rsmithamazon/F1Tower/Designs+Requirements/end_states_final.md

# Split Flap F1 — End States (Final)

## Grid: 5 Columns × 5 Rows (25 units)

---

## ALL END STATES

### 1. Driver Standings (Names)

```
[ 1] [🔴] [N] [O] [R]
[ 2] [◇ ] [L] [E] [C]
[ 3] [★ ] [V] [E] [R]
[ 4] [→ ] [H] [A] [M]
[ 5] [⬡ ] [P] [I] [A]
```

Used: Default race/practice view, standings display

### 2. Driver Standings (Points)

```
[ 1] [🔴] [3] [2] [1]
[ 2] [◇ ] [2] [8] [9]
[ 3] [★ ] [2] [7] [5]
[ 4] [→ ] [2] [5] [0]
[ 5] [⬡ ] [2] [1] [8]
```

Used: Standings cycle (alternates with names)

### 3. Driver Standings (Gap/Time)

```
[+ ] [🔴] [0] [5] [9]
[+ ] [◇ ] [1] [0] [6]
[+ ] [★ ] [1] [1] [7]
[+ ] [→ ] [1] [5] [0]
[+ ] [⬡ ] [3] [1] [3]
```

Used: Practice/Quali gap display

### 4. Name + Gap (2 Rows Per Driver)

```
[ 1] [🔴] [N] [O] [R]
[  ] [- ] [0] [5] [9]
[ 2] [◇ ] [L] [E] [C]
[  ] [- ] [1] [0] [6]
[ 3] [★ ] [V] [E] [R]
```

Used: Detailed timing view (shows 2–3 drivers)

### 5. Constructor Standings (Names)

```
[ 1] [🔴] [F] [E] [R]
[ 2] [→ ] [M] [C] [L]
[ 3] [◇ ] [M] [E] [R]
[ 4] [★ ] [R] [B] [L]
[ 5] [AM] [A] [M] [R]
```

Used: Post-session, standings cycle

### 6. Constructor Standings (Points)

```
[ 1] [🔴] [6] [5] [2]
[ 2] [→ ] [5] [8] [1]
[ 3] [◇ ] [5] [4] [3]
[ 4] [★ ] [4] [9] [2]
[ 5] [AM] [3] [2] [1]
```

Used: Standings cycle (alternates with names)

### 7. Single Driver Focus

```
[🔴] [RED] [RED] [RED] [RED]
[ 1] [🔴] [N]   [O]   [R]
[PUR] [1]  [.]   [1]   [5]
[GRN] [2]  [8]   [.]   [3]
[YEL] [3]  [1]   [.]   [2]
```

Used: Post-quali highlight, replay, fastest lap detail

### 8. Name + Tire/Penalty Color

```
[ 1] [🔴] [N] [O] [RED ]
[ 2] [◇ ] [L] [E] [RED ]
[ 3] [★ ] [V] [E] [YEL ]
[ 4] [→ ] [H] [A] [WHT ]
[ 5] [⬡ ] [P] [I] [GRN ]
```

Used: Race strategy view (showing tire compounds)

### 9. Checkered Flag

```
[BLK] [WHT] [BLK] [WHT] [BLK]
[WHT] [BLK] [WHT] [BLK] [WHT]
[BLK] [WHT] [BLK] [WHT] [BLK]
[WHT] [BLK] [WHT] [BLK] [WHT]
[BLK] [WHT] [BLK] [WHT] [BLK]
```

Used: Race finish

### 10. All Red (Red Flag)

```
[RED] [RED] [RED] [RED] [RED]
[RED] [RED] [RED] [RED] [RED]
[RED] [RED] [RED] [RED] [RED]
[RED] [RED] [RED] [RED] [RED]
[RED] [RED] [RED] [RED] [RED]
```

Used: Red flag — instant transition in

### 11. All Yellow (Yellow Flag)

```
[YEL] [YEL] [YEL] [YEL] [YEL]
[YEL] [YEL] [YEL] [YEL] [YEL]
[YEL] [YEL] [YEL] [YEL] [YEL]
[YEL] [YEL] [YEL] [YEL] [YEL]
[YEL] [YEL] [YEL] [YEL] [YEL]
```

Used: Yellow flag — instant transition in

### 12. Safety Car / VSC (Yellow + Text)

```
[YEL] [YEL] [YEL] [YEL] [YEL]
[YEL] [S]   [A]   [F]   [E]
[YEL] [T]   [Y]   [YEL] [YEL]
[YEL] [C]   [A]   [R]   [YEL]
[YEL] [YEL] [YEL] [YEL] [YEL]
```

VSC variant:
```
[YEL] [YEL] [YEL] [YEL] [YEL]
[YEL] [YEL] [V]   [S]   [C]
[YEL] [YEL] [YEL] [YEL] [YEL]
[YEL] [YEL] [YEL] [YEL] [YEL]
[YEL] [YEL] [YEL] [YEL] [YEL]
```

Used: Safety car / virtual safety car deployed

### 13. All Purple (Fastest Lap Flash)

```
[PUR] [PUR] [PUR] [PUR] [PUR]
[PUR] [PUR] [PUR] [PUR] [PUR]
[PUR] [PUR] [PUR] [PUR] [PUR]
[PUR] [PUR] [PUR] [PUR] [PUR]
[PUR] [PUR] [PUR] [PUR] [PUR]
```

Used: Brief flash when fastest lap is set, then resolves to standings or single driver focus

### 14. All Green (Green Flag / Go)

```
[GRN] [GRN] [GRN] [GRN] [GRN]
[GRN] [GRN] [GRN] [GRN] [GRN]
[GRN] [GRN] [GRN] [GRN] [GRN]
[GRN] [GRN] [GRN] [GRN] [GRN]
[GRN] [GRN] [GRN] [GRN] [GRN]
```

Used: Session start, green flag, race resumed

### 15. All Black (Off / Sleep)

```
[BLK] [BLK] [BLK] [BLK] [BLK]
[BLK] [BLK] [BLK] [BLK] [BLK]
[BLK] [BLK] [BLK] [BLK] [BLK]
[BLK] [BLK] [BLK] [BLK] [BLK]
[BLK] [BLK] [BLK] [BLK] [BLK]
```

Used: Device off state, sleep, pre-startup

### 16. All White (Lights Out / Device On)

```
[WHT] [WHT] [WHT] [WHT] [WHT]
[WHT] [WHT] [WHT] [WHT] [WHT]
[WHT] [WHT] [WHT] [WHT] [WHT]
[WHT] [WHT] [WHT] [WHT] [WHT]
[WHT] [WHT] [WHT] [WHT] [WHT]
```

Used: Lights out resolution + device startup (black → white = "waking up")

### 17. Lights Out Sequence (Race Start)

```
Step 1: [RED] [BLK] [BLK] [BLK] [BLK]  ← 1 light (row 1 → red)
        [BLK] [BLK] [BLK] [BLK] [BLK]
        ...

Step 2: [RED] [RED] [RED] [RED] [RED]   ← row 1 full red
        [RED] [BLK] [BLK] [BLK] [BLK]  ← row 2 starts
        ...

Step 5: ALL RED (5×5)                    ← 5 lights on!
        ... pause ...

Step 6: ALL WHITE                        ← LIGHTS OUT! (red → white = go!)
```

Flap order supports this: colors go dark → light on the drum. Red is before White in drum order, so red → white is a forward flip (fast).

Used: Race start ceremony. Also used as device power-on animation (black → red → white → first display).

### 18. Qualifying Elimination

```
[GRN] [🔴] [N] [O] [R]   ← made it (green)
[GRN] [◇ ] [L] [E] [C]
[GRN] [★ ] [V] [E] [R]
[RED] [→ ] [S] [T] [R]   ← eliminated (red)
[RED] [⬡ ] [B] [E] [A]
```

Used: End of Q1, Q2 rounds

### 19. Race Winner Celebration

```
[ 🏆] [🔴] [RED] [RED] [RED]
[ 1 ] [🔴] [N]   [O]   [R]
[BLK] [BLK] [BLK] [BLK] [BLK]
[ 2 ] [◇ ] [L]   [E]   [C]
[ 3 ] [★ ] [V]   [E]   [R]
```

Used: Post-finish celebration, after checkered + car animation

### 20. Fastest Lap Display

```
[PUR] [PUR] [PUR] [PUR] [PUR]
[ P ] [🔴] [N]   [O]   [R]
[PUR] [1]  [.]   [1]   [5]
[PUR] [9]  [1]   [2]   [PUR]
[PUR] [PUR] [PUR] [PUR] [PUR]
```

Used: After fastest lap is set (follows purple flash)

### 21. Pit Stop (Per Driver Row)

```
[ 1] [🔴] [N] [O] [R]
[ 2] [◇ ] [P] [I] [T]   ← Leclerc in pit (logo stays)
[ 3] [★ ] [V] [E] [R]
[ 4] [→ ] [H] [A] [M]
[ 5] [⬡ ] [P] [I] [A]
```

Used: While driver is in pit lane (single row change)

### 22. Tire Change Indicator (Per Driver)

```
[ 1] [🔴] [N] [O] [R]
[RED] [◇ ] [L] [E] [C]   ← Col 0 shows tire color (soft=red), 5 sec
[ 3] [★ ] [V] [E] [R]
[ 4] [→ ] [H] [A] [M]
[ 5] [⬡ ] [P] [I] [A]
```

Used: After pit exit, shows new compound for 5 sec then back to position number

---

## FLAP DRUM ORDER NOTE

Colors are ordered **dark to light** on the drum:

```
... [Black] → [Red] → [Blue] → [Green] → [Purple] → [Orange] → [Yellow] → [White] ...
```

This ensures:
- Black → any color = forward (fast)
- Red → White = forward (lights out sequence is fast)
- Any color → Black = wraps around (acceptable, used for shutdown)
- Device on: Black (off) → White (on) = forward through all colors = natural "wake up" cascade

---

## END STATE COUNT: 22 TOTAL

| Category | States |
|---|---|
| Standings | 6 (driver name/points/gap, constructor name/points, name+gap 2-row) |
| Detail views | 3 (single driver, tire strategy, quali elimination) |
| Race events | 3 (pit stop, tire change, winner celebration) |
| Flags/Status | 7 (red, yellow, green, purple, SC/VSC, checkered, fastest lap) |
| Utility | 3 (all black, all white, lights out sequence) |
| **Total** | **22** |

---

## POWER ON SEQUENCE

```
1. Device powers on → all flaps at rest (wherever they stopped = random)
2. Home all motors (hall sensor calibration)
3. All go to BLACK (off state) — clean slate
4. Transition: BLACK → WHITE (lights on / wake up)
5. Transition from WHITE → first display mode (selectable: rainbow, cascade, etc.)
```

## POWER OFF SEQUENCE

```
1. Current display → ALL BLACK (cascade down or instant)
2. Motors off
```
