rsmithamazon/F1Tower/Designs+Requirements/Flap dimesnsions.png

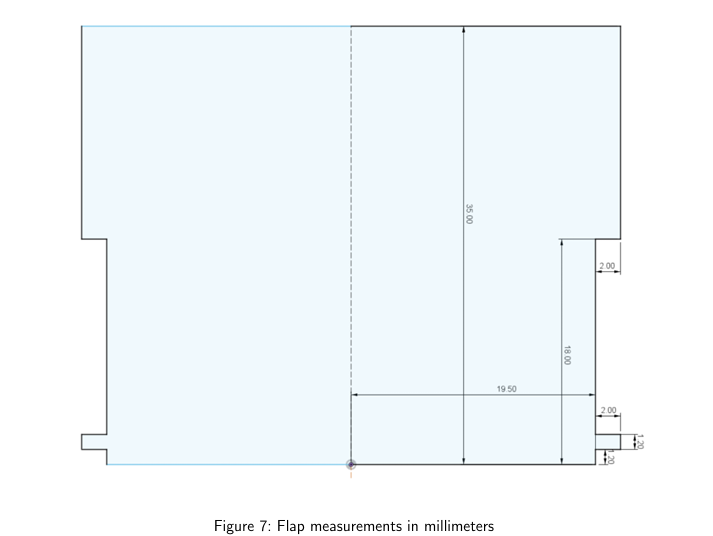
Designs+Requirements/Flap dimesnsions.png
