rsmithamazon/F1Tower/Designs+Requirements/FlapDimensions.png

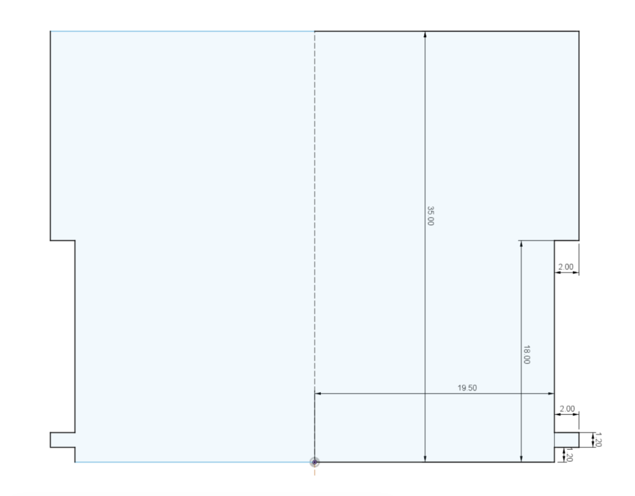
Designs+Requirements/FlapDimensions.png
