rsmithamazon/F1Tower/Split Flap Cut Sheet/Column 0/Flap 3 Yellow/Flap 3 Yellow split_flap_view.png

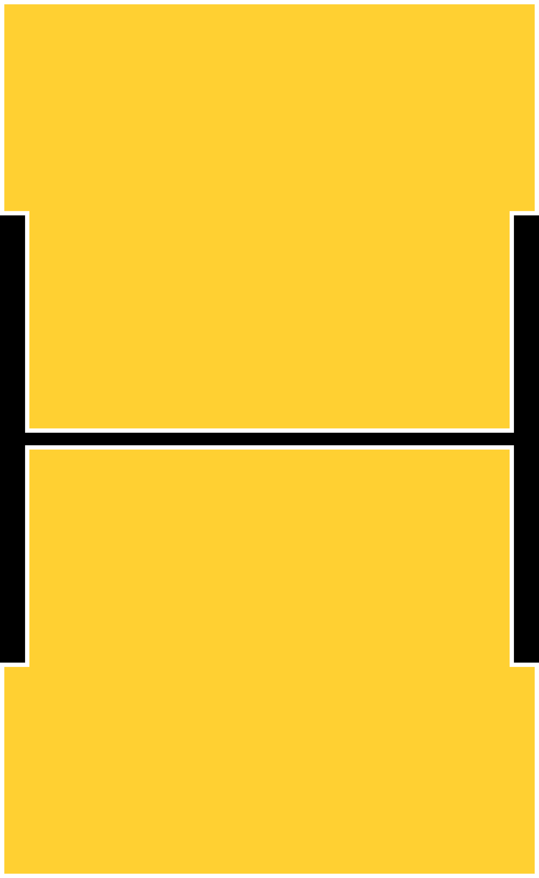
Split Flap Cut Sheet/Column 0/Flap 3 Yellow/Flap 3 Yellow split_flap_view.png
