rsmithamazon/F1Tower/Split Flap Cut Sheet/Column 0/Flap 12 Num 4/Flap 12 Num 4 split_flap_view.png

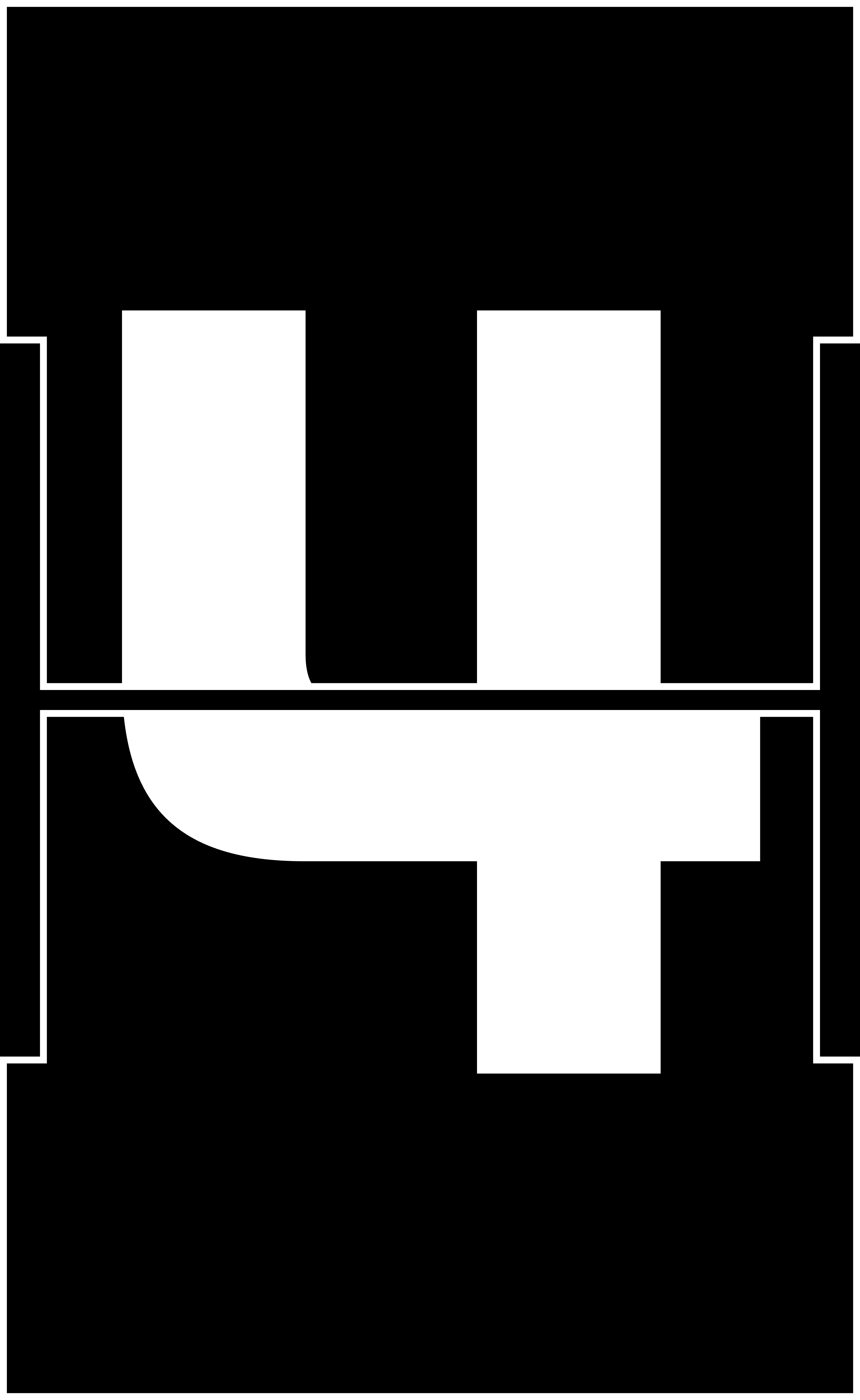
Split Flap Cut Sheet/Column 0/Flap 12 Num 4/Flap 12 Num 4 split_flap_view.png
