rsmithamazon/F1Tower/Split Flap Cut Sheet/Column 0/Flap 14 Num 6/Flap 14 Num 6 split_flap_view.png

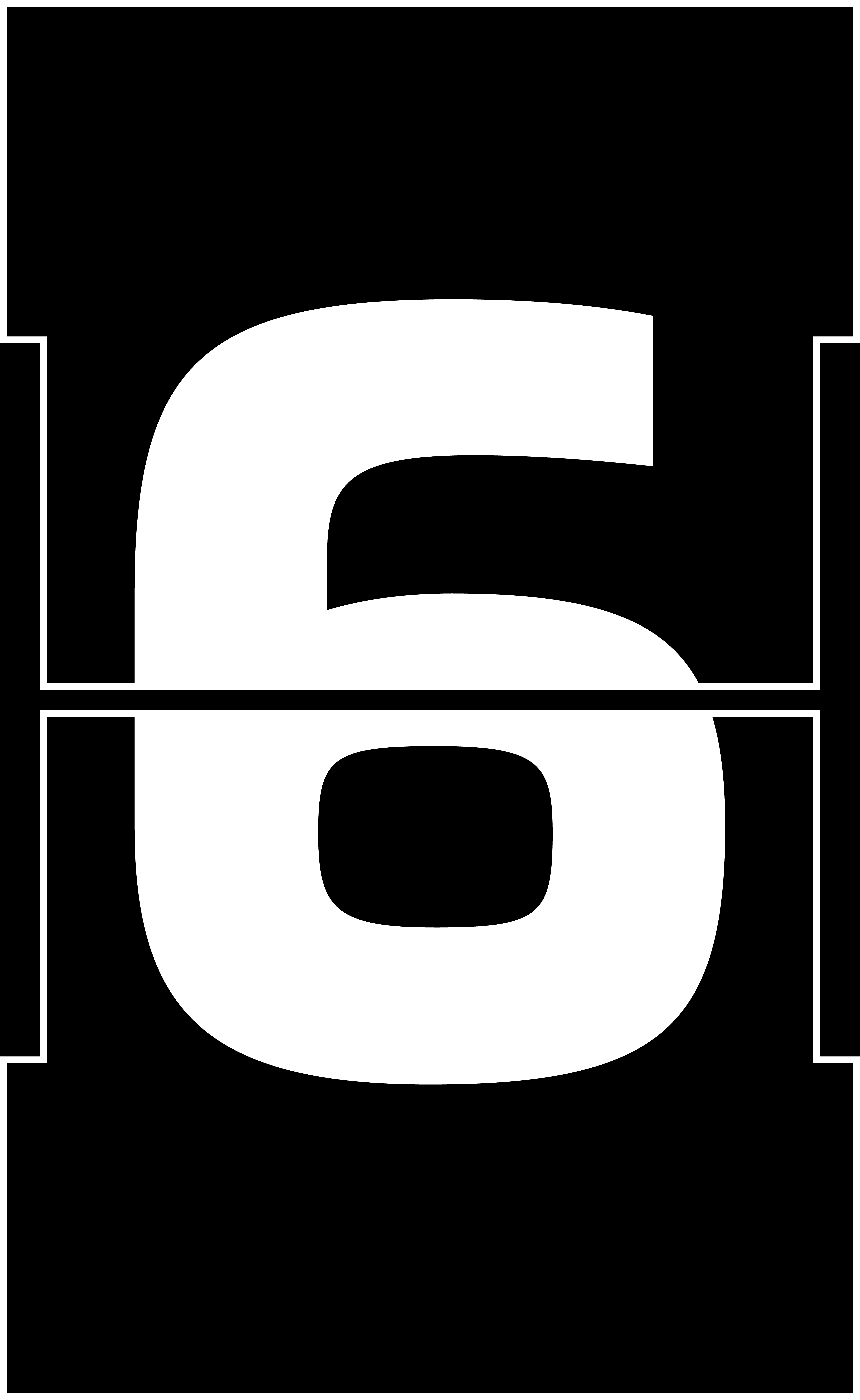
Split Flap Cut Sheet/Column 0/Flap 14 Num 6/Flap 14 Num 6 split_flap_view.png
