rsmithamazon/F1Tower/Split Flap Cut Sheet/Column 0/Flap 15 Num 7/Flap 15 Num 7 split_flap_view.png

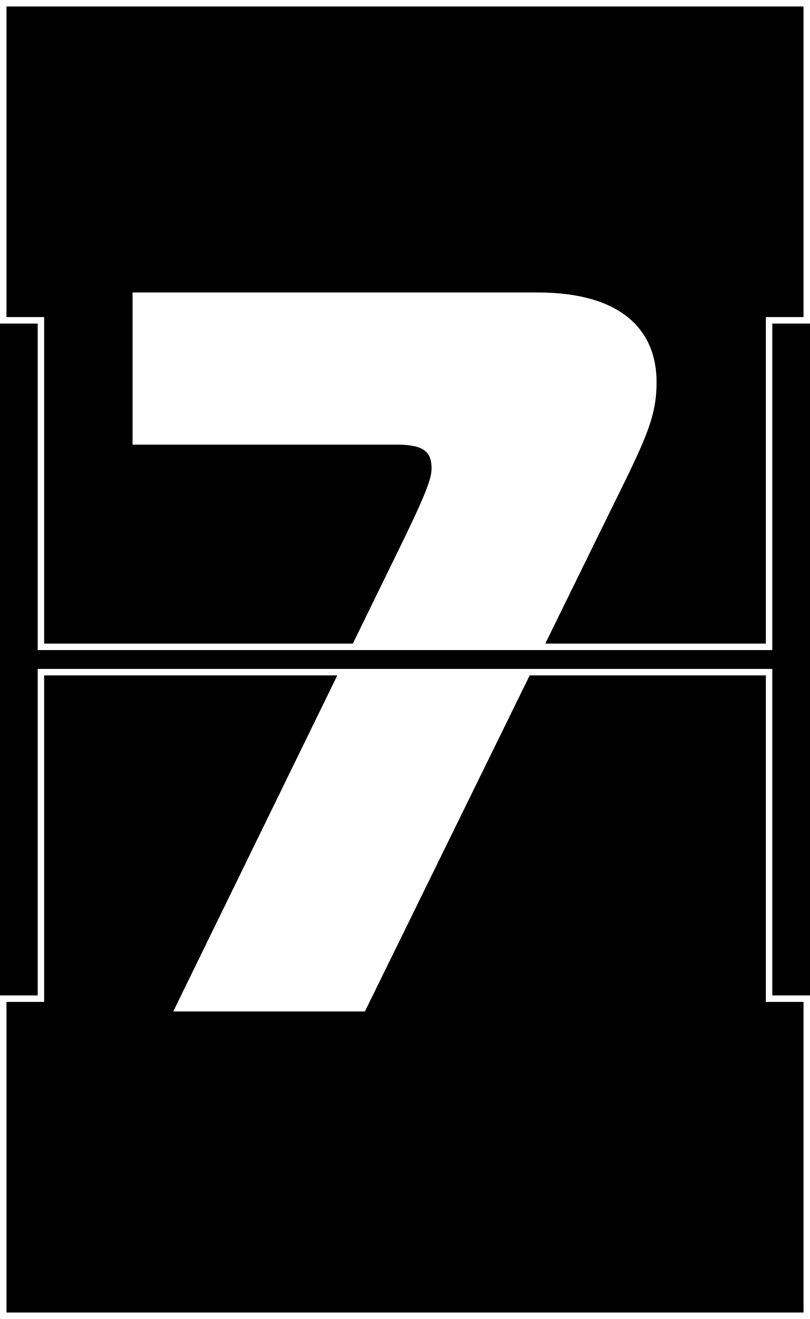
Split Flap Cut Sheet/Column 0/Flap 15 Num 7/Flap 15 Num 7 split_flap_view.png
