rsmithamazon/F1Tower/Split Flap Cut Sheet/Column 0/Flap 22 Mercedes/Flap 22 Mercedes split_flap_view.png

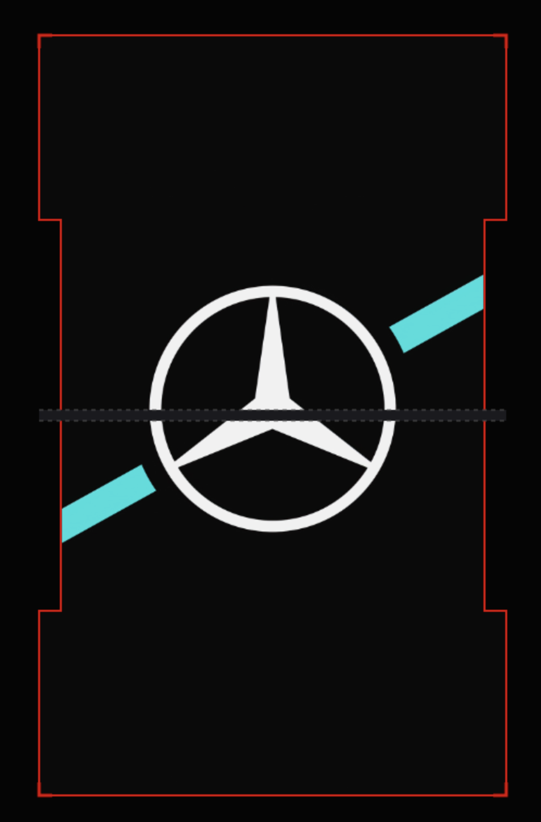
Split Flap Cut Sheet/Column 0/Flap 22 Mercedes/Flap 22 Mercedes split_flap_view.png
