rsmithamazon/F1Tower/Split Flap Cut Sheet/Column 0/Flap 23 Haas/Flap 23 Haas split_flap_view.png

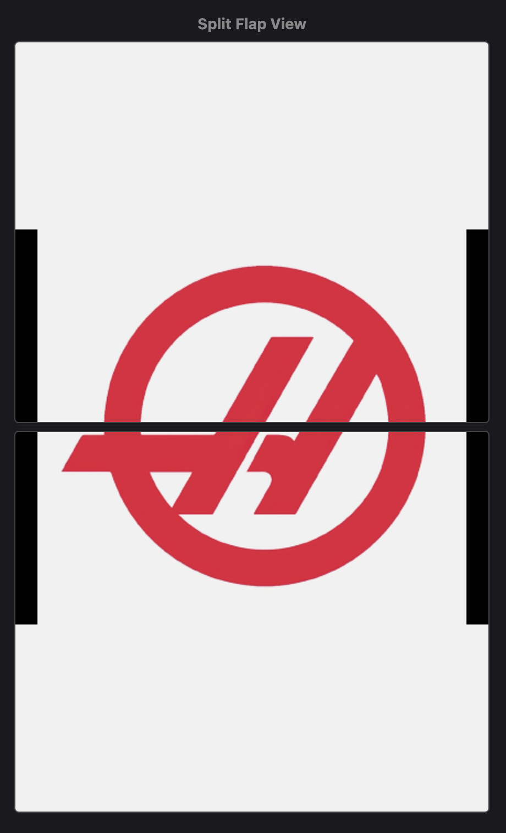
Split Flap Cut Sheet/Column 0/Flap 23 Haas/Flap 23 Haas split_flap_view.png
