rsmithamazon/F1Tower/Split Flap Cut Sheet/Column 0/Flap 24 Alpine/Flap 24 Alpine split_flap_view.png

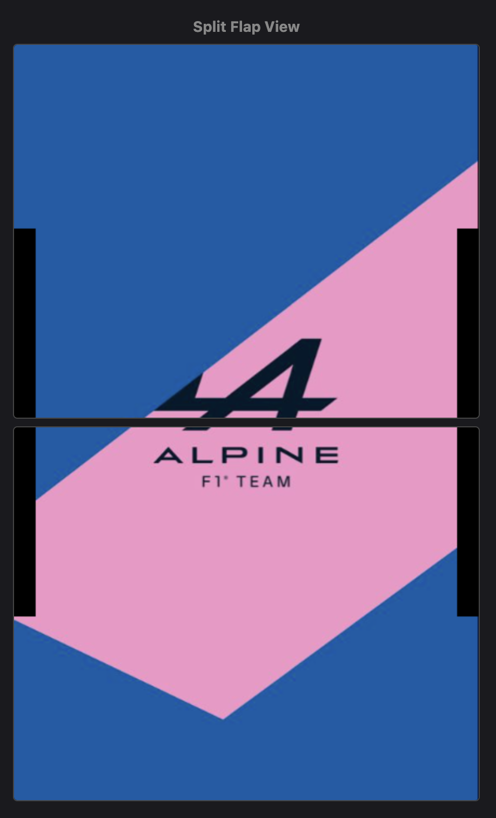
Split Flap Cut Sheet/Column 0/Flap 24 Alpine/Flap 24 Alpine split_flap_view.png
