rsmithamazon/F1Tower/Split Flap Cut Sheet/Column 0/Flap 31 USA/Flap 31 USA split_flap_view.png

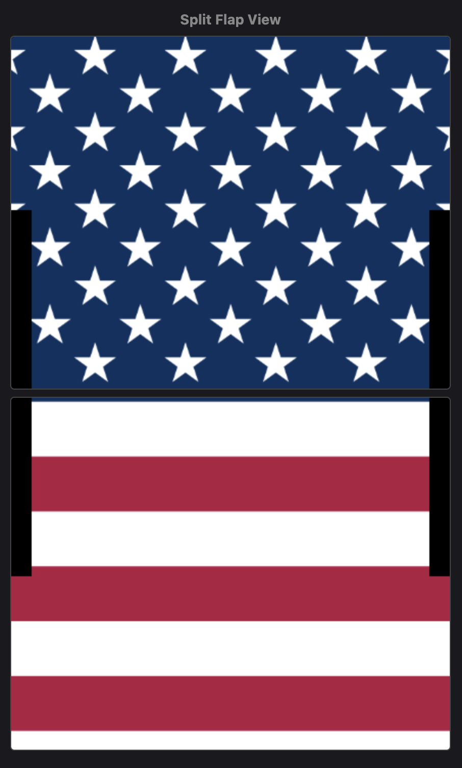
Split Flap Cut Sheet/Column 0/Flap 31 USA/Flap 31 USA split_flap_view.png
