rsmithamazon/F1Tower/Split Flap Cut Sheet/Column 0/Flap 36 Mexico/Flap 36 Mexico split_flap_view.png

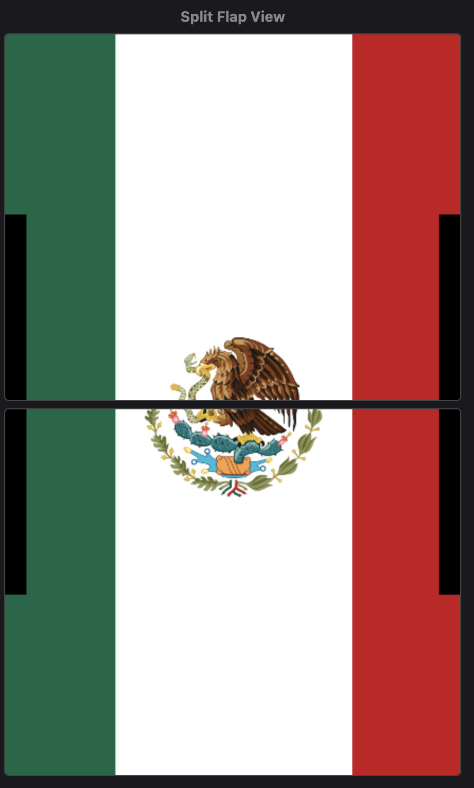
Split Flap Cut Sheet/Column 0/Flap 36 Mexico/Flap 36 Mexico split_flap_view.png
