rsmithamazon/F1Tower/Split Flap Cut Sheet/Column 0/Flap 38 UAE/Flap 38 UAE split_flap_view.png

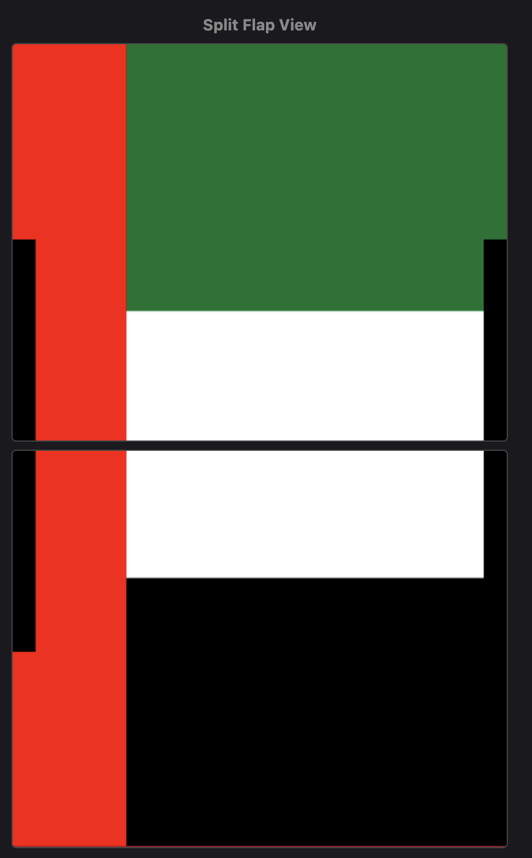
Split Flap Cut Sheet/Column 0/Flap 38 UAE/Flap 38 UAE split_flap_view.png
