rsmithamazon/F1Tower/Split Flap Cut Sheet/Column 0/Flap 40 Bahrain/Flap 40 Bahrain split_flap_view.png

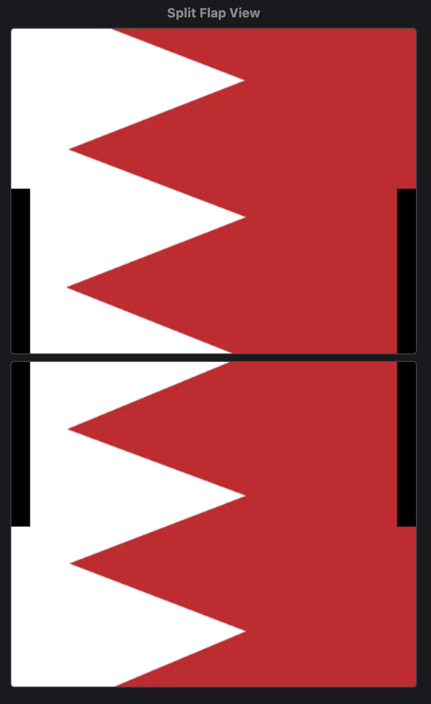
Split Flap Cut Sheet/Column 0/Flap 40 Bahrain/Flap 40 Bahrain split_flap_view.png
