rsmithamazon/F1Tower/Split Flap Cut Sheet/Column 0/Flap 43 Spain/Flap 43 Spain split_flap_view.png

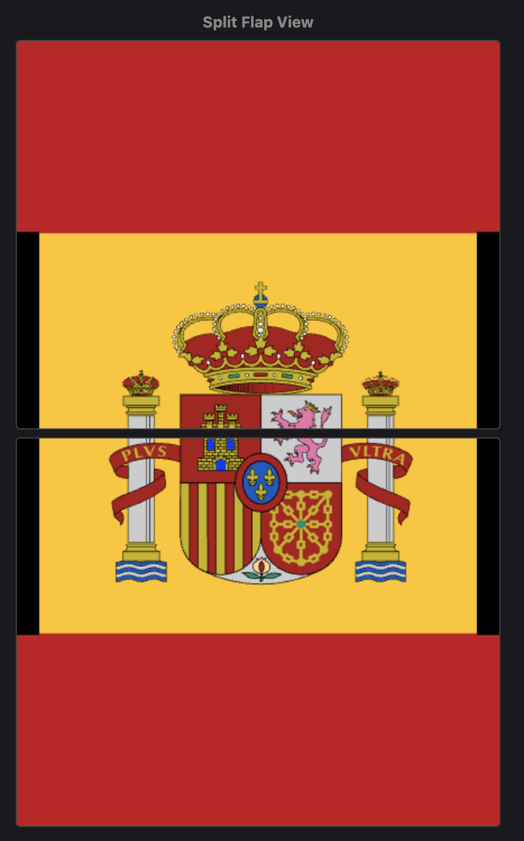
Split Flap Cut Sheet/Column 0/Flap 43 Spain/Flap 43 Spain split_flap_view.png
