rsmithamazon/F1Tower/Split Flap Cut Sheet/Column 0/Flap 49 UK/Flap 49 UK split_flap_view.png

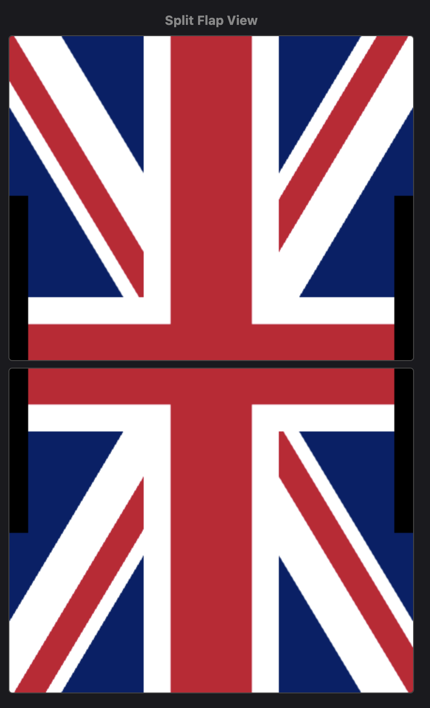
Split Flap Cut Sheet/Column 0/Flap 49 UK/Flap 49 UK split_flap_view.png
