rsmithamazon/F1Tower/Split Flap Cut Sheet/Column 0/Flap 50 Italy/Flap 50 Italy split_flap_view_2.png

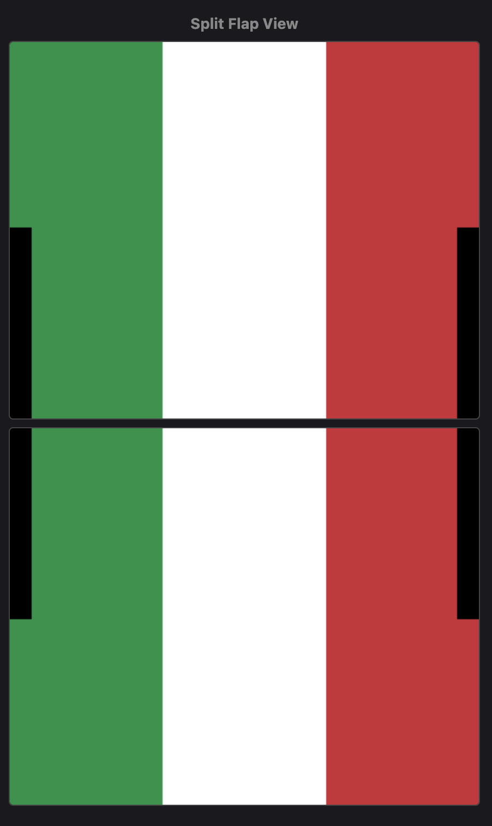
Split Flap Cut Sheet/Column 0/Flap 50 Italy/Flap 50 Italy split_flap_view_2.png
