rsmithamazon/F1Tower/Split Flap Cut Sheet/Column 1/Flap 18 Letter A/Flap 18 Letter A split_flap_view.png

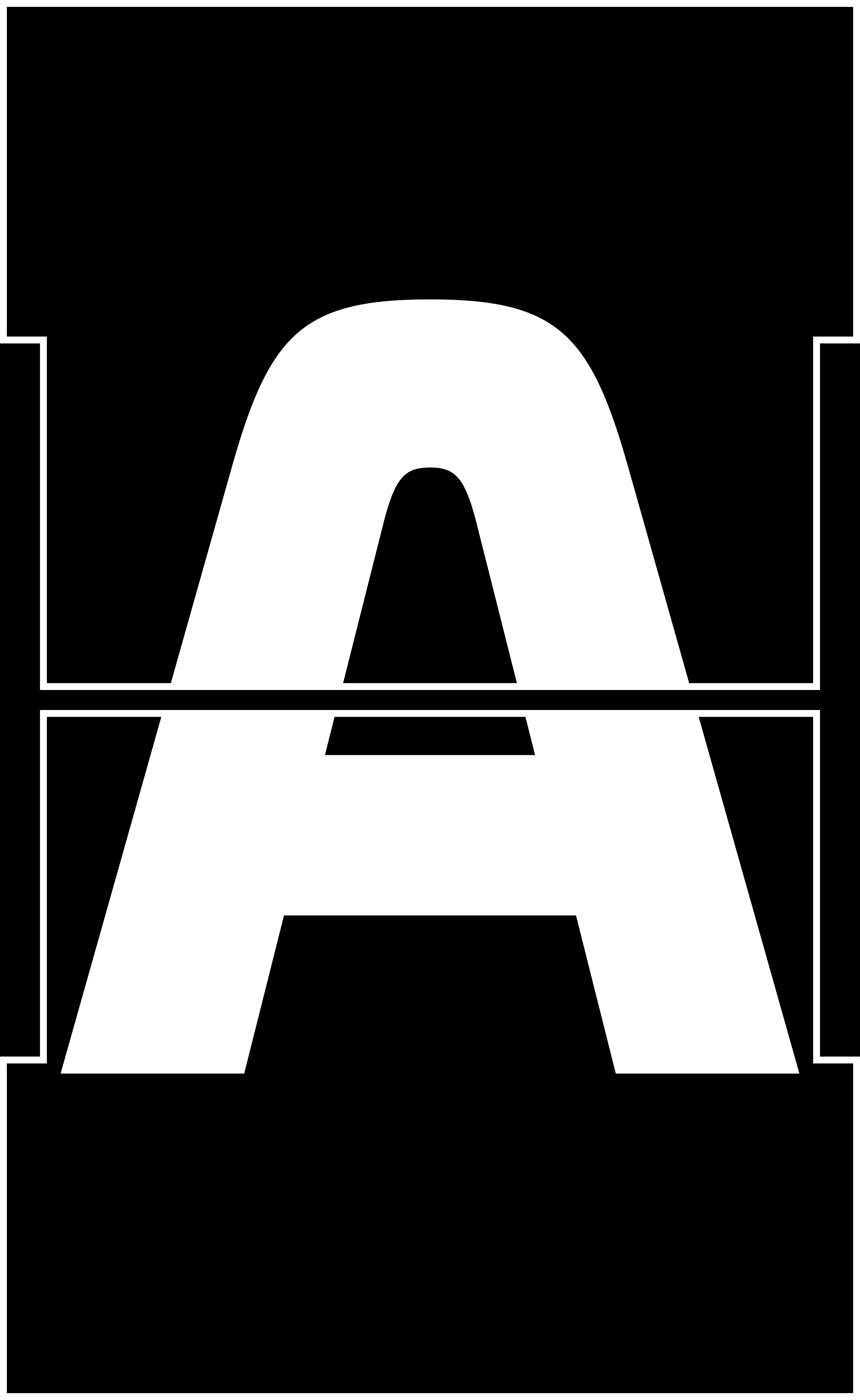
Split Flap Cut Sheet/Column 1/Flap 18 Letter A/Flap 18 Letter A split_flap_view.png
