rsmithamazon/F1Tower/Split Flap Cut Sheet/Column 1/Flap 24 Letter G/Flap 24 Letter G split_flap_view.png

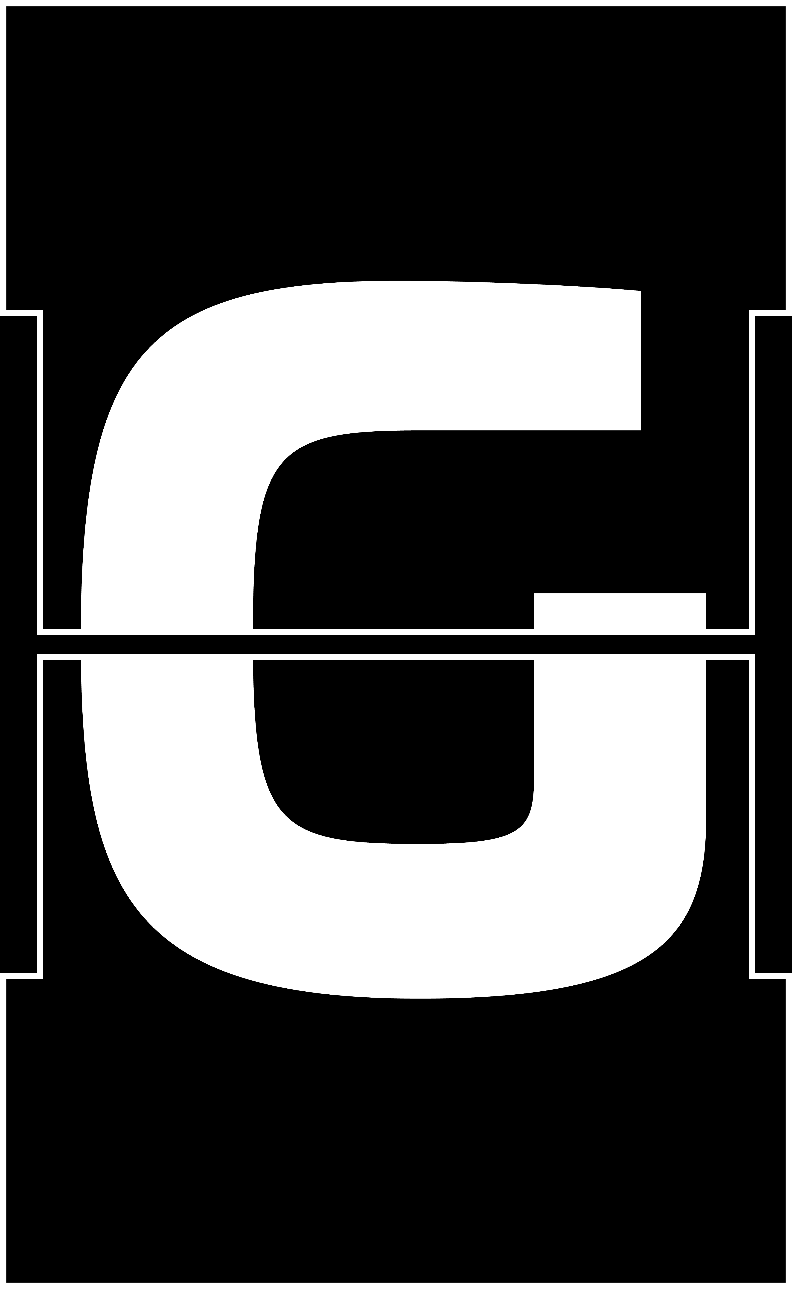
Split Flap Cut Sheet/Column 1/Flap 24 Letter G/Flap 24 Letter G split_flap_view.png
