rsmithamazon/F1Tower/Split Flap Cut Sheet/Column 1/Flap 27 Letter J/Flap 27 Letter J split_flap_view.png

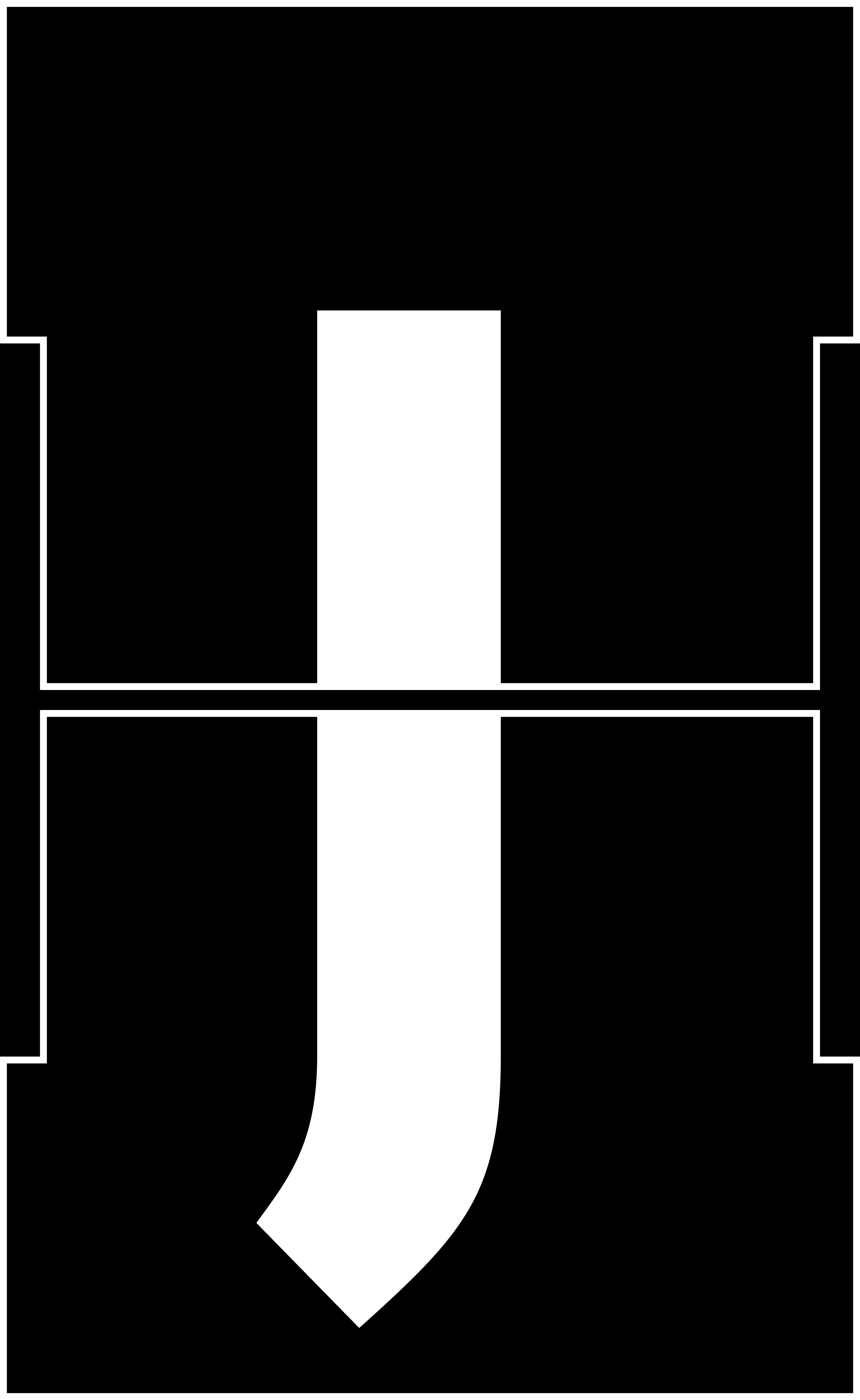
Split Flap Cut Sheet/Column 1/Flap 27 Letter J/Flap 27 Letter J split_flap_view.png
