rsmithamazon/F1Tower/Split Flap Cut Sheet/Column 1/Flap 28 Letter K/Flap 28 Letter K split_flap_view.png

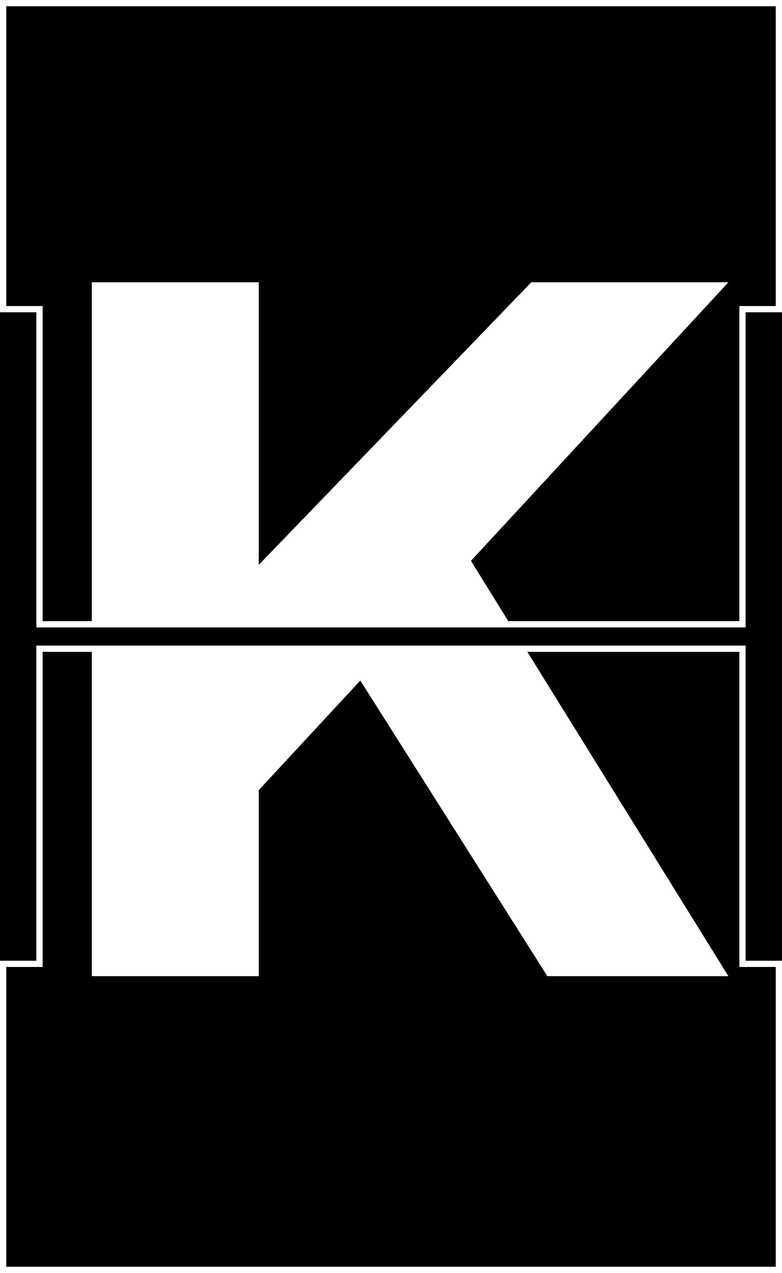
Split Flap Cut Sheet/Column 1/Flap 28 Letter K/Flap 28 Letter K split_flap_view.png
