rsmithamazon/F1Tower/Split Flap Cut Sheet/Column 1/Flap 31 Letter N/Flap 31 Letter N split_flap_view.png

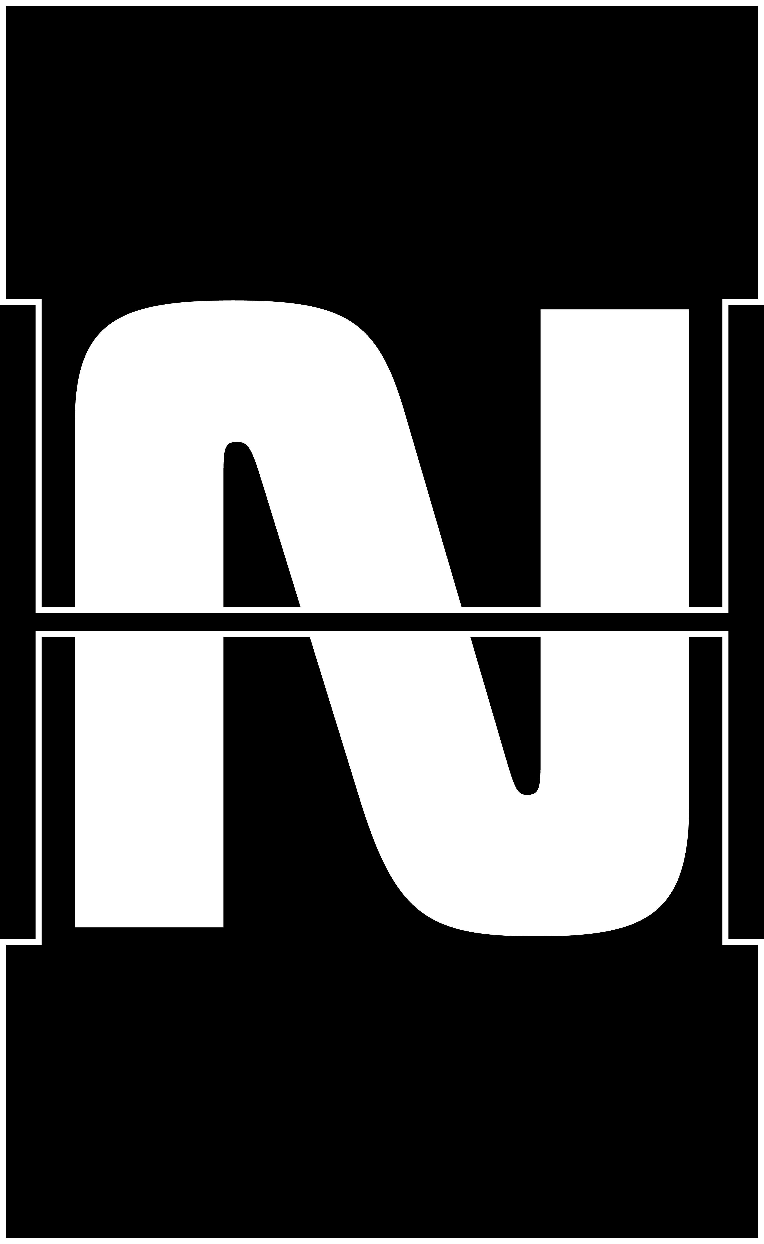
Split Flap Cut Sheet/Column 1/Flap 31 Letter N/Flap 31 Letter N split_flap_view.png
