rsmithamazon/F1Tower/Split Flap Cut Sheet/Column 1/Flap 34 Letter Q/Flap 34 Letter Q split_flap_view.png

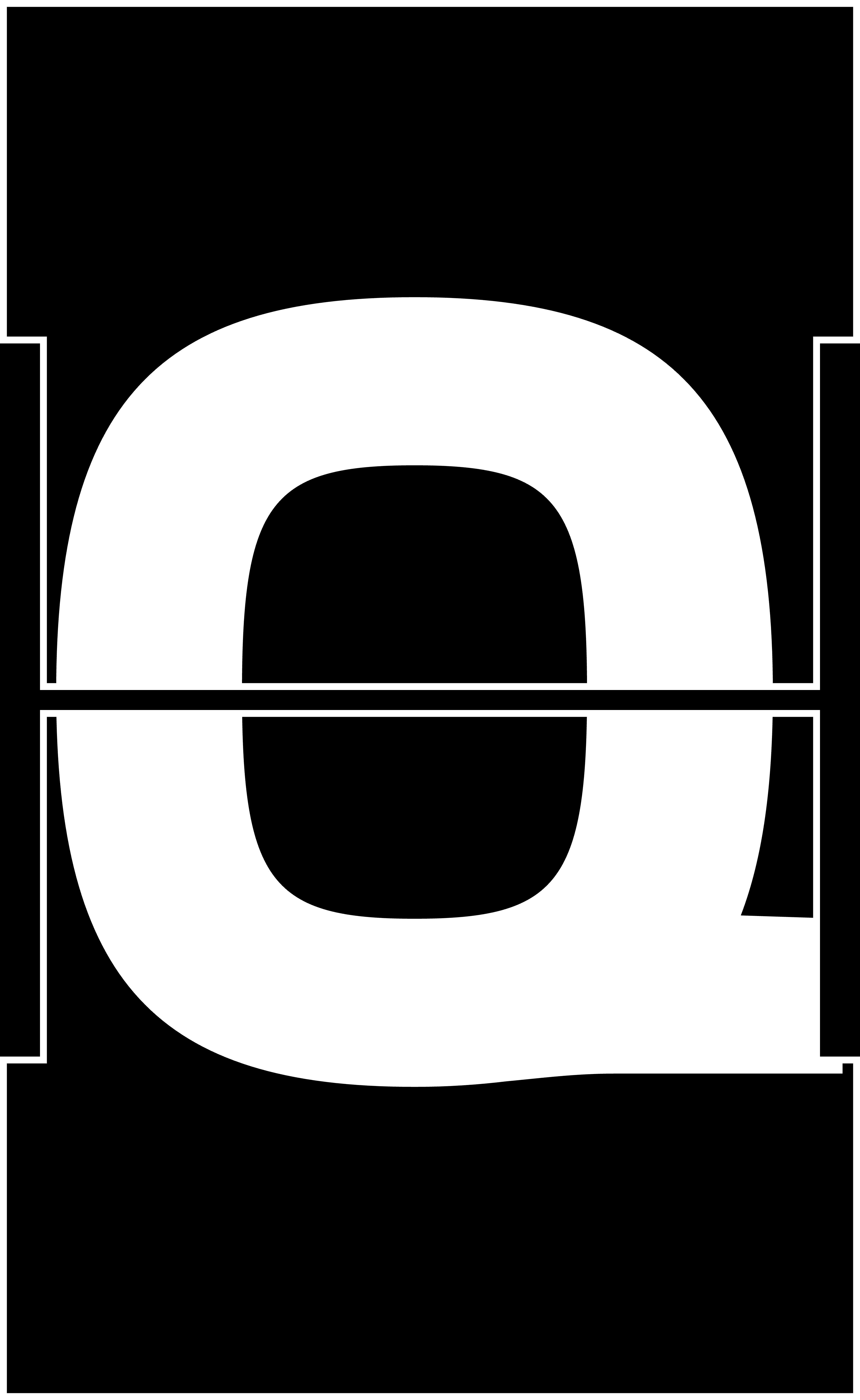
Split Flap Cut Sheet/Column 1/Flap 34 Letter Q/Flap 34 Letter Q split_flap_view.png
