rsmithamazon/F1Tower/Split Flap Cut Sheet/Column 1/Flap 39 Letter V/Flap 39 Letter V split_flap_view.png

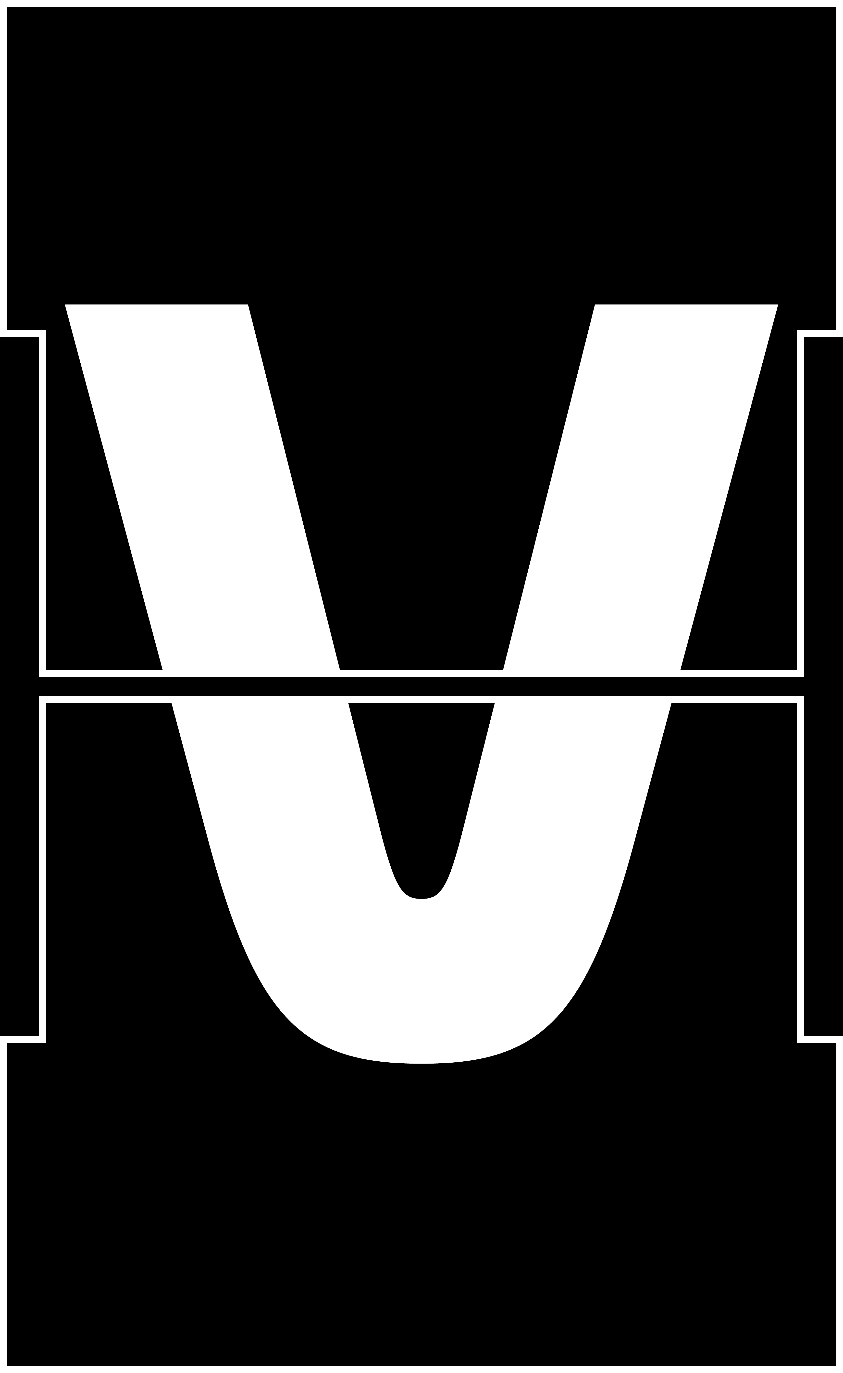
Split Flap Cut Sheet/Column 1/Flap 39 Letter V/Flap 39 Letter V split_flap_view.png
