rsmithamazon/F1Tower/Split Flap Cut Sheet/Column 1/Flap 44 Sunny/Flap 44 Sunny split_flap_view.png

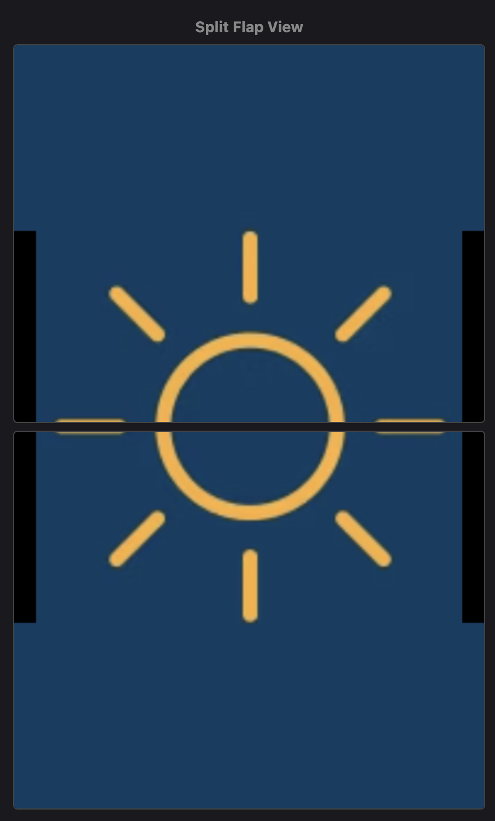
Split Flap Cut Sheet/Column 1/Flap 44 Sunny/Flap 44 Sunny split_flap_view.png
