rsmithamazon/F1Tower/Split Flap Cut Sheet/Column 1/Flap 45 Partly Cloudy/Flap 45 Partly Cloudy split_flap_view.png

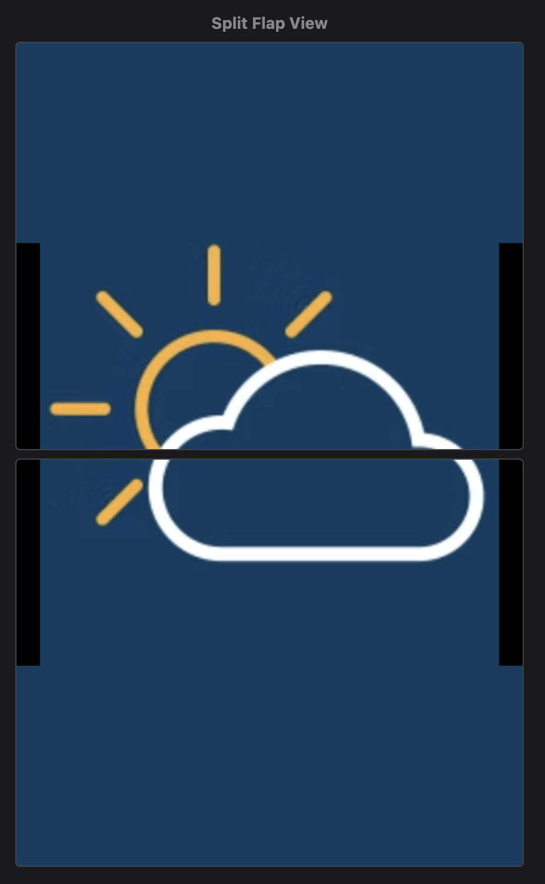
Split Flap Cut Sheet/Column 1/Flap 45 Partly Cloudy/Flap 45 Partly Cloudy split_flap_view.png
