rsmithamazon/F1Tower/Split Flap Cut Sheet/Column 1/Flap 50 Wind/Flap 50 Wind split_flap_view.png

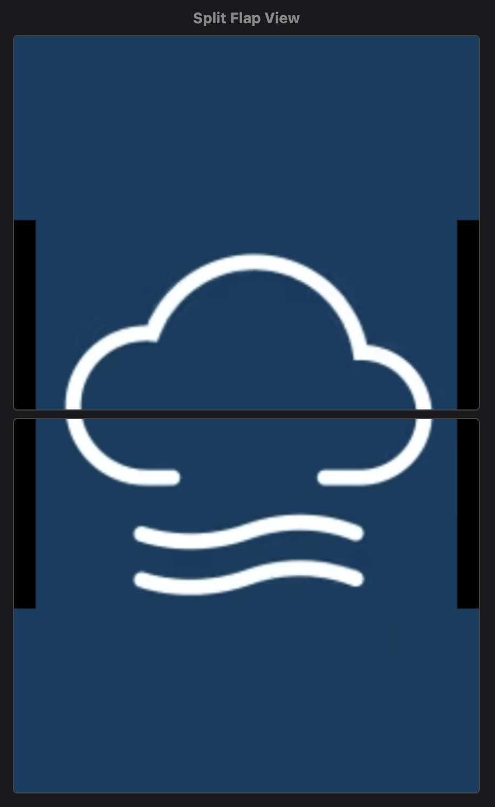
Split Flap Cut Sheet/Column 1/Flap 50 Wind/Flap 50 Wind split_flap_view.png
