rsmithamazon/F1Tower/Split Flap Cut Sheet/Column 1/Flap 51 Thermometer/Flap 51 Thermometer split_flap_view.png

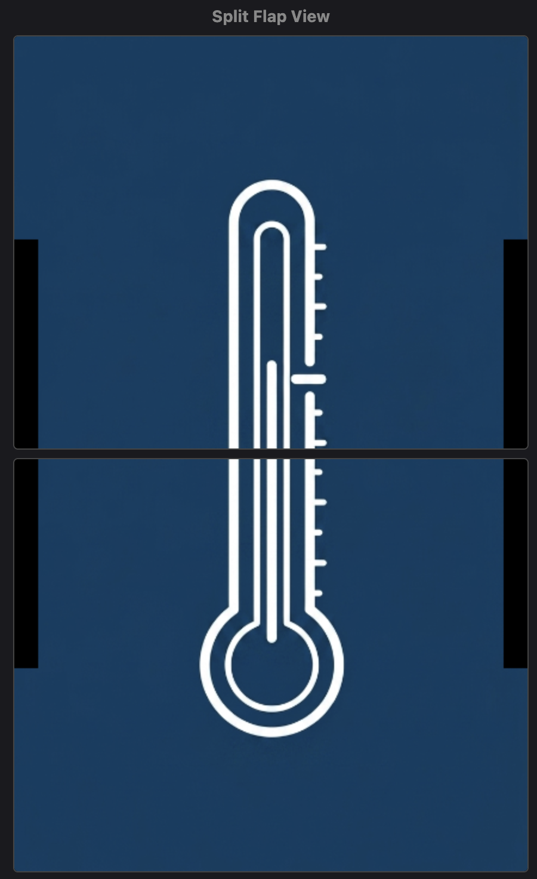
Split Flap Cut Sheet/Column 1/Flap 51 Thermometer/Flap 51 Thermometer split_flap_view.png
