rsmithamazon/F1Tower/Split Flap Cut Sheet/Column 2/Flap 21 Letter D/Flap 21 Letter D split_flap_view.png

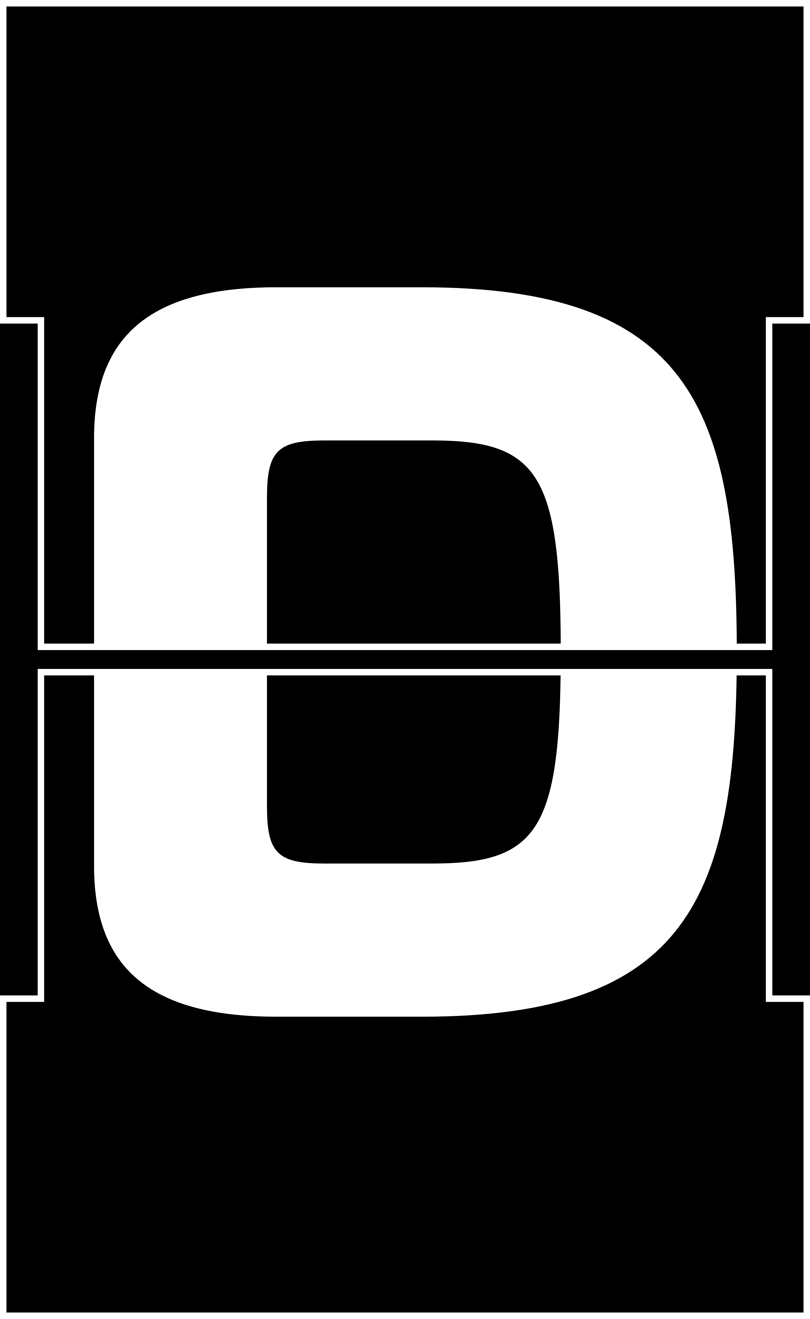
Split Flap Cut Sheet/Column 2/Flap 21 Letter D/Flap 21 Letter D split_flap_view.png
