rsmithamazon/F1Tower/Split Flap Cut Sheet/Column 2/Flap 30 Letter M/Flap 30 Letter M split_flap_view.png

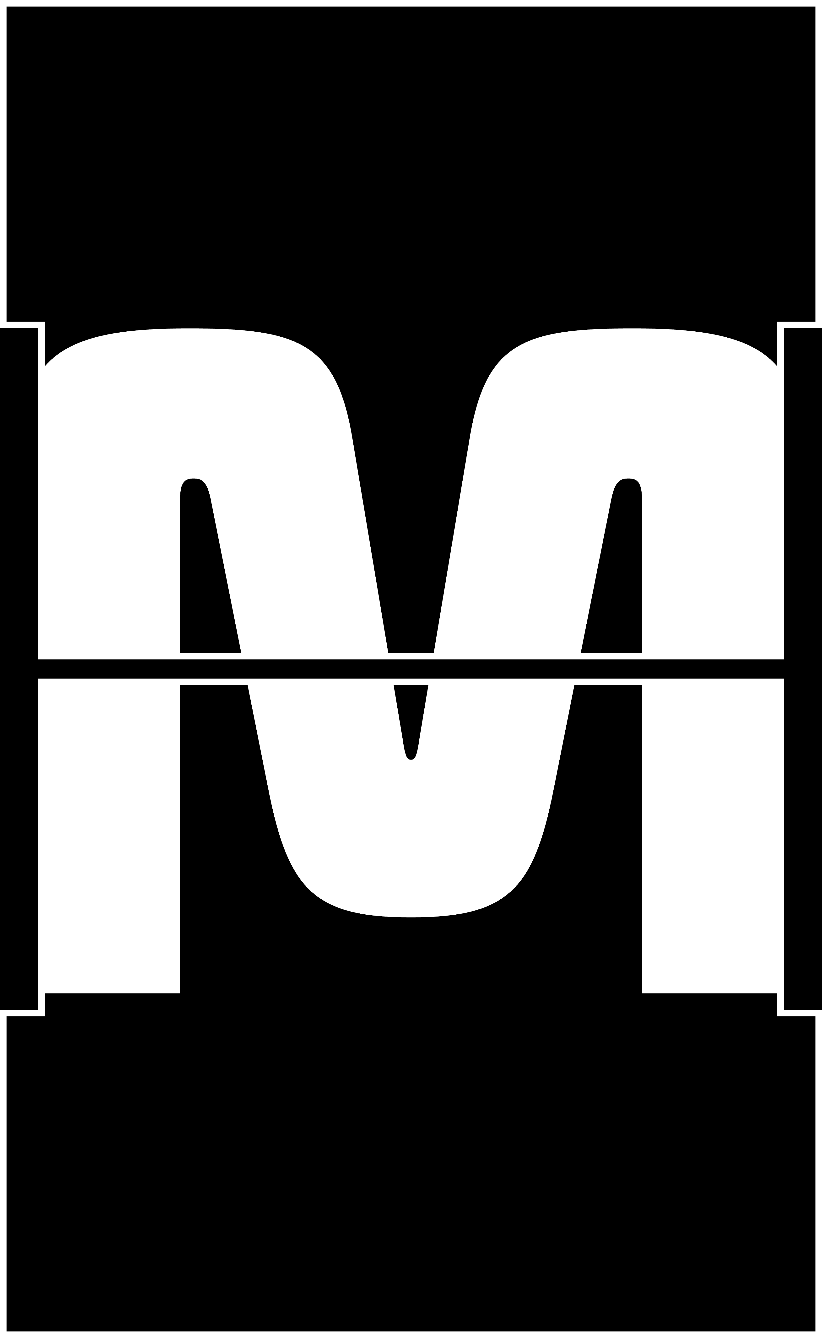
Split Flap Cut Sheet/Column 2/Flap 30 Letter M/Flap 30 Letter M split_flap_view.png
