rsmithamazon/F1Tower/Split Flap Cut Sheet/Column 2/Flap 41 Letter X/Flap 41 Letter X split_flap_view.png

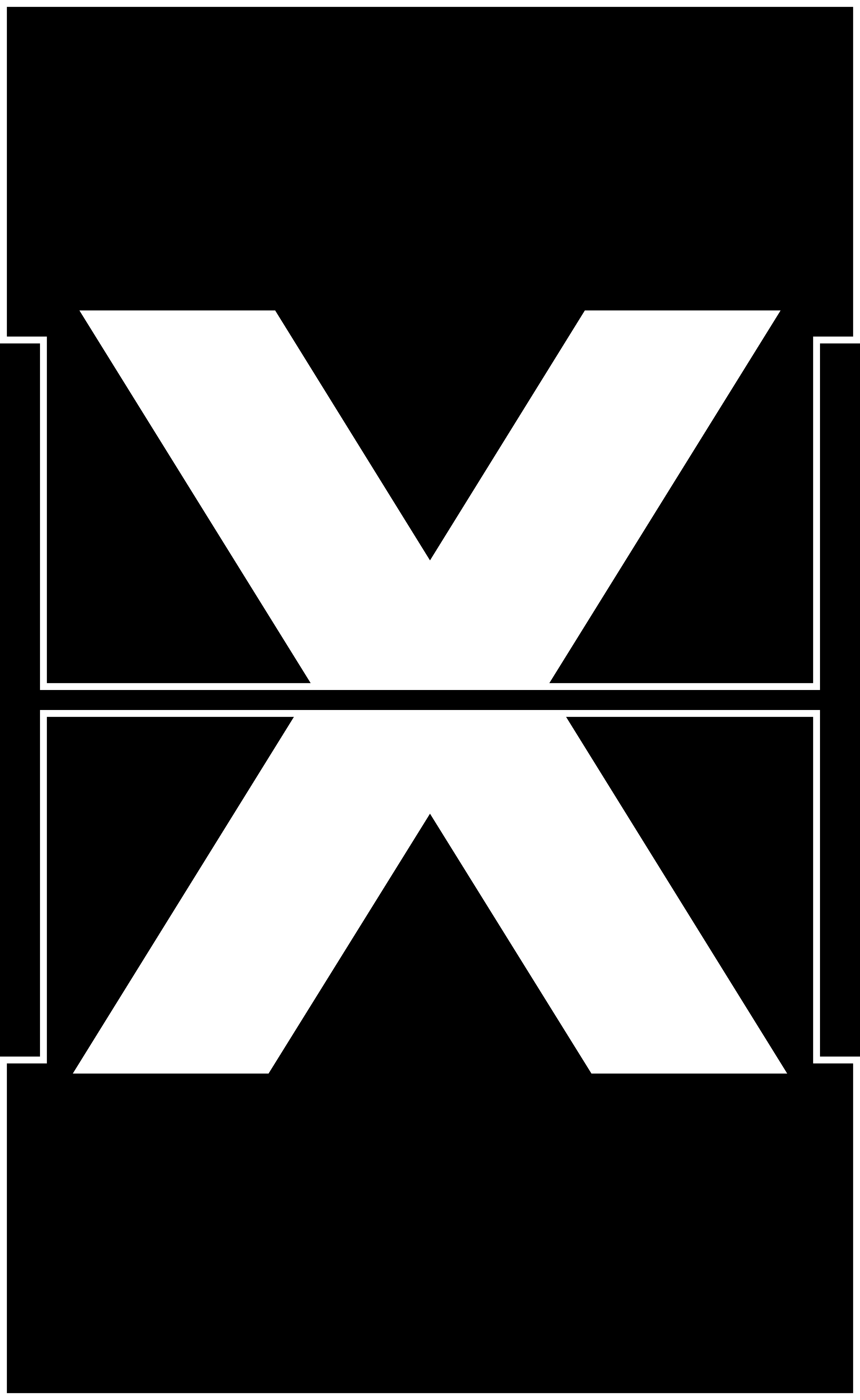
Split Flap Cut Sheet/Column 2/Flap 41 Letter X/Flap 41 Letter X split_flap_view.png
