rsmithamazon/F1Tower/Split Flap Cut Sheet/Column 2/Flap 45 Period/Flap 45 Period split_flap_view.png

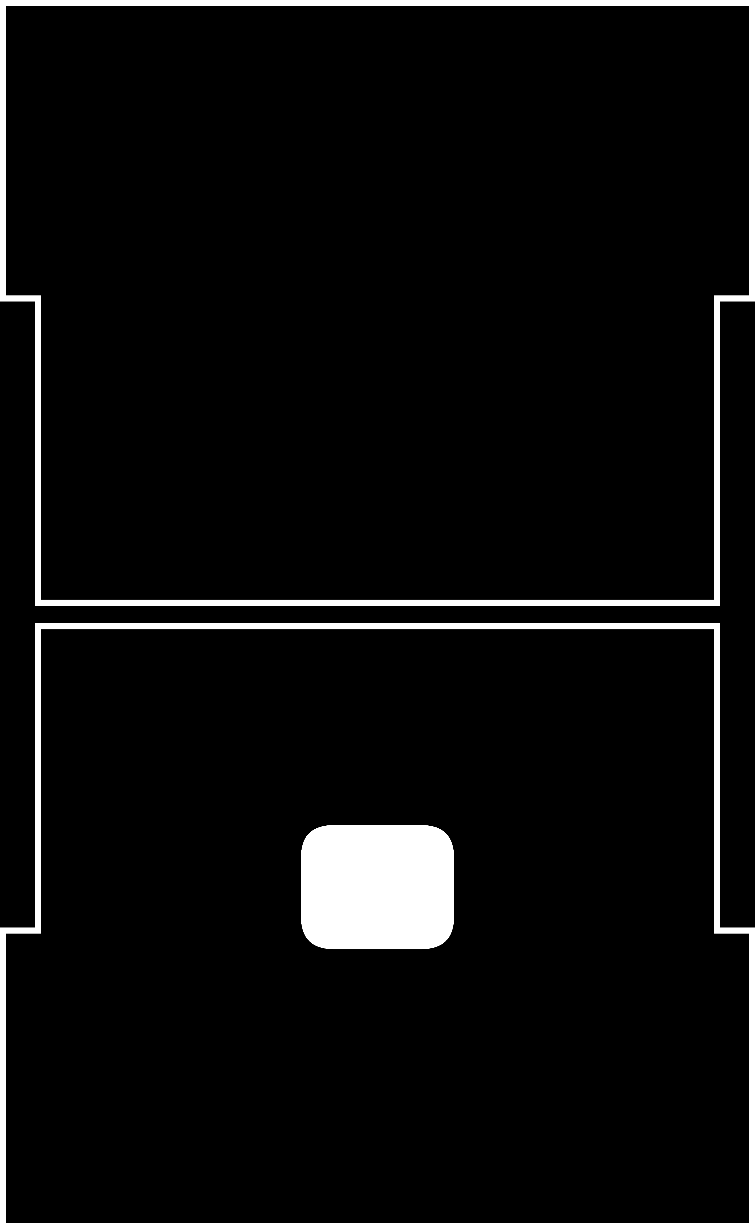
Split Flap Cut Sheet/Column 2/Flap 45 Period/Flap 45 Period split_flap_view.png
