rsmithamazon/F1Tower/Split Flap Cut Sheet/Column 2/Flap 46 Exclamation/Flap 46 Exclamation split_flap_view.png

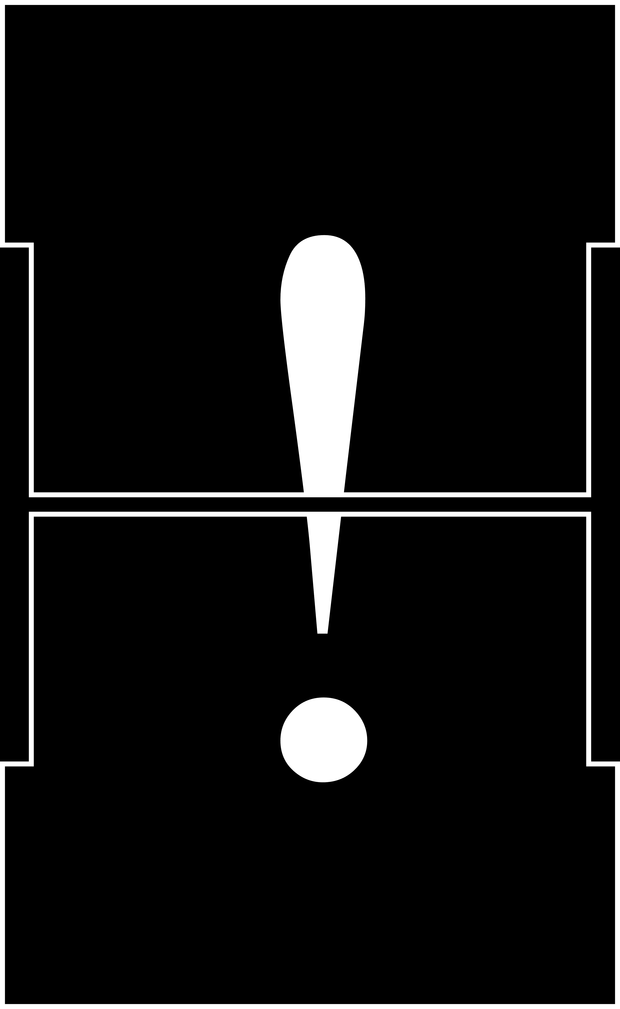
Split Flap Cut Sheet/Column 2/Flap 46 Exclamation/Flap 46 Exclamation split_flap_view.png
