rsmithamazon/F1Tower/Split Flap Cut Sheet/Column 2/Flap 48 Percent/Flap 48 Percent split_flap_view.png

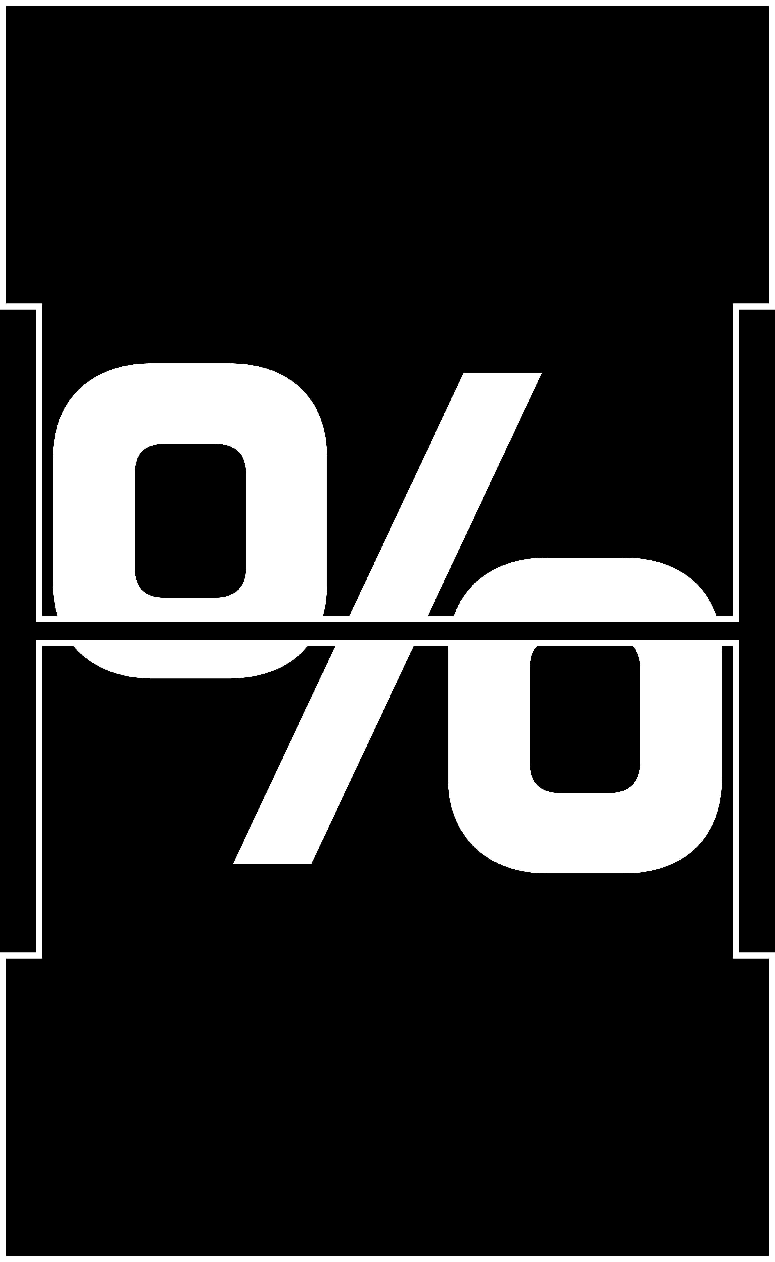
Split Flap Cut Sheet/Column 2/Flap 48 Percent/Flap 48 Percent split_flap_view.png
