rsmithamazon/F1Tower/Split Flap Cut Sheet/Column 2/Flap 51 Colon/Flap 51 Colon split_flap_view.png

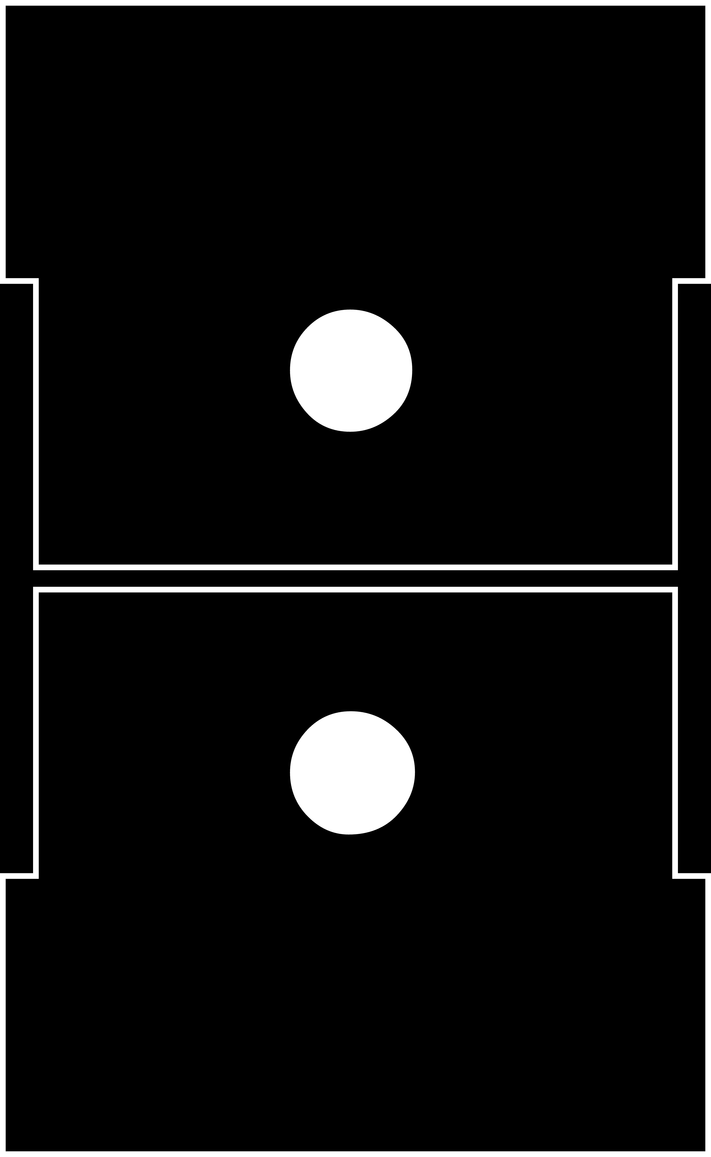
Split Flap Cut Sheet/Column 2/Flap 51 Colon/Flap 51 Colon split_flap_view.png
