rsmithamazon/F1Tower/Split Flap Cut Sheet/Column 3/Flap 22 Letter E/Flap 22 Letter E split_flap_view.png

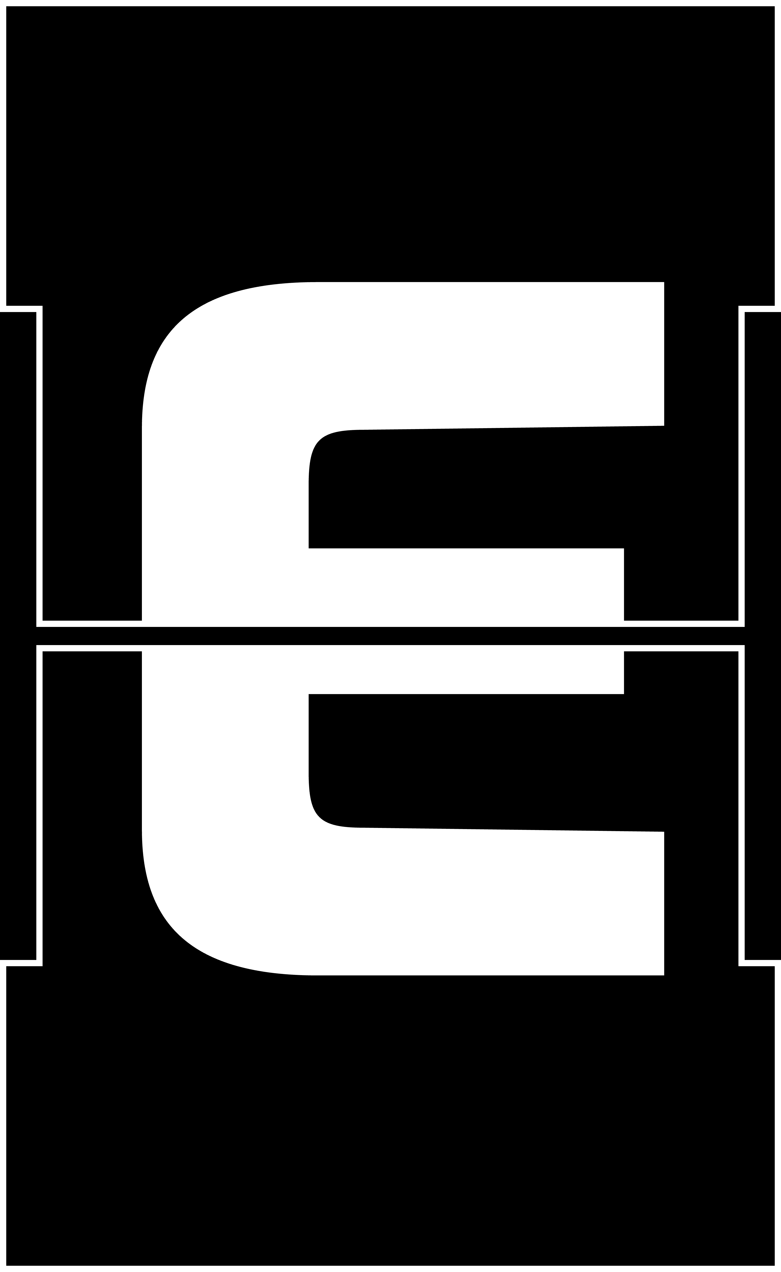
Split Flap Cut Sheet/Column 3/Flap 22 Letter E/Flap 22 Letter E split_flap_view.png
