rsmithamazon/F1Tower/Split Flap Cut Sheet/Column 3/Flap 25 Letter H/Flap 25 Letter H split_flap_view.png

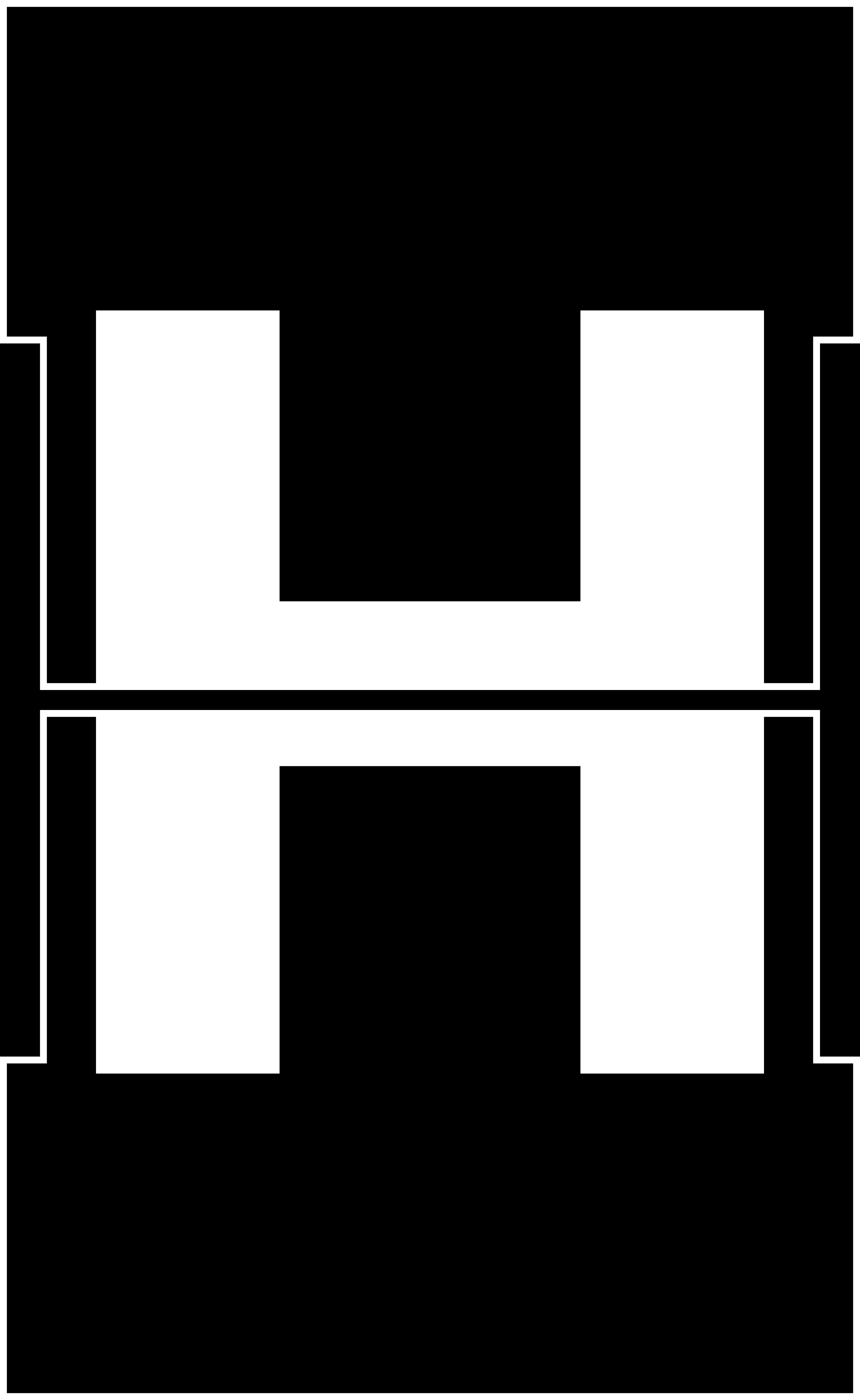
Split Flap Cut Sheet/Column 3/Flap 25 Letter H/Flap 25 Letter H split_flap_view.png
