rsmithamazon/F1Tower/Split Flap Cut Sheet/Column 3/Flap 36 Letter S/Flap 36 Letter S split_flap_view.png

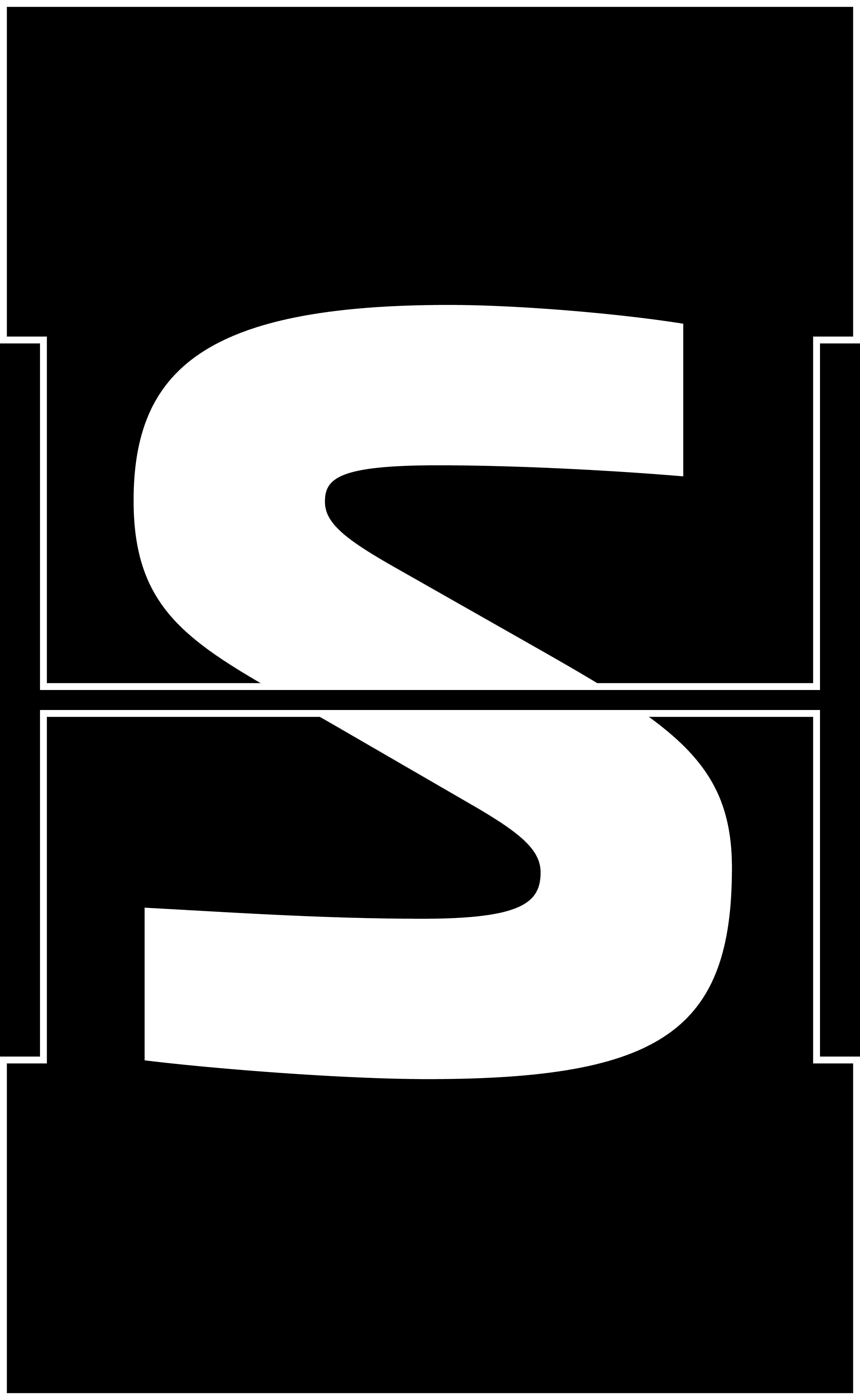
Split Flap Cut Sheet/Column 3/Flap 36 Letter S/Flap 36 Letter S split_flap_view.png
