rsmithamazon/F1Tower/Split Flap Cut Sheet/Column 3/Flap 37 Letter T/Flap 37 Letter T split_flap_view.png

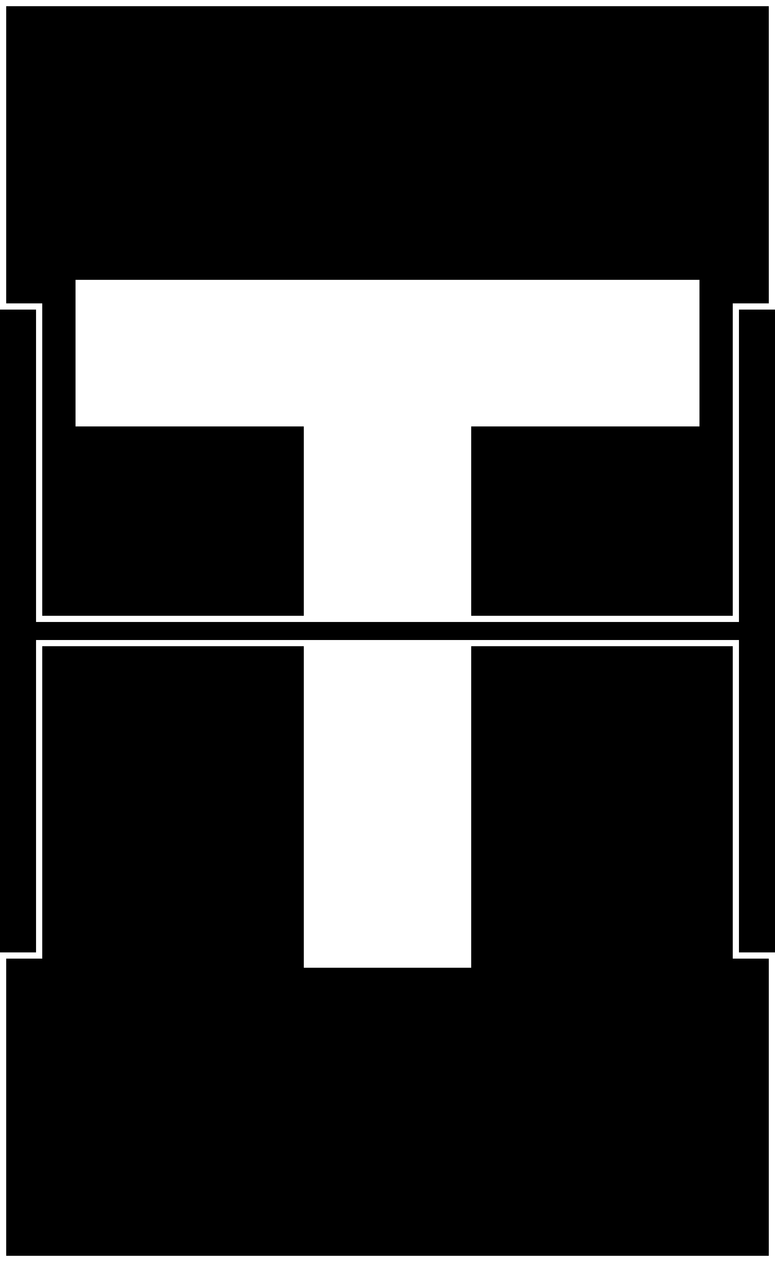
Split Flap Cut Sheet/Column 3/Flap 37 Letter T/Flap 37 Letter T split_flap_view.png
