rsmithamazon/F1Tower/Split Flap Cut Sheet/Column 3/Flap 38 Letter U/Flap 38 Letter U split_flap_view.png

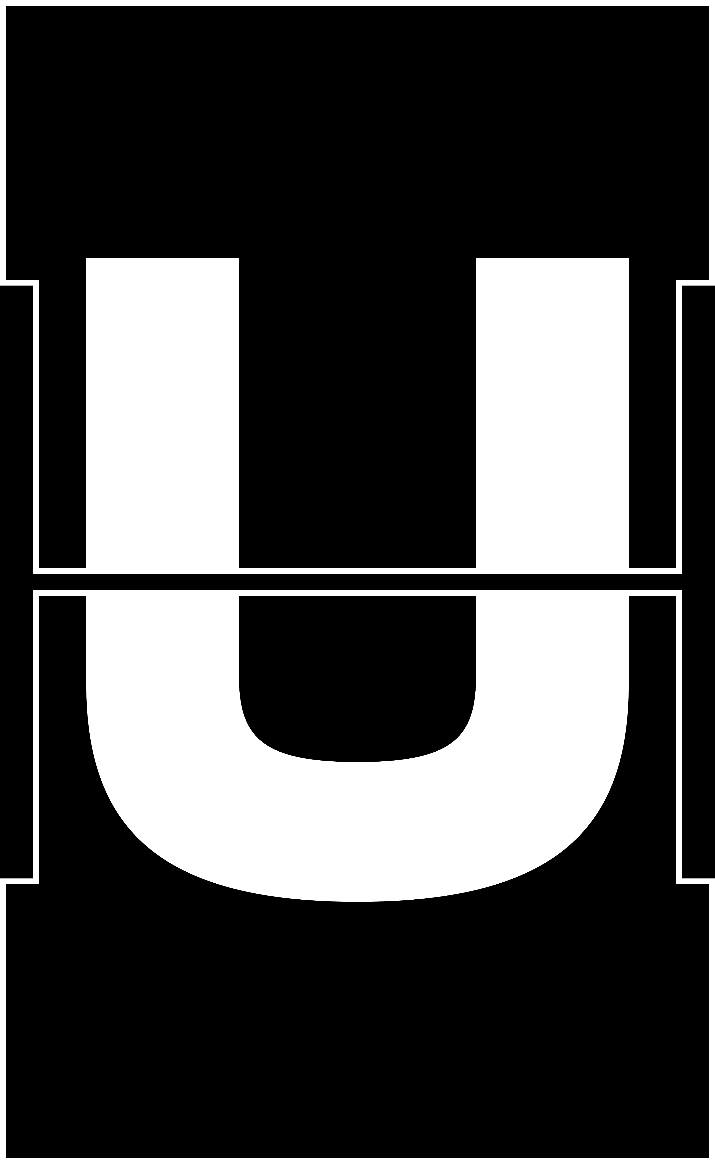
Split Flap Cut Sheet/Column 3/Flap 38 Letter U/Flap 38 Letter U split_flap_view.png
