rsmithamazon/F1Tower/Split Flap Cut Sheet/Column 3/Flap 43 Letter Z/Flap 43 Letter Z split_flap_view.png

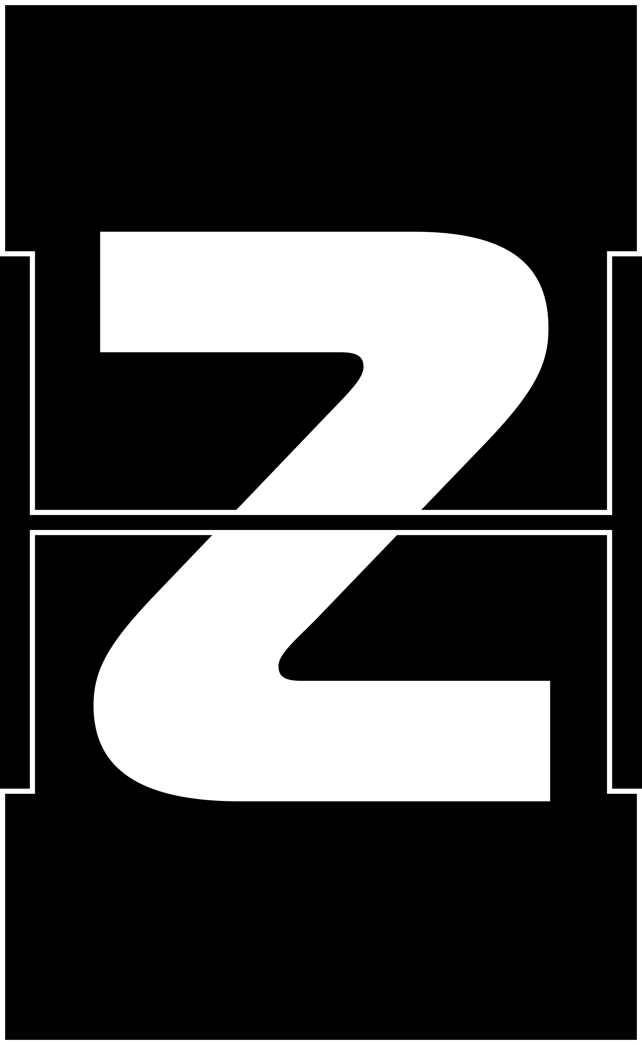
Split Flap Cut Sheet/Column 3/Flap 43 Letter Z/Flap 43 Letter Z split_flap_view.png
