rsmithamazon/F1Tower/Split Flap Cut Sheet/Column 4/Flap 20 Letter C/Flap 20 Letter C split_flap_view.png

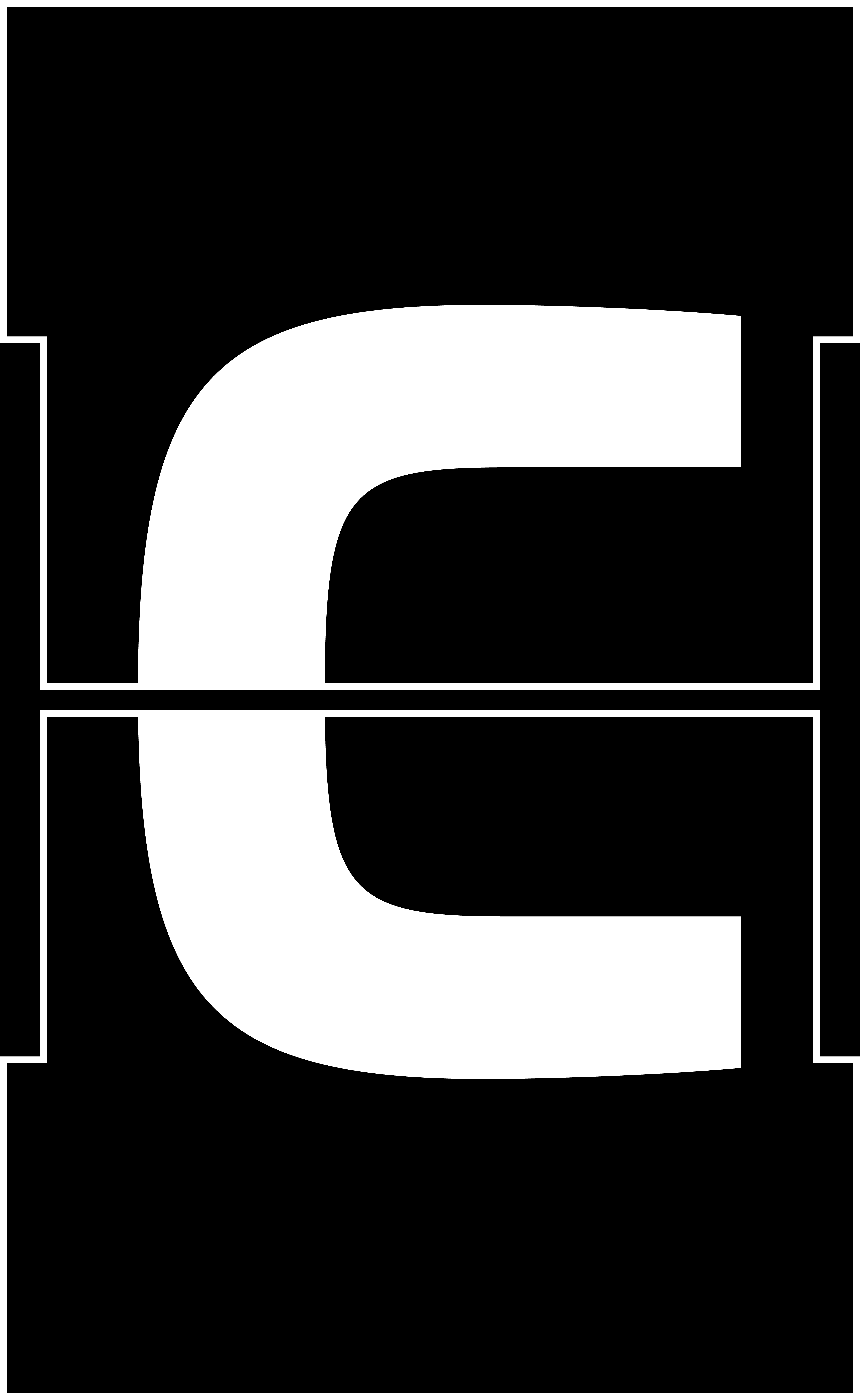
Split Flap Cut Sheet/Column 4/Flap 20 Letter C/Flap 20 Letter C split_flap_view.png
