rsmithamazon/F1Tower/Split Flap Cut Sheet/Column 4/Flap 33 Letter P/Flap 33 Letter P split_flap_view.png

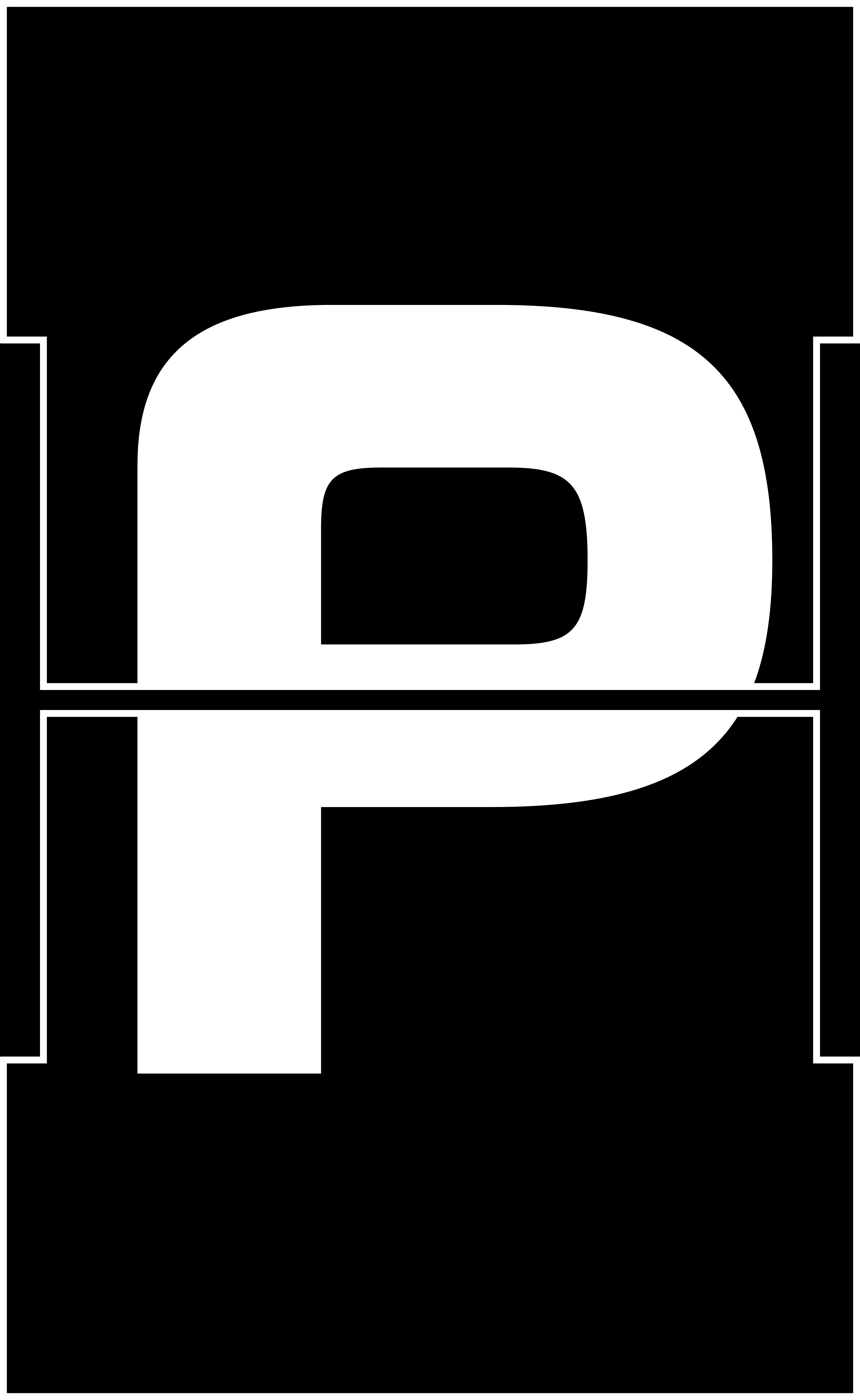
Split Flap Cut Sheet/Column 4/Flap 33 Letter P/Flap 33 Letter P split_flap_view.png
