rsmithamazon/F1Tower/Split Flap Cut Sheet/Column 4/Flap 42 Letter Y/Flap 42 Letter Y split_flap_view.png

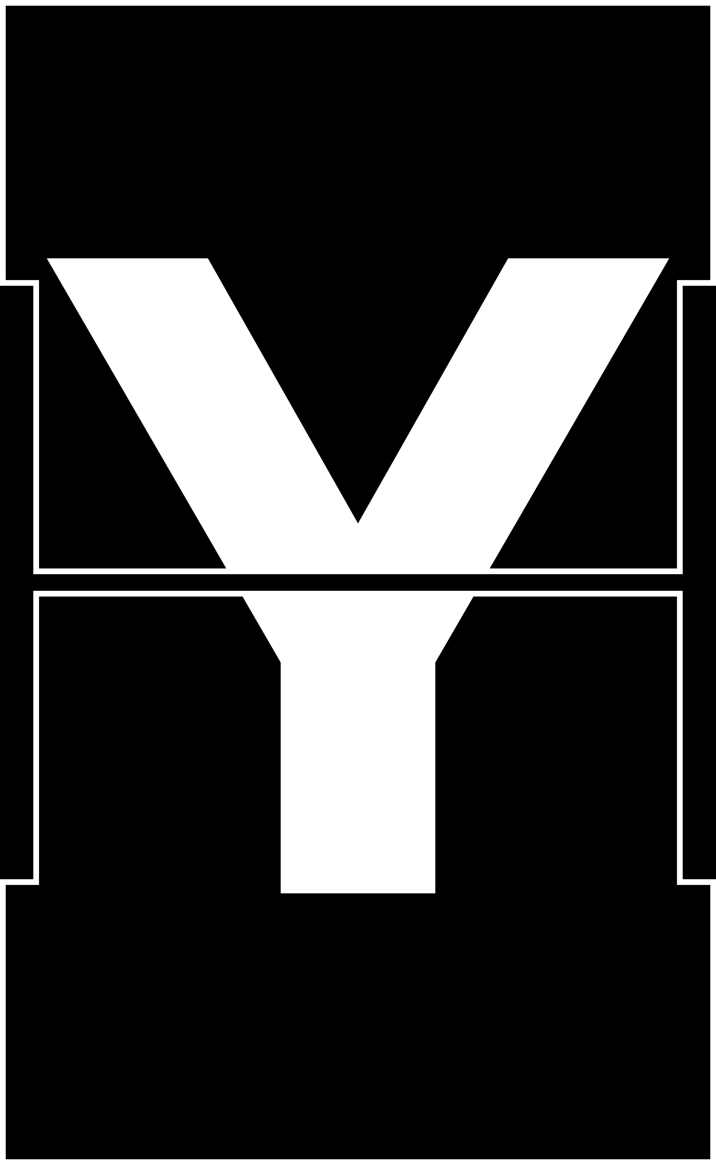
Split Flap Cut Sheet/Column 4/Flap 42 Letter Y/Flap 42 Letter Y split_flap_view.png
