rsmithamazon/F1Tower/Split Flap Cut Sheet/Column 4/Flap 44 Dash/Flap 44 Dash split_flap_view.png

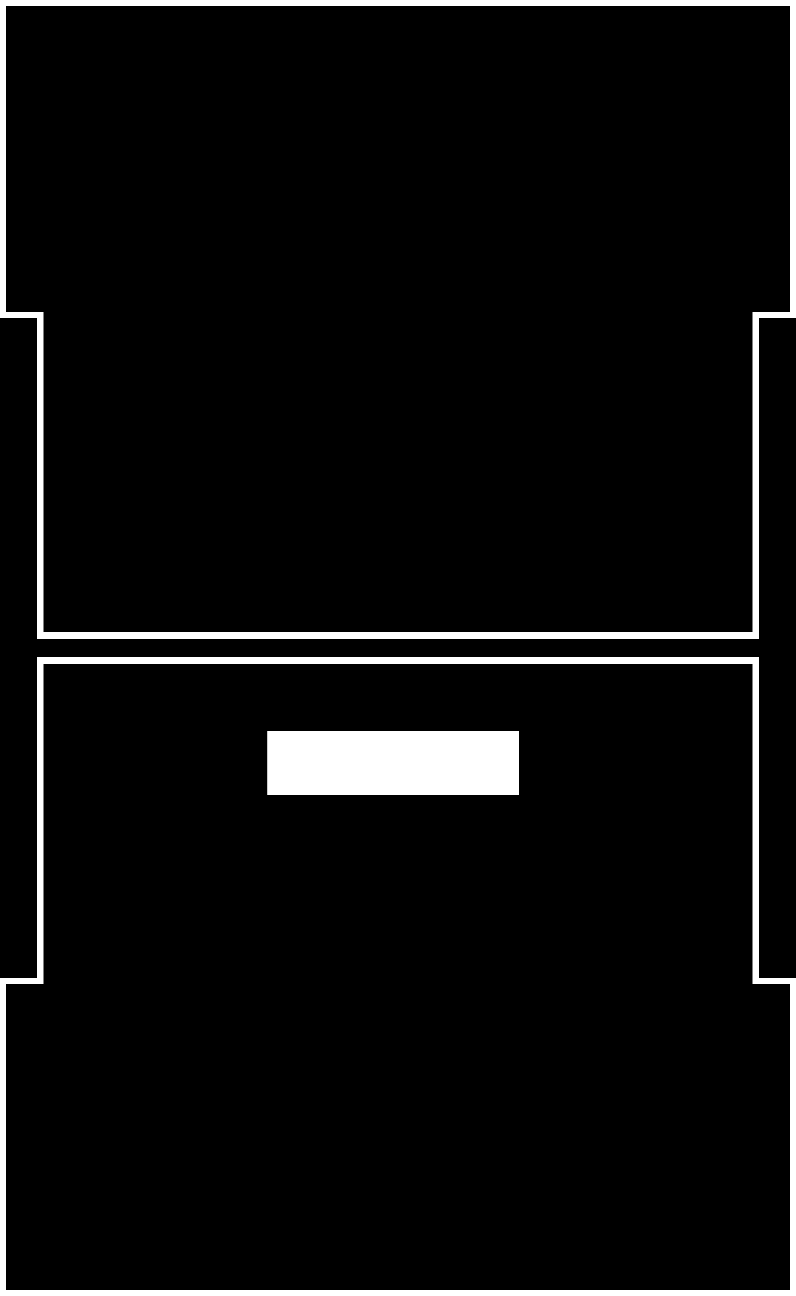
Split Flap Cut Sheet/Column 4/Flap 44 Dash/Flap 44 Dash split_flap_view.png
