rsmithamazon/F1Tower/Split Flap Cut Sheet/Column 4/Flap 51 kph/Flap 51 kph split_flap_view.png

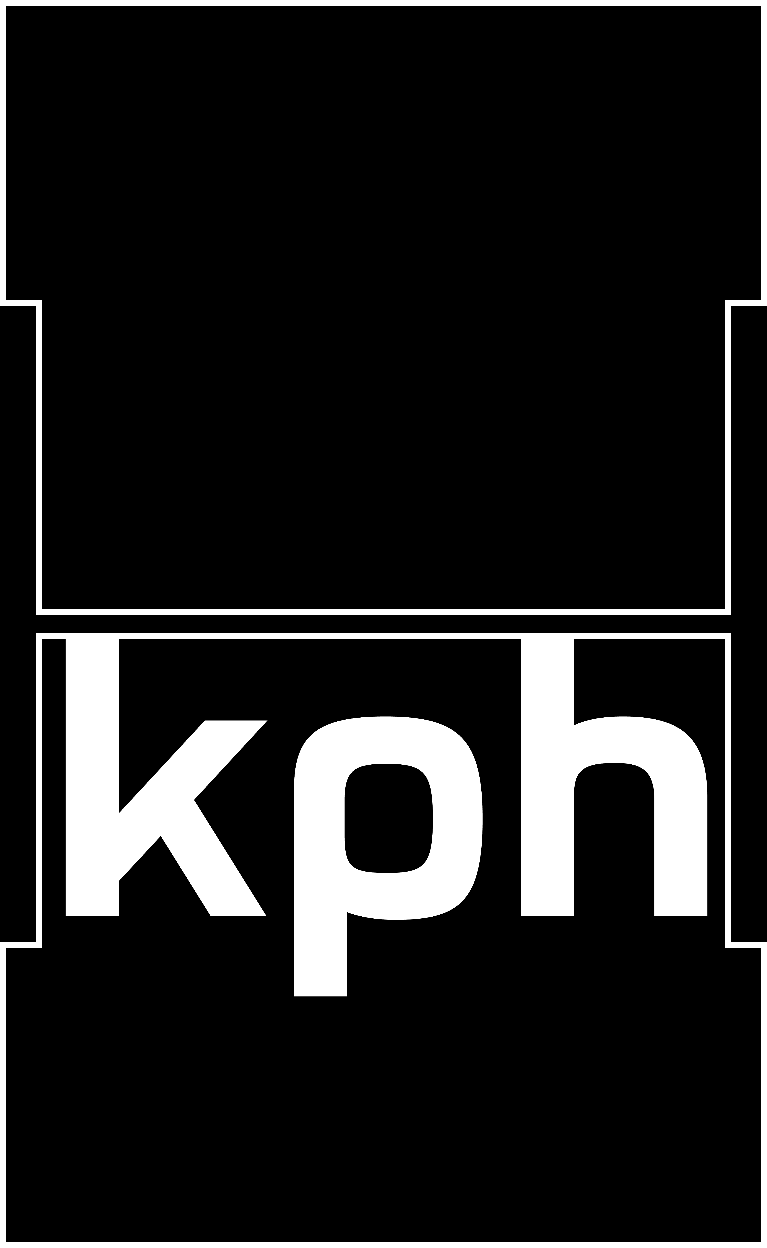
Split Flap Cut Sheet/Column 4/Flap 51 kph/Flap 51 kph split_flap_view.png
