rsmithamazon/F1Tower/Split Flap Cut Sheet/Ferrari-Done/Screenshot 2026-08-16 at 8.41.36 PM.png

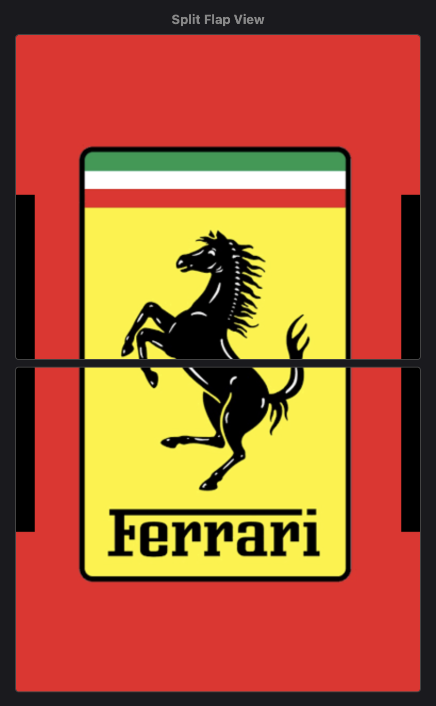
Split Flap Cut Sheet/Ferrari-Done/Screenshot 2026-08-16 at 8.41.36 PM.png
