rsmithamazon/F1Tower/Split Flap Cut Sheet/Mclaren-Done/Screenshot 2026-08-16 at 7.41.34 PM.png

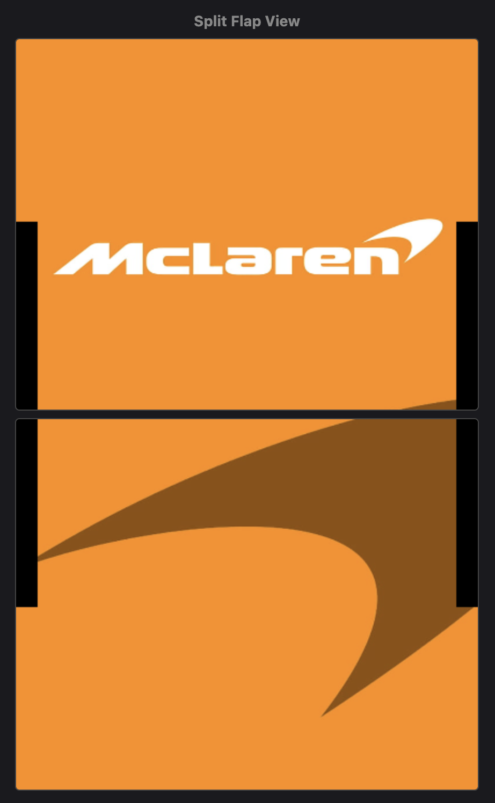
Split Flap Cut Sheet/Mclaren-Done/Screenshot 2026-08-16 at 7.41.34 PM.png
