rsmithamazon/F1Tower/static assets/Compressed Assets/Column 0/Flap 23 Haas use_this_asset.jpg

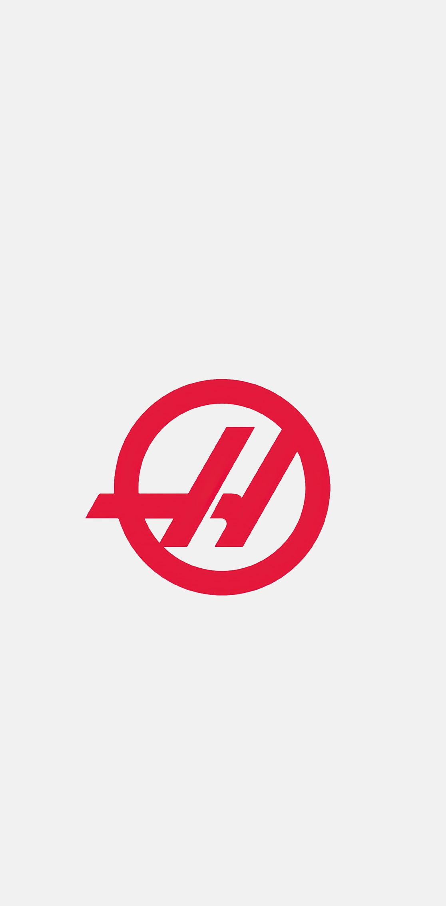
static assets/Compressed Assets/Column 0/Flap 23 Haas use_this_asset.jpg
