rsmithamazon/F1Tower/static assets/Compressed Assets/jpg/Column 0/Flap 9 Num 1 use_this_asset.jpg

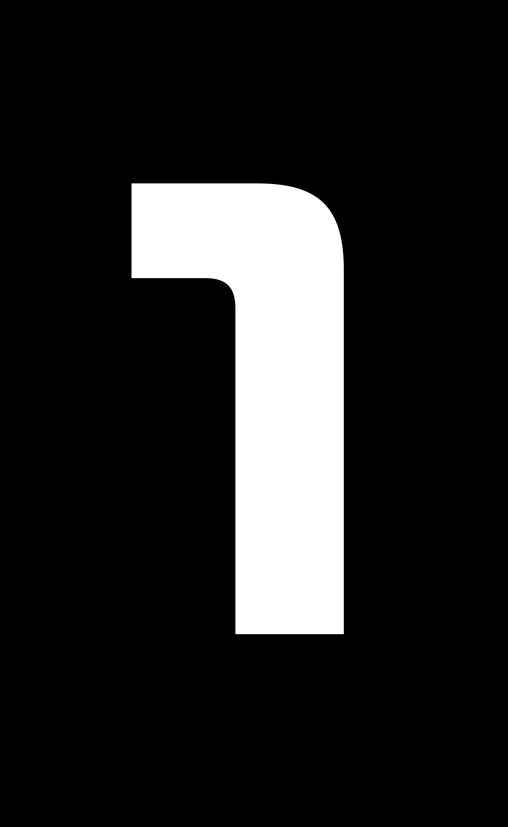
static assets/Compressed Assets/jpg/Column 0/Flap 9 Num 1 use_this_asset.jpg
