rsmithamazon/F1Tower/static assets/Compressed Assets/jpg/Column 0/Flap 10 Num 2 use_this_asset.jpg

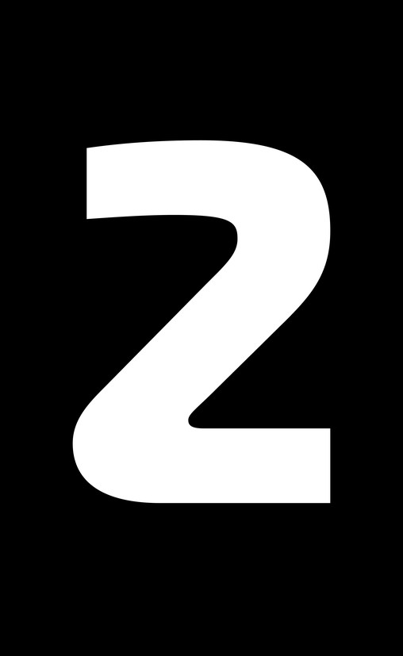
static assets/Compressed Assets/jpg/Column 0/Flap 10 Num 2 use_this_asset.jpg
