rsmithamazon/F1Tower/static assets/Compressed Assets/jpg/Column 0/Flap 14 Num 6 use_this_asset.jpg

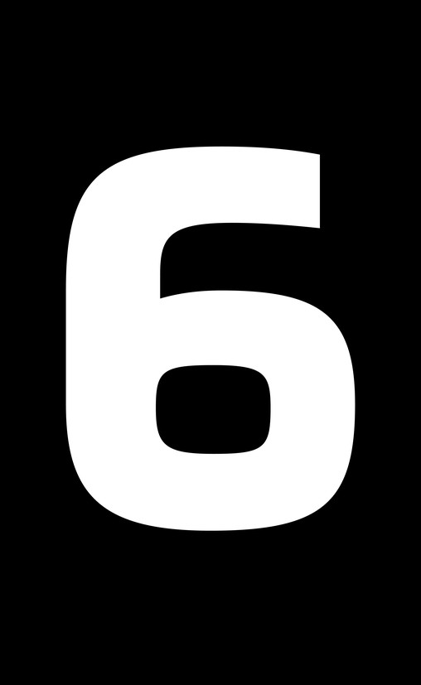
static assets/Compressed Assets/jpg/Column 0/Flap 14 Num 6 use_this_asset.jpg
