rsmithamazon/F1Tower/static assets/Compressed Assets/jpg/Column 0/Flap 17 Num 9 use_this_asset.jpg

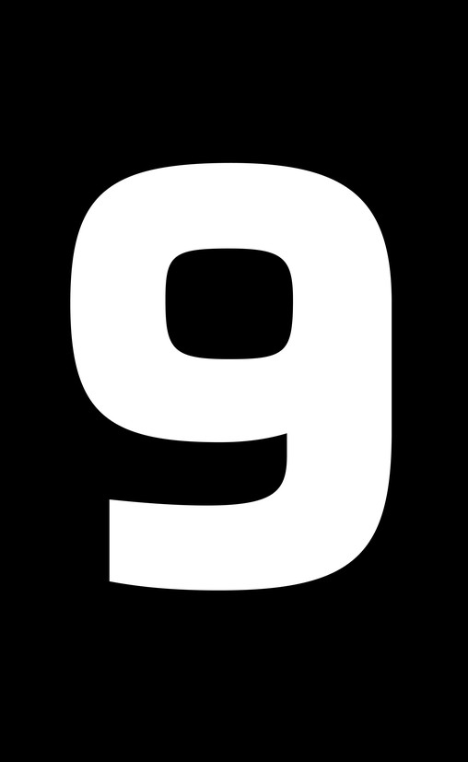
static assets/Compressed Assets/jpg/Column 0/Flap 17 Num 9 use_this_asset.jpg
