rsmithamazon/F1Tower/static assets/Compressed Assets/jpg/Column 0/Flap 26 Racing Bulls use_this_asset.jpg

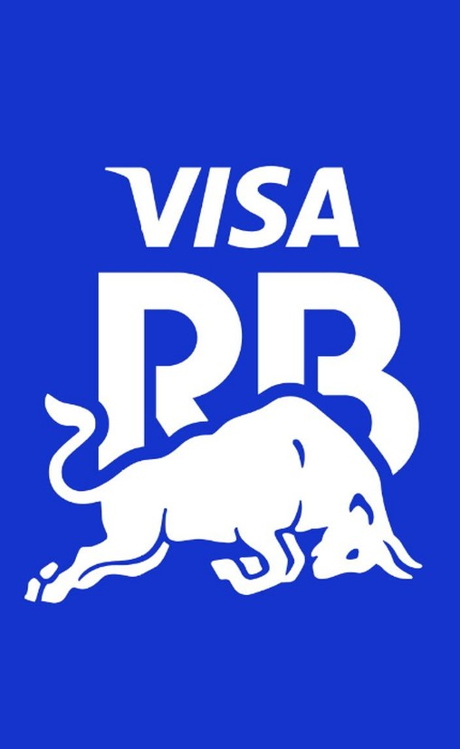
static assets/Compressed Assets/jpg/Column 0/Flap 26 Racing Bulls use_this_asset.jpg
