rsmithamazon/F1Tower/static assets/Compressed Assets/jpg/Column 0/Flap 31 USA use_this_asset.jpg

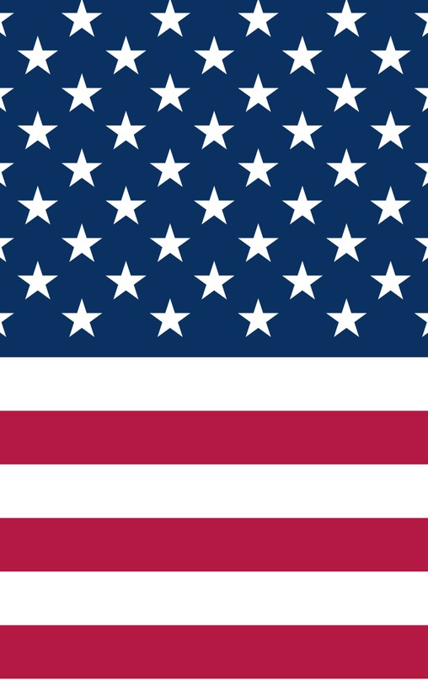
static assets/Compressed Assets/jpg/Column 0/Flap 31 USA use_this_asset.jpg
