rsmithamazon/F1Tower/static assets/Compressed Assets/jpg/Column 0/Flap 39 Singapore use_this_asset.jpg

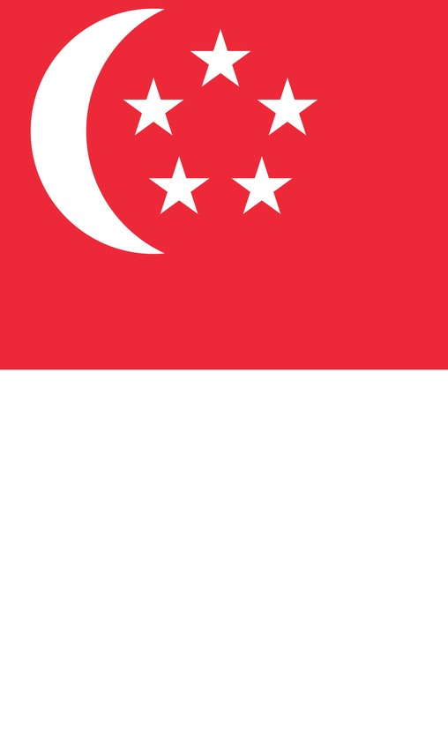
static assets/Compressed Assets/jpg/Column 0/Flap 39 Singapore use_this_asset.jpg
