rsmithamazon/F1Tower/static assets/Compressed Assets/jpg/Column 1/Flap 11 Num 3 use_this_asset.jpg

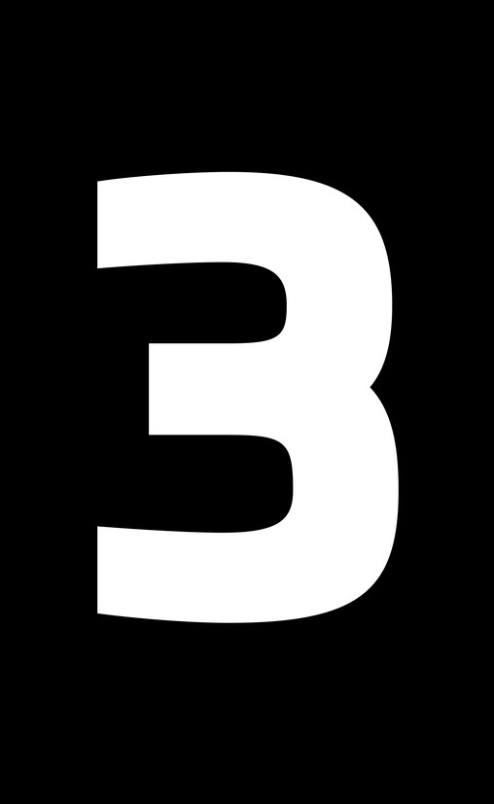
static assets/Compressed Assets/jpg/Column 1/Flap 11 Num 3 use_this_asset.jpg
