rsmithamazon/F1Tower/static assets/Compressed Assets/jpg/Column 1/Flap 15 Num 7 use_this_asset.jpg

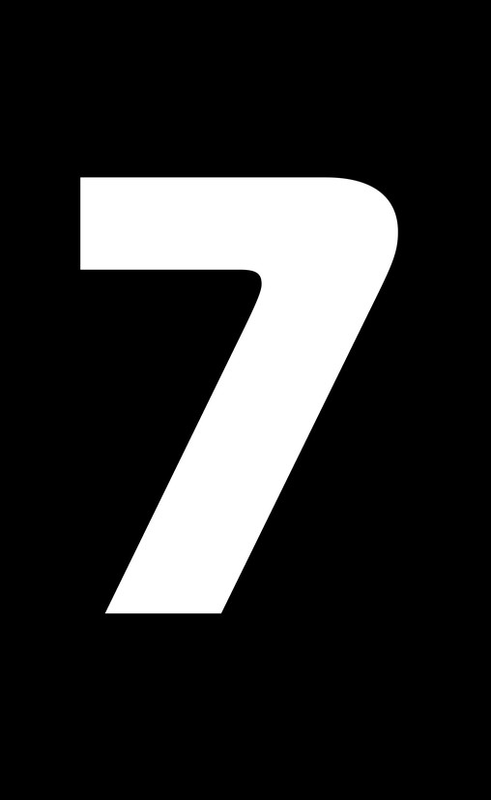
static assets/Compressed Assets/jpg/Column 1/Flap 15 Num 7 use_this_asset.jpg
