rsmithamazon/F1Tower/static assets/Compressed Assets/jpg/Column 1/Flap 16 Num 8 use_this_asset.jpg

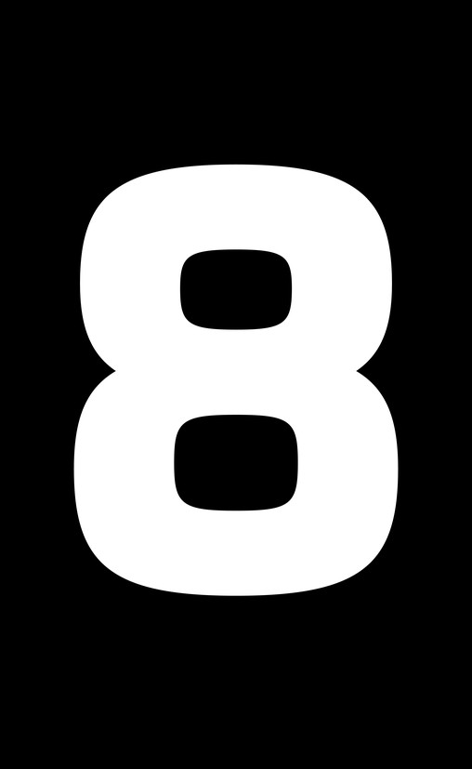
static assets/Compressed Assets/jpg/Column 1/Flap 16 Num 8 use_this_asset.jpg
