rsmithamazon/F1Tower/static assets/Compressed Assets/jpg/Column 1/Flap 18 Letter A use_this_asset.jpg

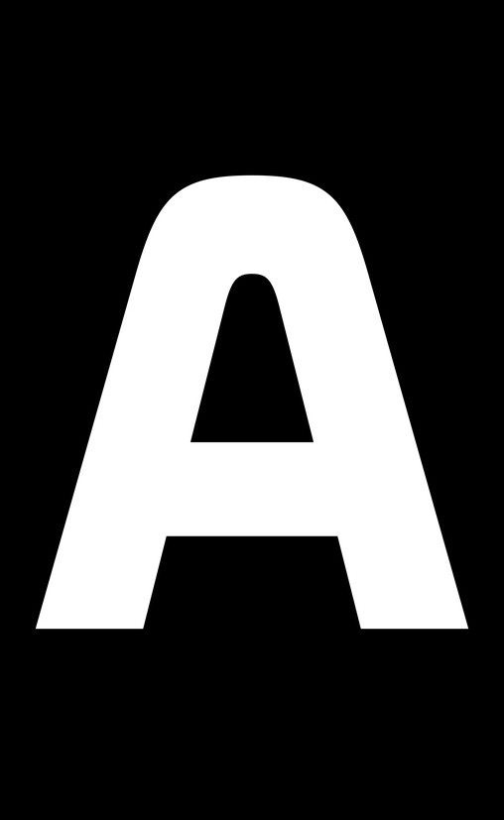
static assets/Compressed Assets/jpg/Column 1/Flap 18 Letter A use_this_asset.jpg
