rsmithamazon/F1Tower/static assets/Compressed Assets/jpg/Column 1/Flap 28 Letter K use_this_asset.jpg

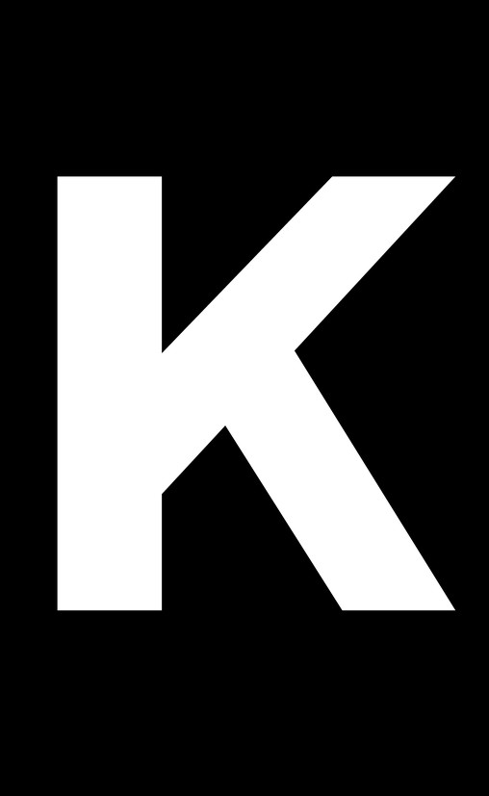
static assets/Compressed Assets/jpg/Column 1/Flap 28 Letter K use_this_asset.jpg
