rsmithamazon/F1Tower/static assets/Compressed Assets/jpg/Column 1/Flap 31 Letter N use_this_asset.jpg

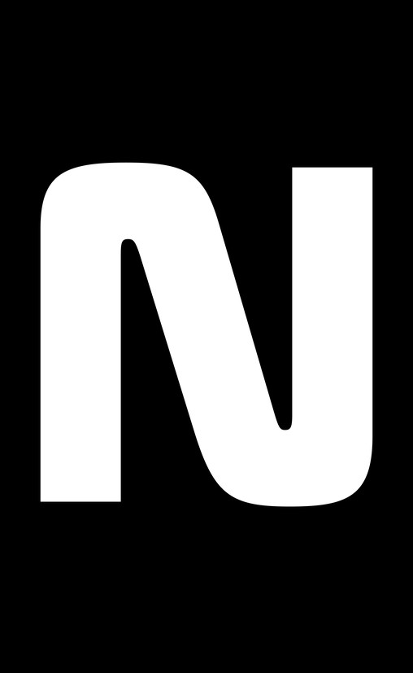
static assets/Compressed Assets/jpg/Column 1/Flap 31 Letter N use_this_asset.jpg
