rsmithamazon/F1Tower/static assets/Compressed Assets/jpg/Column 1/Flap 35 Letter R use_this_asset.jpg

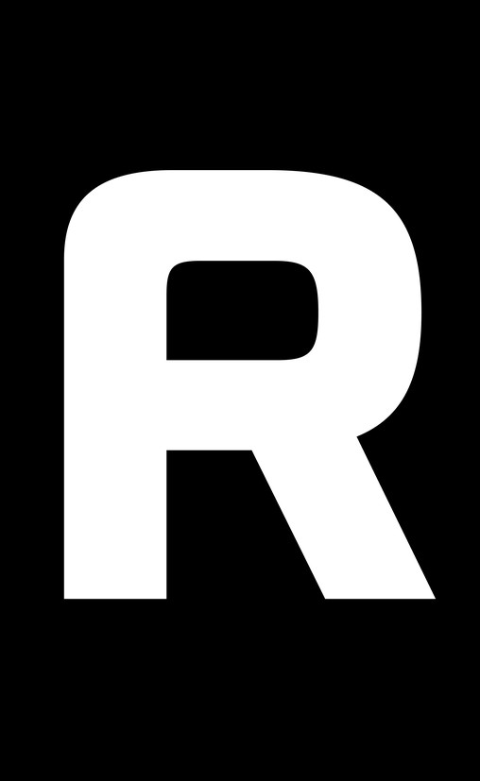
static assets/Compressed Assets/jpg/Column 1/Flap 35 Letter R use_this_asset.jpg
