rsmithamazon/F1Tower/static assets/Compressed Assets/jpg/Column 2/Flap 20 Letter C use_this_asset.jpg

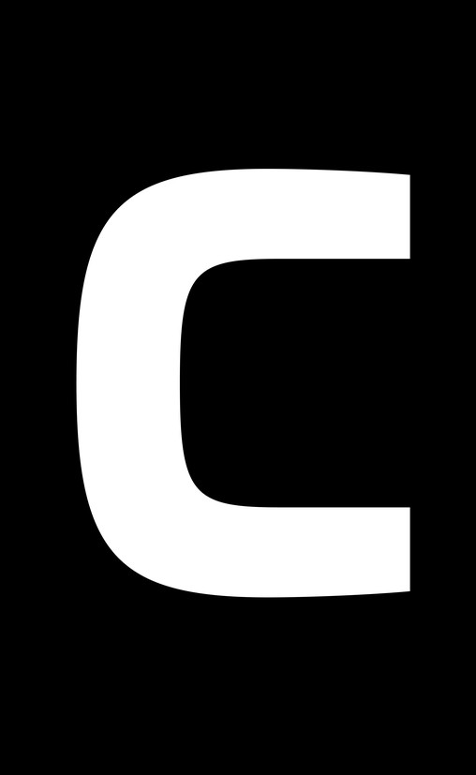
static assets/Compressed Assets/jpg/Column 2/Flap 20 Letter C use_this_asset.jpg
