rsmithamazon/F1Tower/static assets/Compressed Assets/jpg/Column 2/Flap 29 Letter L use_this_asset.jpg

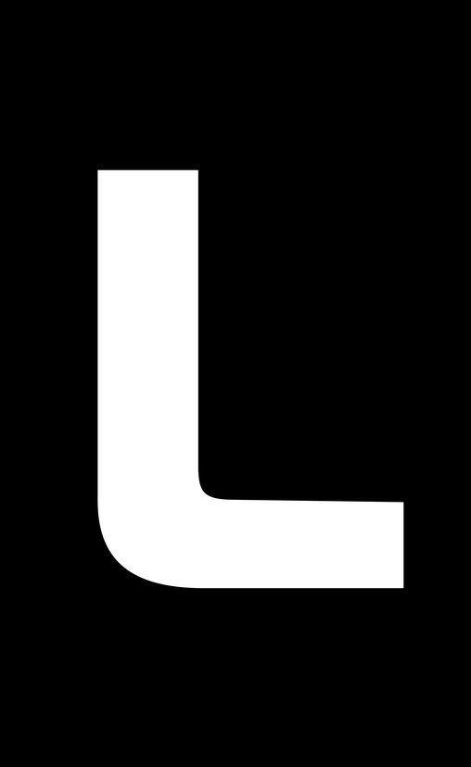
static assets/Compressed Assets/jpg/Column 2/Flap 29 Letter L use_this_asset.jpg
