rsmithamazon/F1Tower/static assets/Compressed Assets/jpg/Column 2/Flap 39 Letter V use_this_asset.jpg

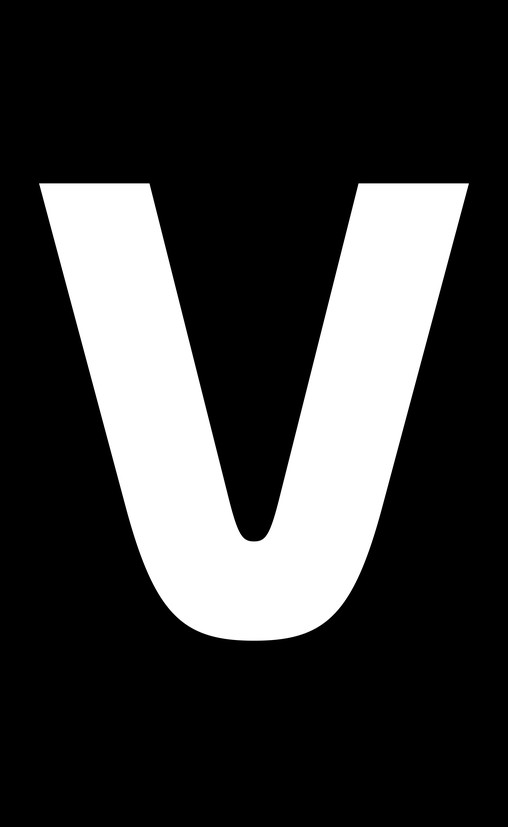
static assets/Compressed Assets/jpg/Column 2/Flap 39 Letter V use_this_asset.jpg
