rsmithamazon/F1Tower/static assets/Compressed Assets/jpg/Column 2/Flap 44 Dash use_this_asset.jpg

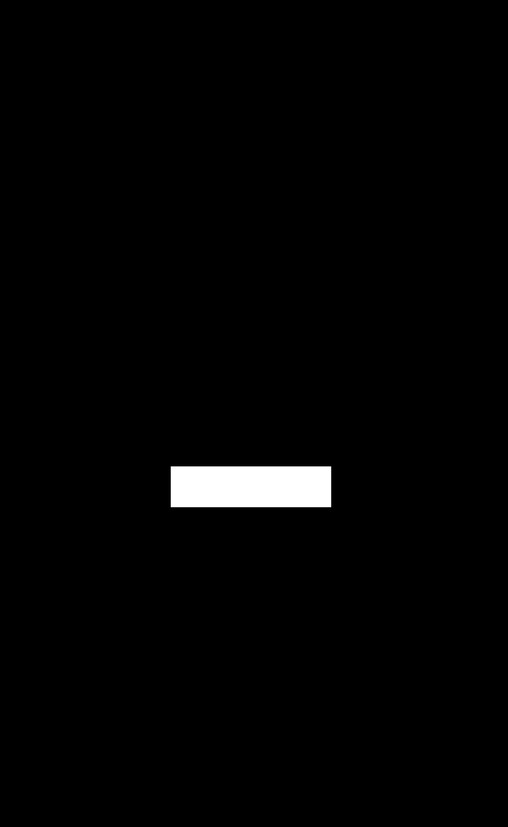
static assets/Compressed Assets/jpg/Column 2/Flap 44 Dash use_this_asset.jpg
