rsmithamazon/F1Tower/static assets/Compressed Assets/jpg/Column 3/Flap 30 Letter M use_this_asset.jpg

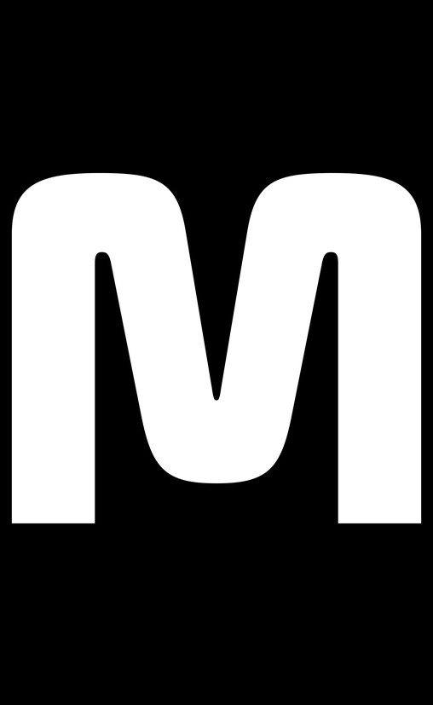
static assets/Compressed Assets/jpg/Column 3/Flap 30 Letter M use_this_asset.jpg
