rsmithamazon/F1Tower/static assets/Compressed Assets/jpg/Column 3/Flap 46 Exclamation use_this_asset.jpg

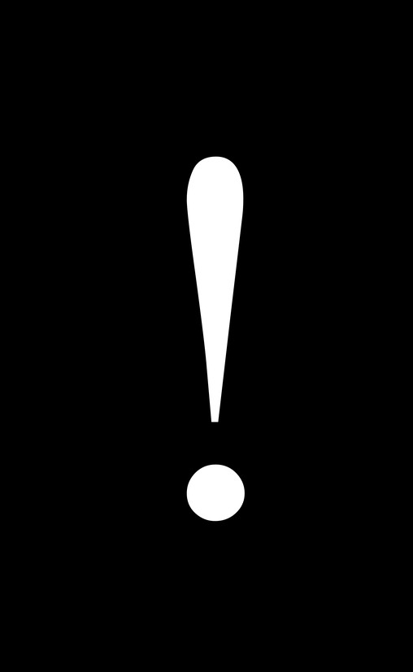
static assets/Compressed Assets/jpg/Column 3/Flap 46 Exclamation use_this_asset.jpg
