rsmithamazon/F1Tower/static assets/Compressed Assets/jpg/Column 3/Flap 47 Degree use_this_asset.jpg

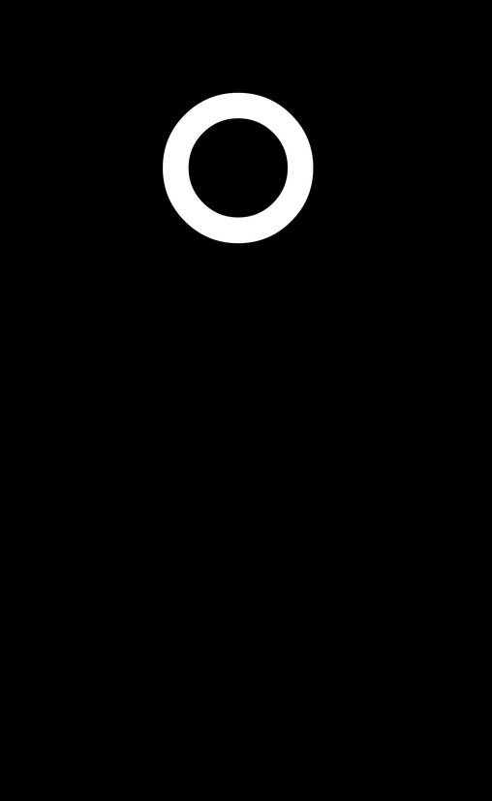
static assets/Compressed Assets/jpg/Column 3/Flap 47 Degree use_this_asset.jpg
