rsmithamazon/F1Tower/static assets/Compressed Assets/jpg/Column 4/Flap 12 Num 4 use_this_asset.jpg

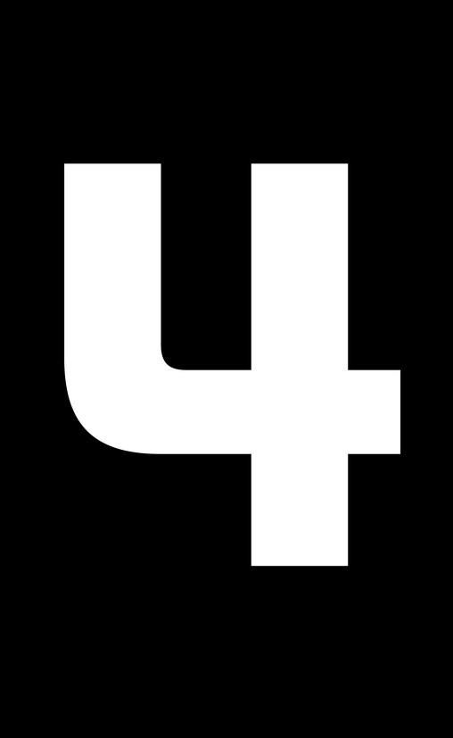
static assets/Compressed Assets/jpg/Column 4/Flap 12 Num 4 use_this_asset.jpg
