rsmithamazon/F1Tower/static assets/Compressed Assets/jpg/Column 4/Flap 40 Letter W use_this_asset.jpg

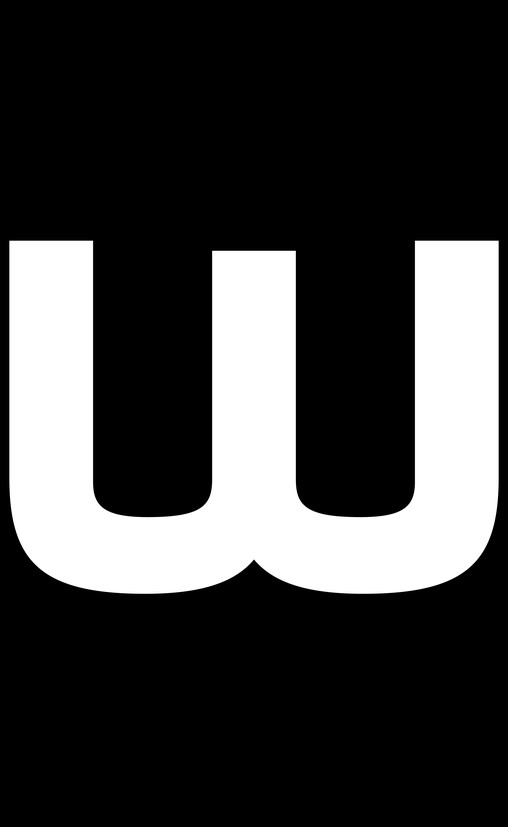
static assets/Compressed Assets/jpg/Column 4/Flap 40 Letter W use_this_asset.jpg
