rsmithamazon/F1Tower/static assets/Compressed Assets/jpg/Column 4/Flap 42 Letter Y use_this_asset.jpg

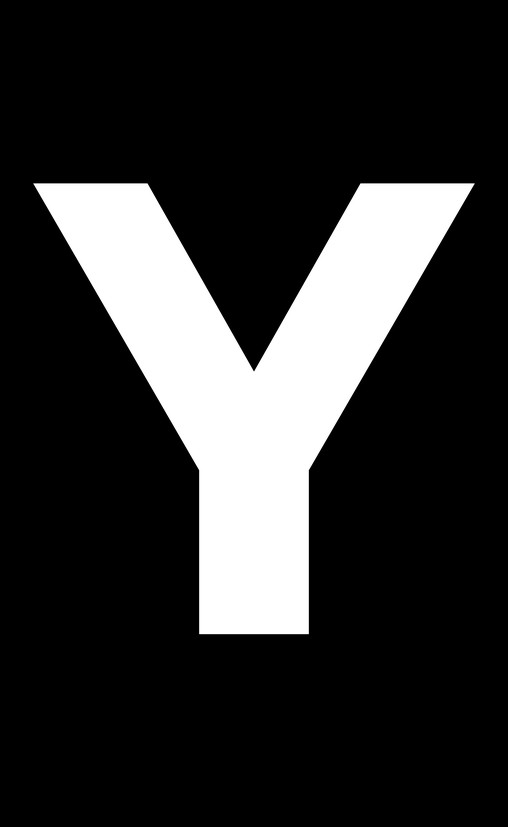
static assets/Compressed Assets/jpg/Column 4/Flap 42 Letter Y use_this_asset.jpg
