rsmithamazon/F1Tower/static assets/Compressed Assets/jpg/Column 4/Flap 43 Letter Z use_this_asset.jpg

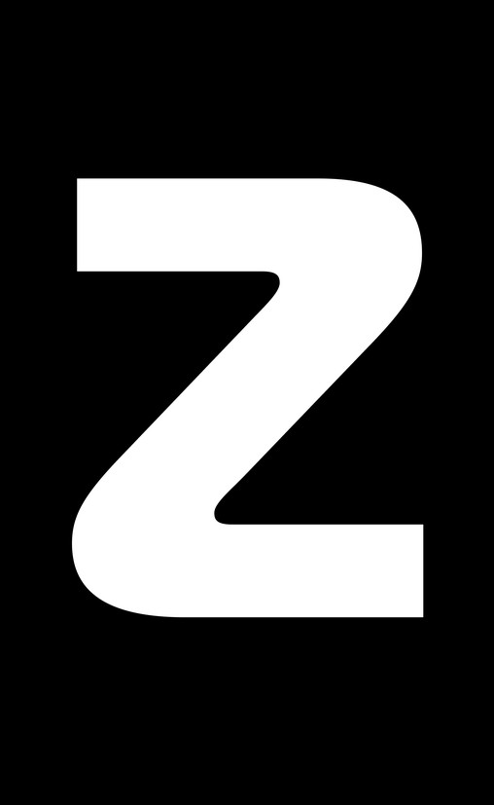
static assets/Compressed Assets/jpg/Column 4/Flap 43 Letter Z use_this_asset.jpg
