rsmithamazon/F1Tower/static assets/Compressed Assets/jpg/Column 4/Flap 50 mph use_this_asset.jpg

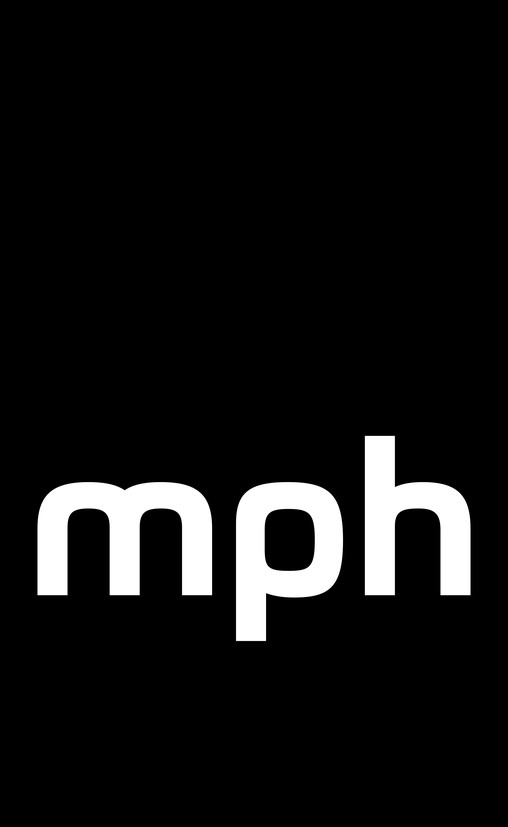
static assets/Compressed Assets/jpg/Column 4/Flap 50 mph use_this_asset.jpg
