rsmithamazon/F1Tower/static assets/Compressed Assets/png/Column 0/Flap 28 Cadillac use_this_asset.png

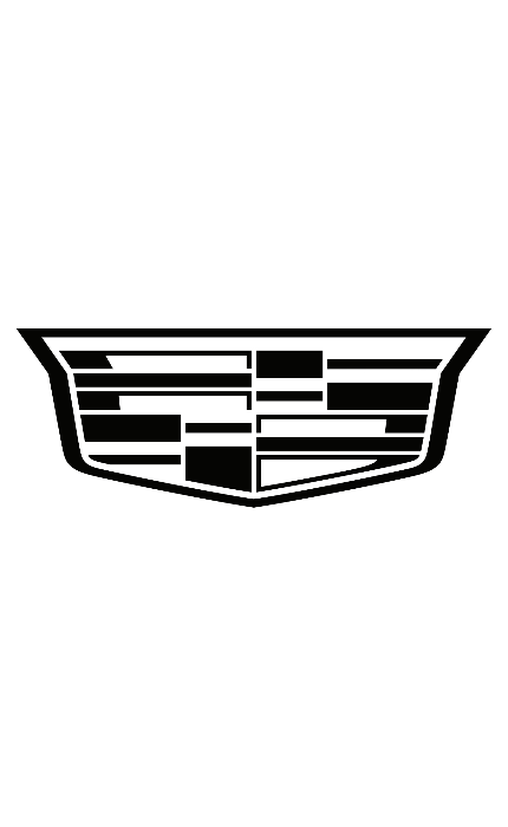
static assets/Compressed Assets/png/Column 0/Flap 28 Cadillac use_this_asset.png
