rsmithamazon/F1Tower/static assets/Compressed Assets/png/Column 0/Flap 32 Saudi Arabia use_this_asset.png

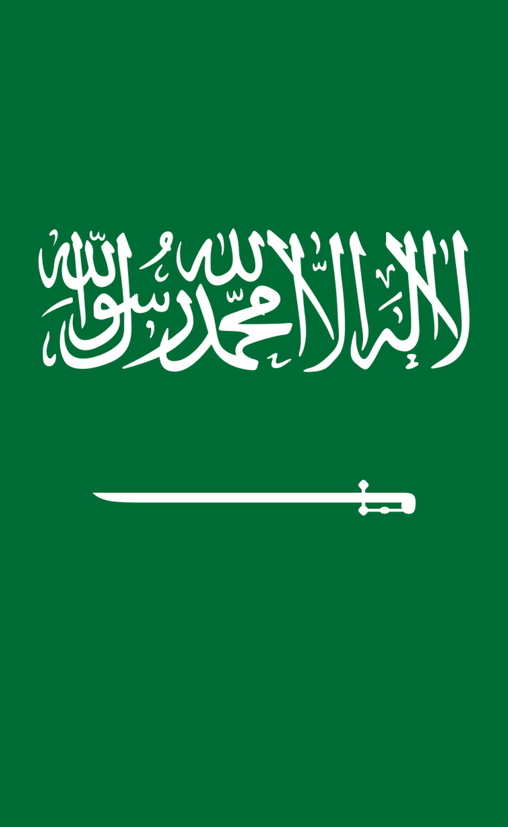
static assets/Compressed Assets/png/Column 0/Flap 32 Saudi Arabia use_this_asset.png
