rsmithamazon/F1Tower/static assets/Compressed Assets/png/Column 1/Flap 13 Num 5 use_this_asset.png

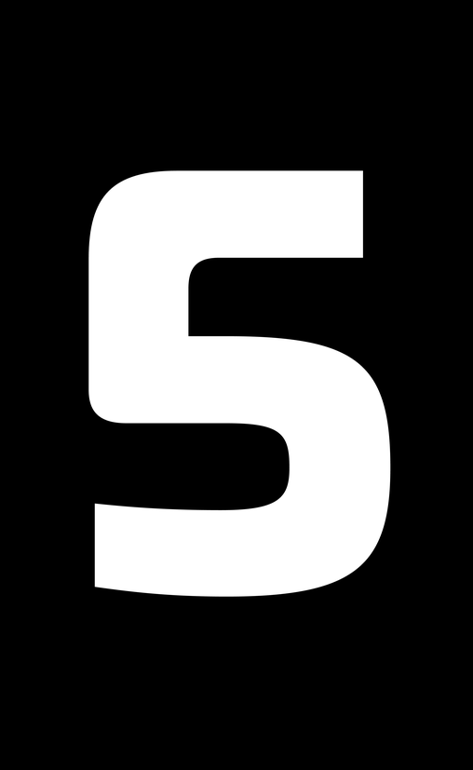
static assets/Compressed Assets/png/Column 1/Flap 13 Num 5 use_this_asset.png
