rsmithamazon/F1Tower/static assets/Compressed Assets/png/Column 1/Flap 41 Letter X use_this_asset.png

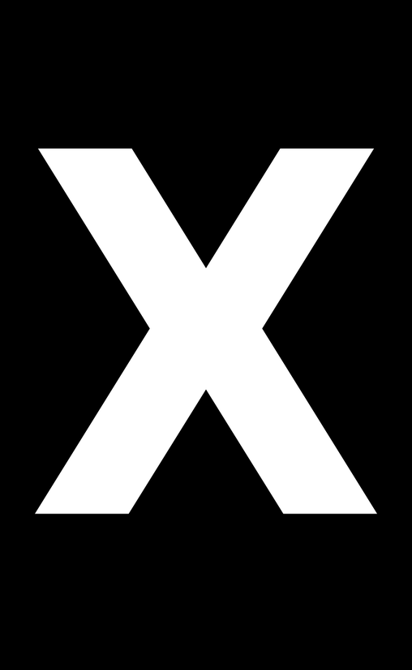
static assets/Compressed Assets/png/Column 1/Flap 41 Letter X use_this_asset.png
