rsmithamazon/F1Tower/static assets/Compressed Assets/png/Column 2/Flap 21 Letter D use_this_asset.png

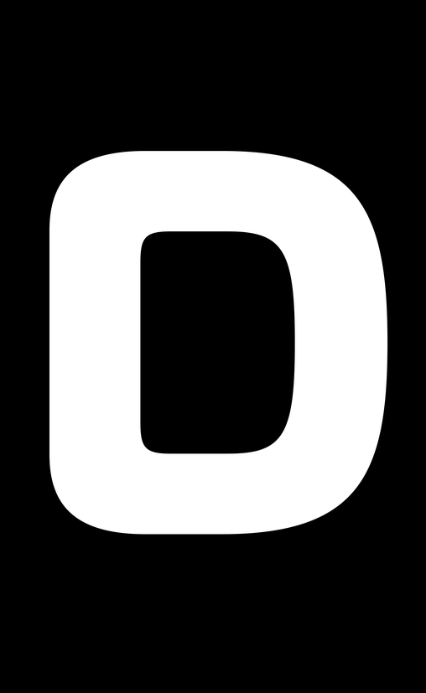
static assets/Compressed Assets/png/Column 2/Flap 21 Letter D use_this_asset.png
