rsmithamazon/F1Tower/static assets/Compressed Assets/png/Column 3/Flap 49 Plus use_this_asset.png

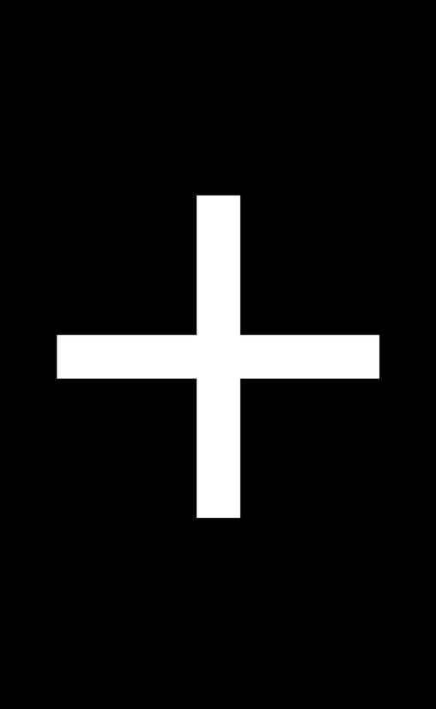
static assets/Compressed Assets/png/Column 3/Flap 49 Plus use_this_asset.png
