rsmithamazon/F1Tower/static assets/Compressed Assets/png/Column 4/Flap 51 kph use_this_asset.png

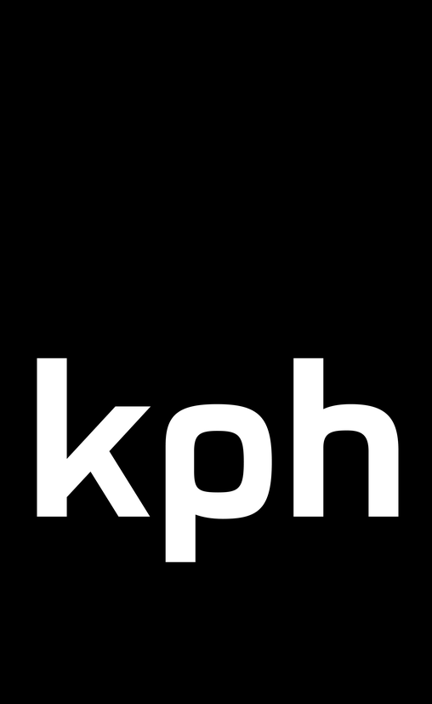
static assets/Compressed Assets/png/Column 4/Flap 51 kph use_this_asset.png
