rsmithamazon/F1Tower/static assets/F1 Teams/Aston Martin-Done/Aston Martin.jpg

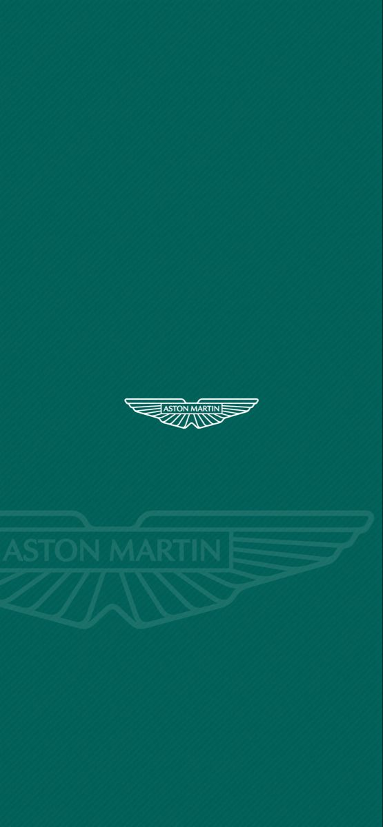
static assets/F1 Teams/Aston Martin-Done/Aston Martin.jpg
