rsmithamazon/F1Tower/static assets/F1 Teams/Aston Martin-Done/Screenshot 2026-08-16 at 8.40.47 PM.png

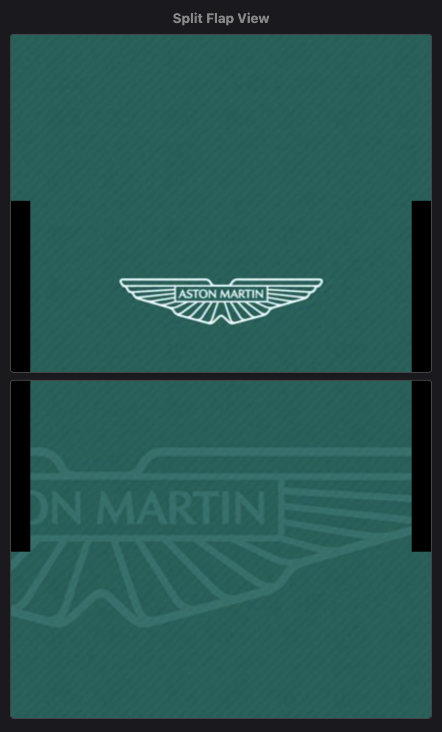
static assets/F1 Teams/Aston Martin-Done/Screenshot 2026-08-16 at 8.40.47 PM.png
