rsmithamazon/F1Tower/static assets/F1 Teams/Flap 19 McLaren/Flap 19 McLaren use_this_asset.png

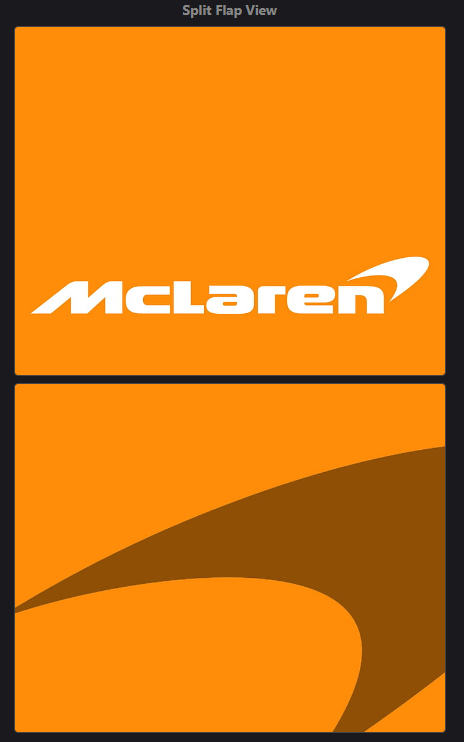
static assets/F1 Teams/Flap 19 McLaren/Flap 19 McLaren use_this_asset.png
