rsmithamazon/F1Tower/static assets/F1 Teams/Flap 20 Williams/williams-racing-f1-33-1125x2436.jpg

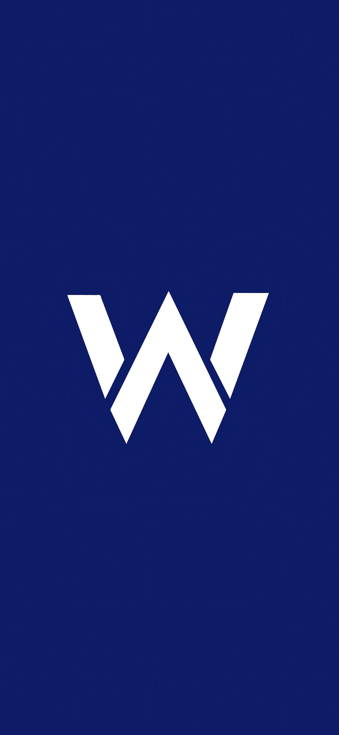
static assets/F1 Teams/Flap 20 Williams/williams-racing-f1-33-1125x2436.jpg
