rsmithamazon/F1Tower/static assets/F1 Teams/Flap 21 Red Bull/Original.jpg

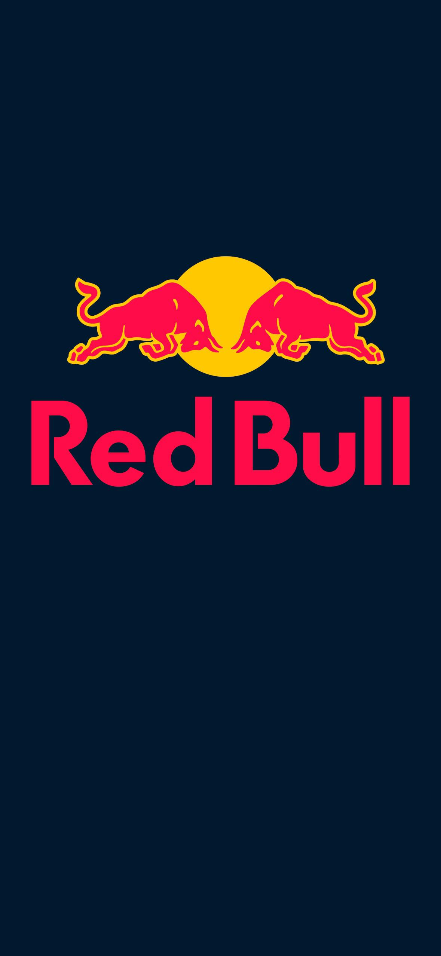
static assets/F1 Teams/Flap 21 Red Bull/Original.jpg
