rsmithamazon/F1Tower/static assets/F1 Teams/Flap 23 Haas/Flap 23 Haas use_this_asset.png

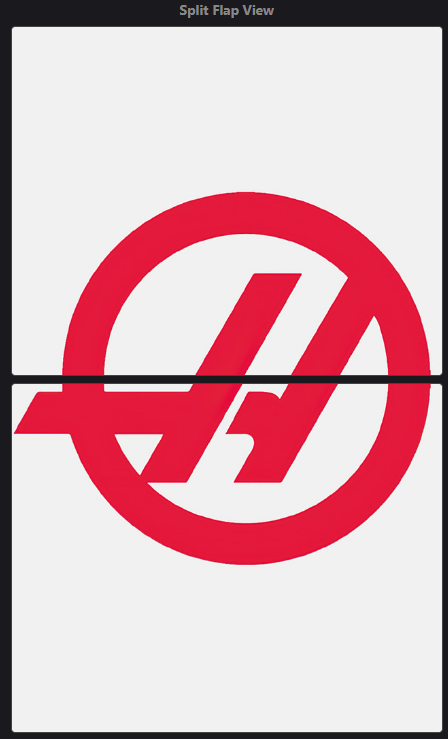
static assets/F1 Teams/Flap 23 Haas/Flap 23 Haas use_this_asset.png
