rsmithamazon/F1Tower/static assets/F1 Teams/Flap 24 Alpine/Picture.jpg

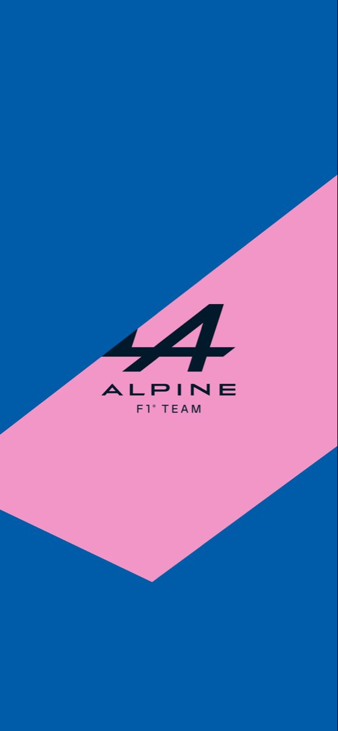
static assets/F1 Teams/Flap 24 Alpine/Picture.jpg
