rsmithamazon/F1Tower/static assets/F1 Teams/Flap 25 Aston Martin/AM1.png

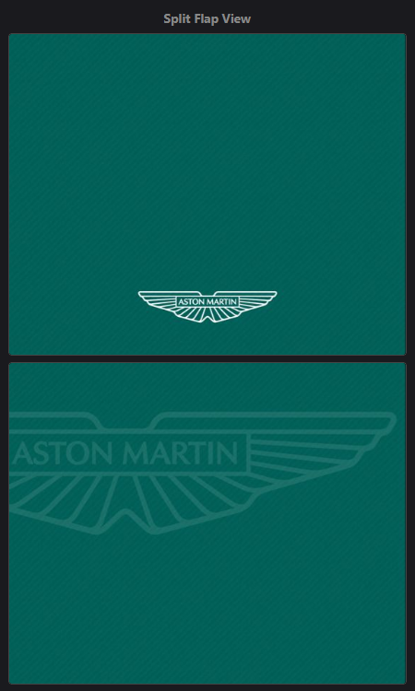
static assets/F1 Teams/Flap 25 Aston Martin/AM1.png
