rsmithamazon/F1Tower/static assets/F1 Teams/Flap 26 Racing Bulls/Flap 26 Racing Bulls split_flap_view.png

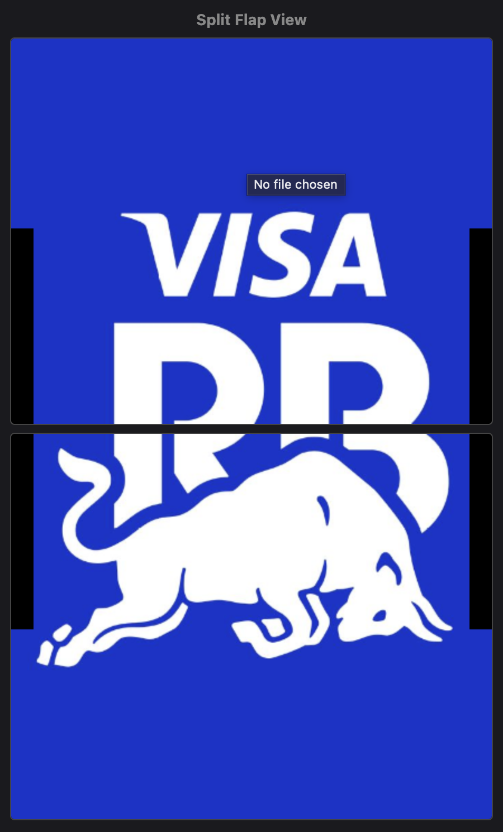
static assets/F1 Teams/Flap 26 Racing Bulls/Flap 26 Racing Bulls split_flap_view.png
