rsmithamazon/F1Tower/static assets/F1 Teams/Flap 28 Cadillac/CADILLAC_2DCREST_POS_RGB.jpg

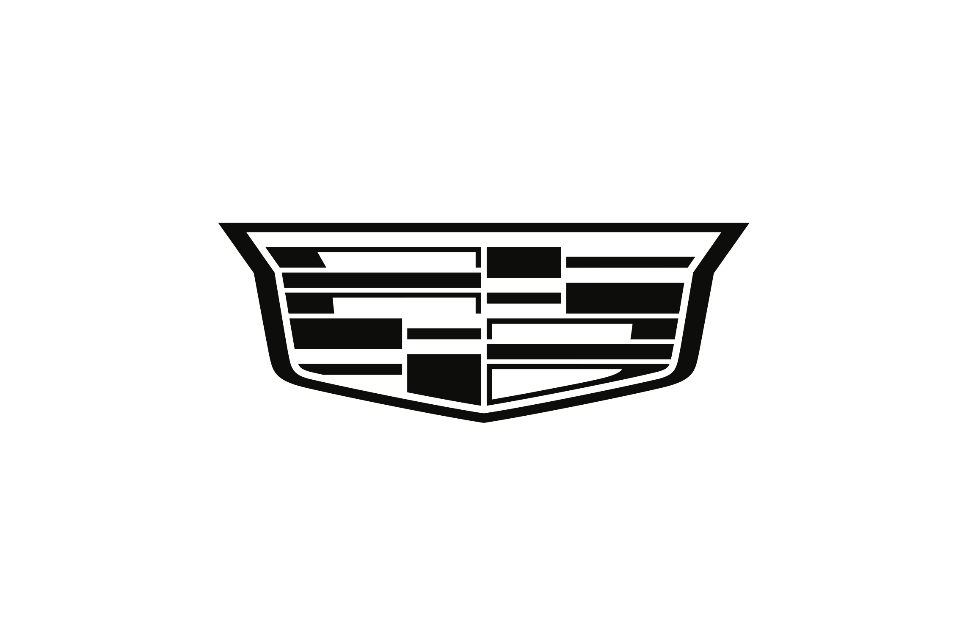
static assets/F1 Teams/Flap 28 Cadillac/CADILLAC_2DCREST_POS_RGB.jpg
