rsmithamazon/F1Tower/static assets/F1 Teams/NotUsed/-M0u6u1-_200x200.jpg

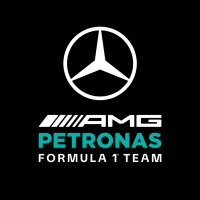
static assets/F1 Teams/NotUsed/-M0u6u1-_200x200.jpg
