rsmithamazon/F1Tower/static assets/F1 Teams/NotUsed/AM2.png

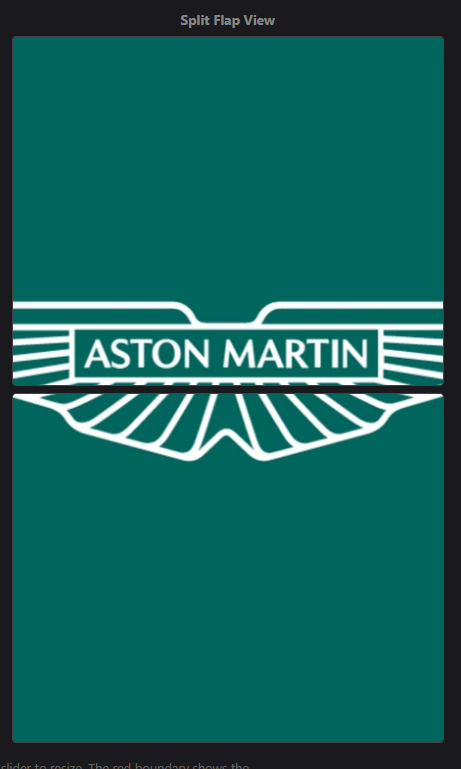
static assets/F1 Teams/NotUsed/AM2.png
