rsmithamazon/F1Tower/static assets/F1 Teams/NotUsed/ap2.png

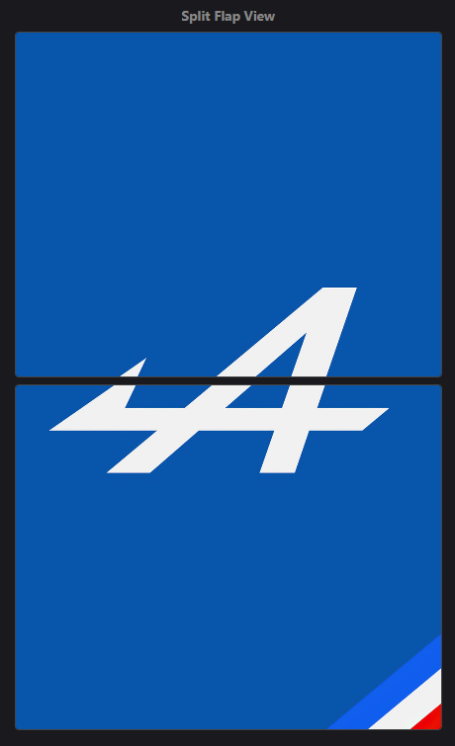
static assets/F1 Teams/NotUsed/ap2.png
