rsmithamazon/F1Tower/static assets/F1 Teams/NotUsed/f2.png

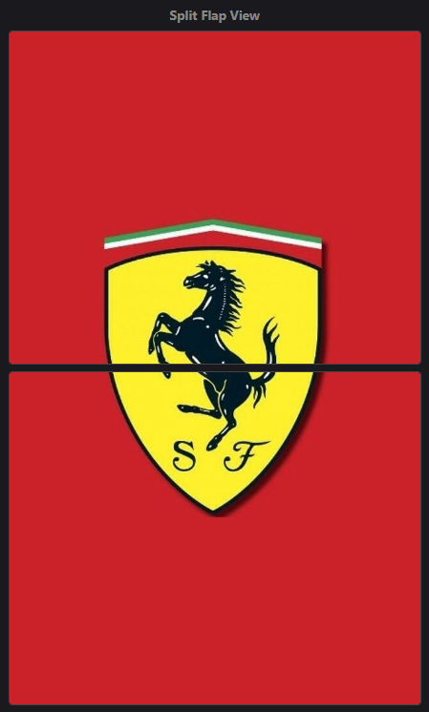
static assets/F1 Teams/NotUsed/f2.png
