rsmithamazon/F1Tower/static assets/F1 Teams/NotUsed/f3.png

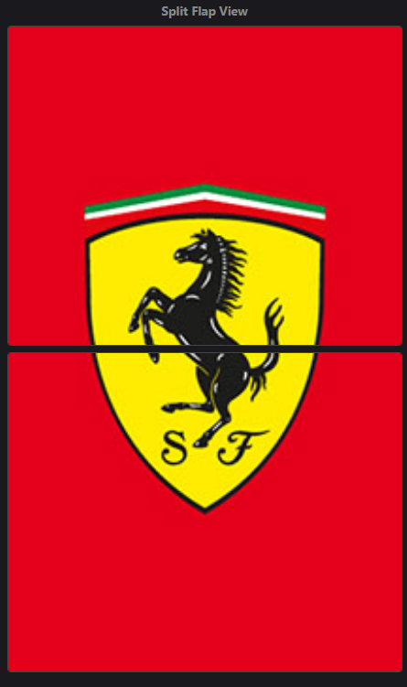
static assets/F1 Teams/NotUsed/f3.png
