rsmithamazon/F1Tower/static assets/F1 Teams/NotUsed/images copy 2.png

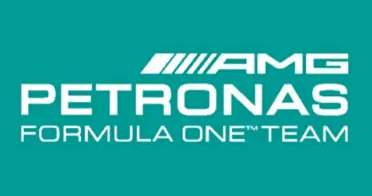
static assets/F1 Teams/NotUsed/images copy 2.png
