rsmithamazon/F1Tower/static assets/F1 Teams/NotUsed/Merc.png

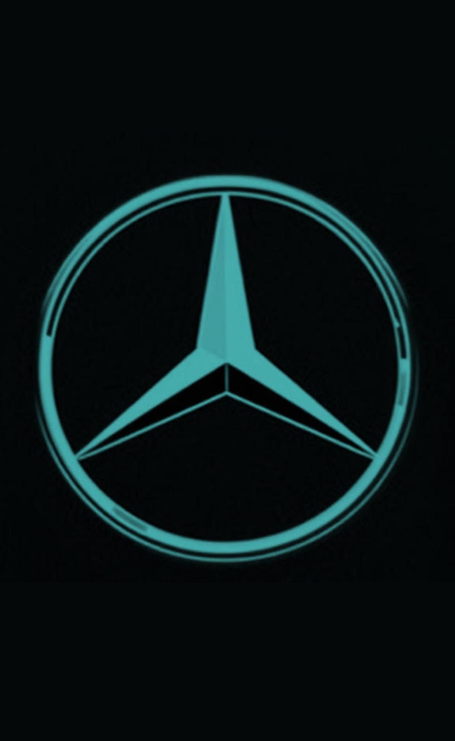
static assets/F1 Teams/NotUsed/Merc.png
