rsmithamazon/F1Tower/static assets/F1 Teams/NotUsed/unnamed.webp

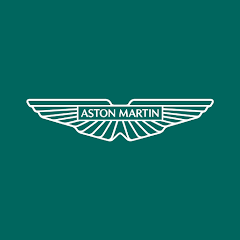
static assets/F1 Teams/NotUsed/unnamed.webp
