rsmithamazon/F1Tower/static assets/Flags/Belgium/Government_Ensign_of_Belgium.svg.webp

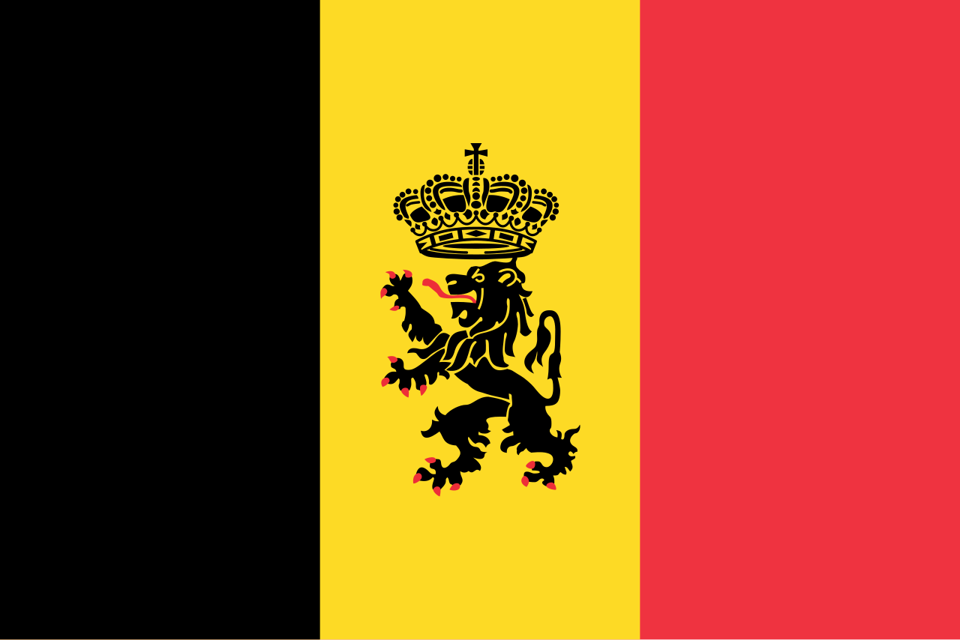
static assets/Flags/Belgium/Government_Ensign_of_Belgium.svg.webp
