rsmithamazon/F1Tower/static assets/Flags/Belgium/Screenshot 2026-08-17 at 7.13.08 PM.png

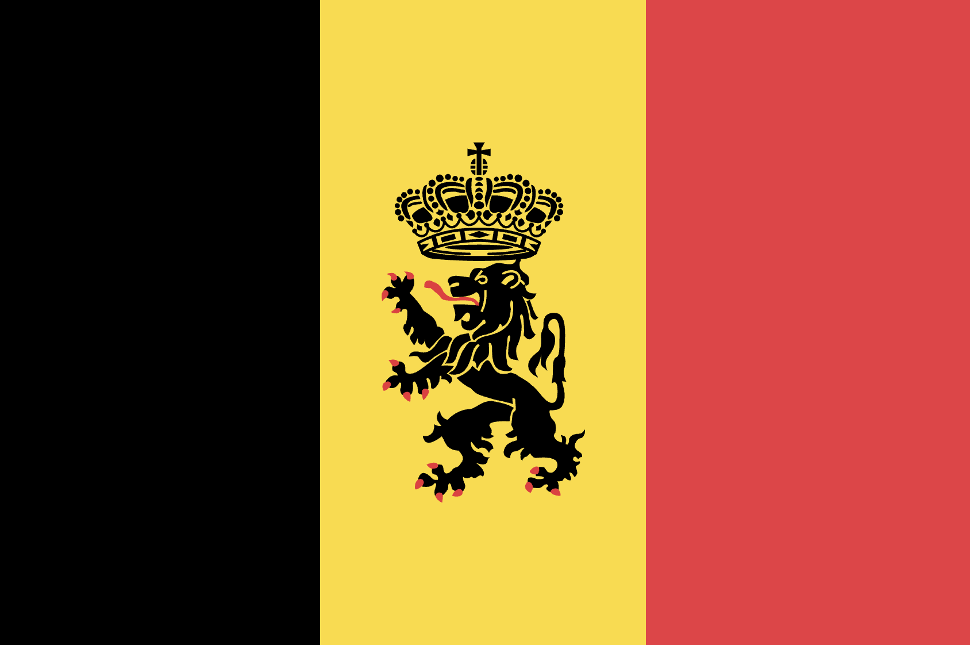
static assets/Flags/Belgium/Screenshot 2026-08-17 at 7.13.08 PM.png
