rsmithamazon/F1Tower/static assets/Flags/Screenshot 2026-08-17 at 6.50.42 PM.png

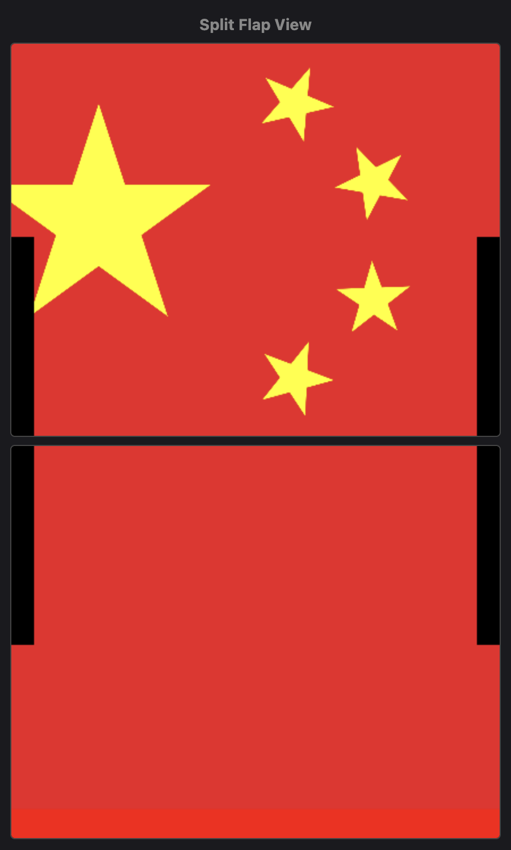
static assets/Flags/Screenshot 2026-08-17 at 6.50.42 PM.png
