rsmithamazon/F1Tower/static assets/Flags/Screenshot 2026-08-17 at 7.06.46 PM.png

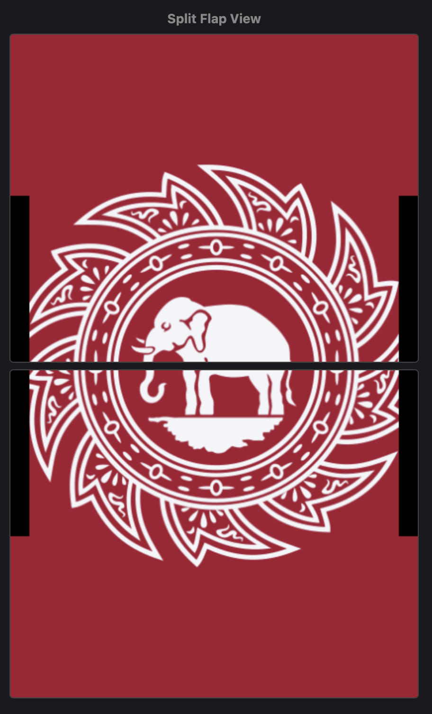
static assets/Flags/Screenshot 2026-08-17 at 7.06.46 PM.png
