rsmithamazon/F1Tower/static assets/Flags/Singapore/Flag_of_Singapore copy 2.svg copy.png

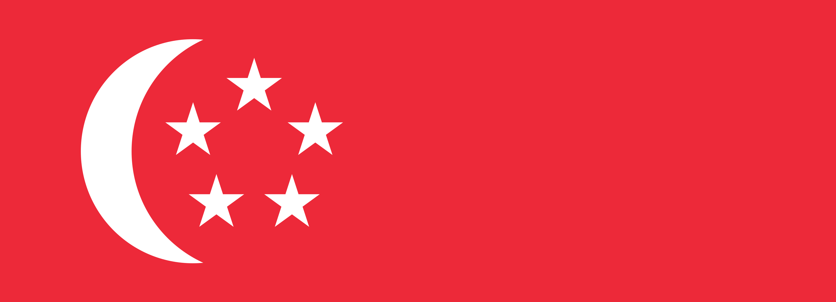
static assets/Flags/Singapore/Flag_of_Singapore copy 2.svg copy.png
