rsmithamazon/F1Tower/static assets/Flags/Spain/Screenshot 2026-08-14 at 7.37.08 PM.png

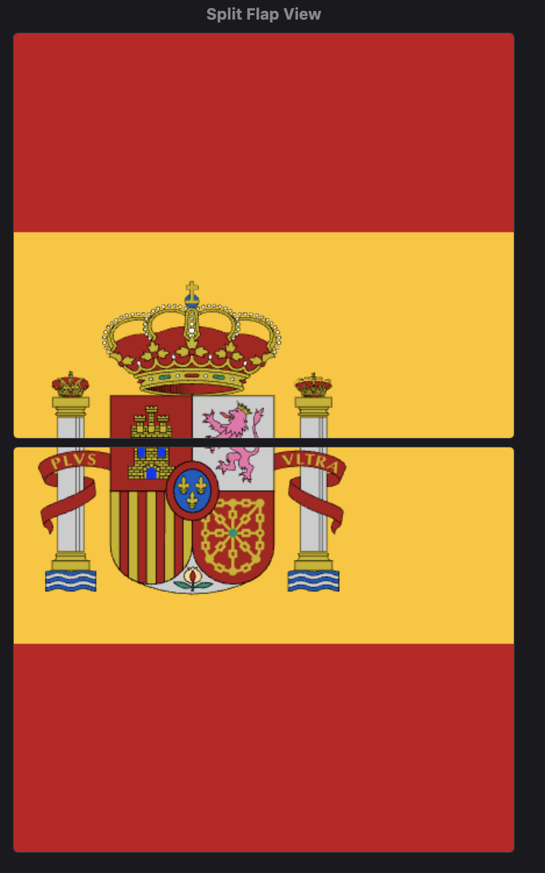
static assets/Flags/Spain/Screenshot 2026-08-14 at 7.37.08 PM.png
