rsmithamazon/F1Tower/static assets/Flap Sheets/Column 1 flap sheet.png

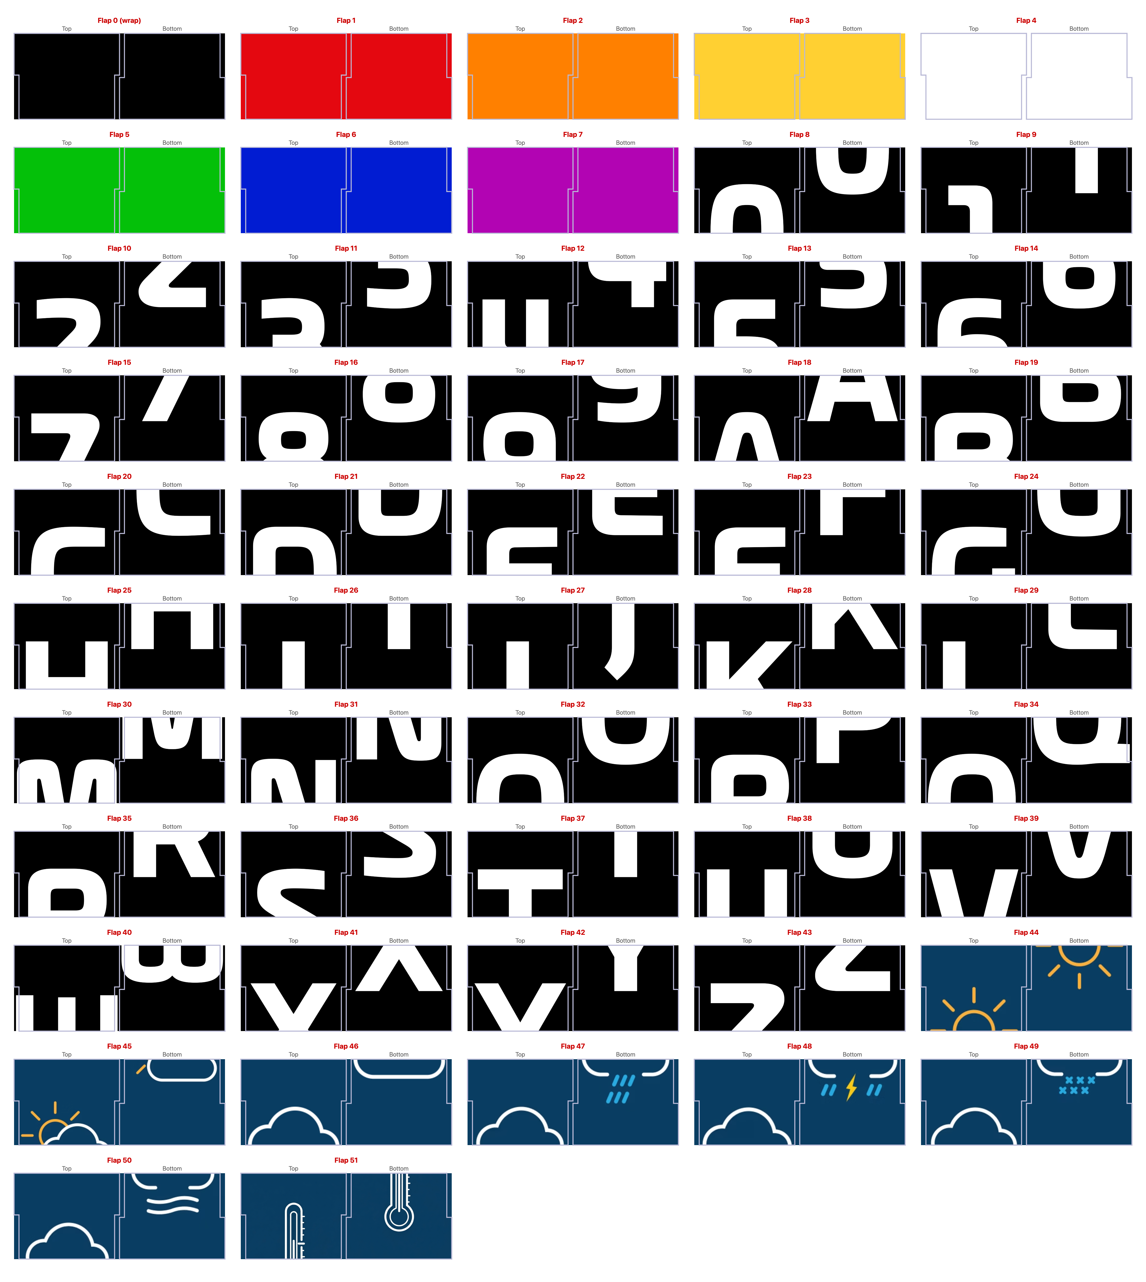
static assets/Flap Sheets/Column 1 flap sheet.png
