rsmithamazon/F1Tower/static assets/Text Flaps/Flap 49 plus/Flap 49 plus split_flap_view.png

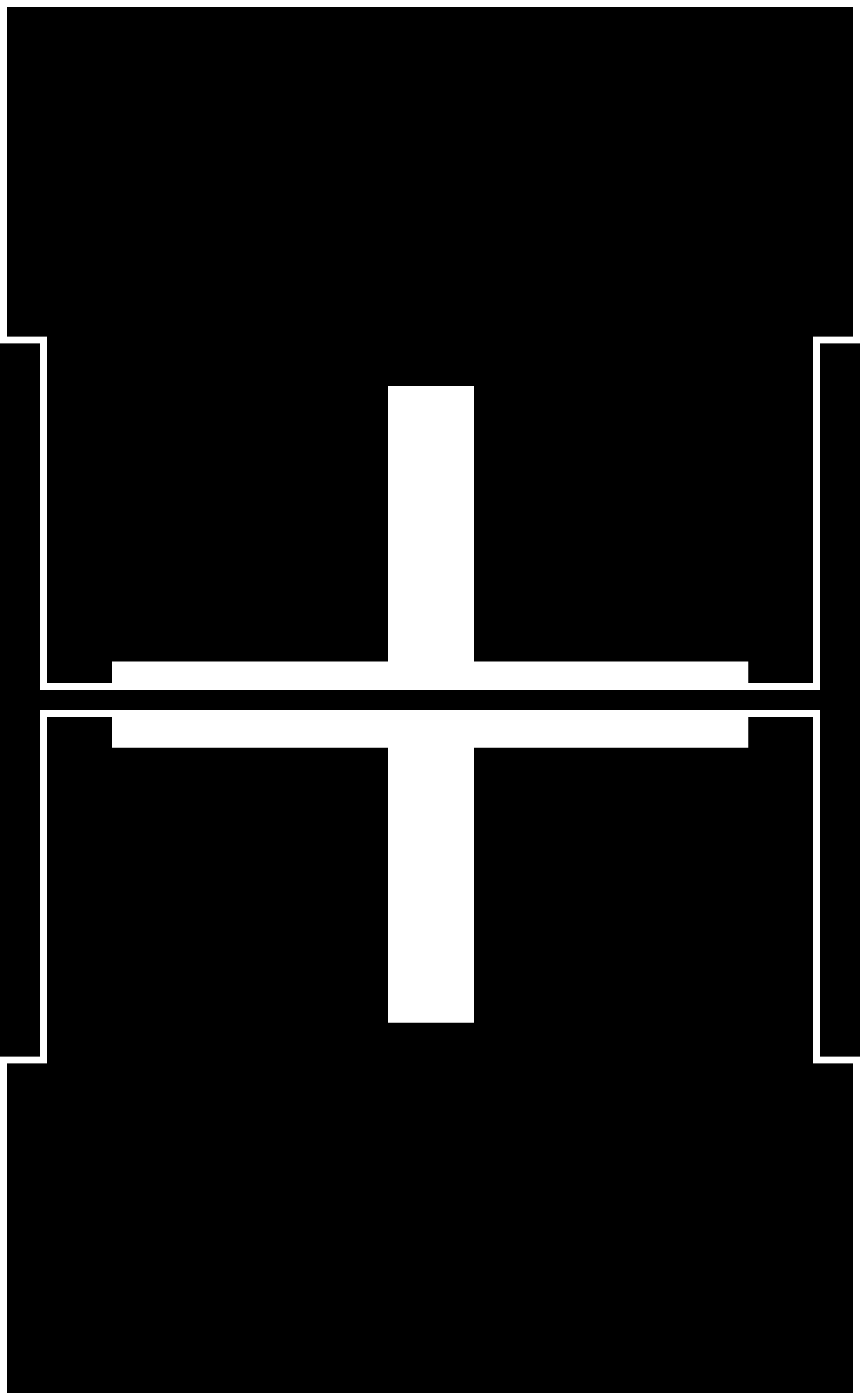
static assets/Text Flaps/Flap 49 plus/Flap 49 plus split_flap_view.png
