rsmithamazon/F1Tower/static assets/Text Flaps/Flap 50 mph/Flap 50 mph split_flap_view.png

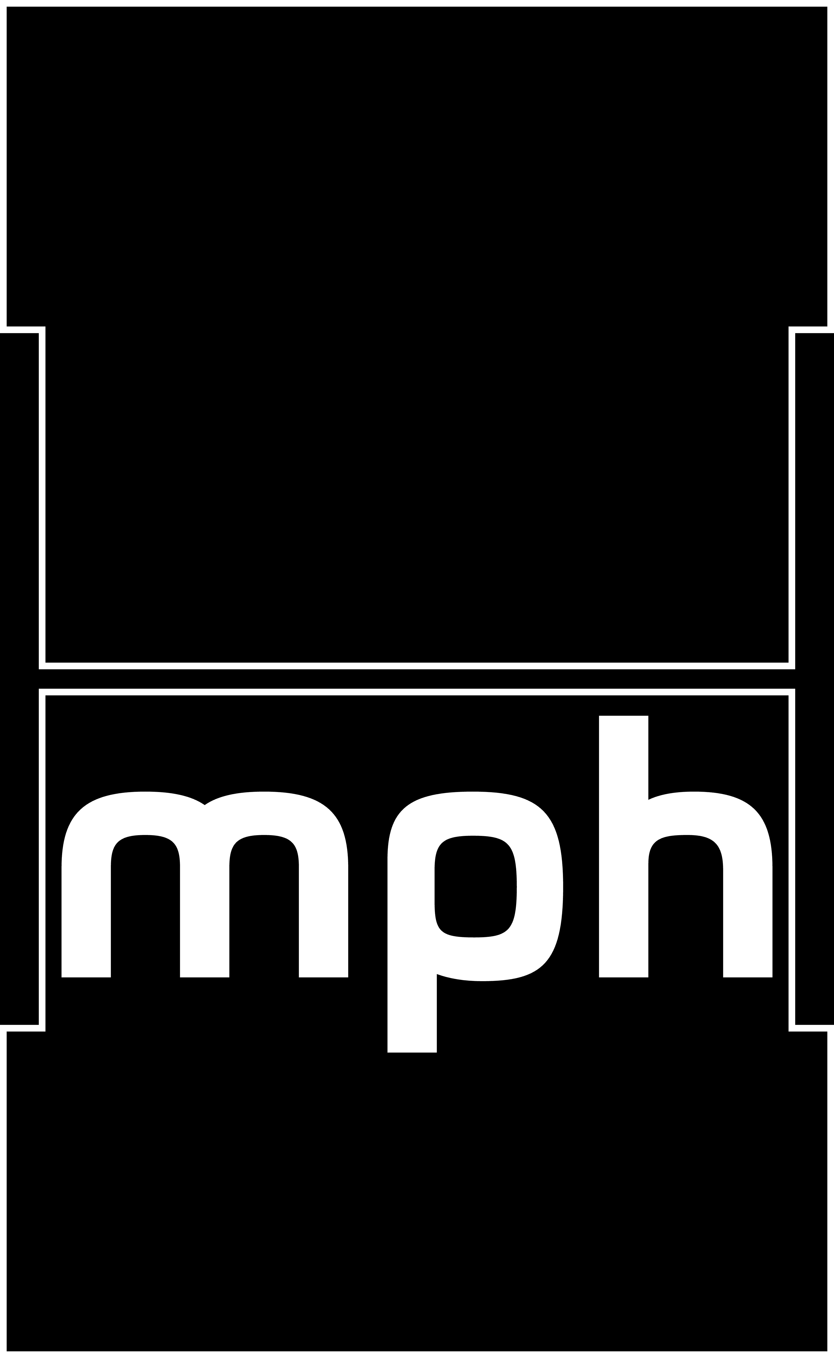
static assets/Text Flaps/Flap 50 mph/Flap 50 mph split_flap_view.png
