rsmithamazon/F1Tower/static assets/Text Flaps/Flap 50 slash/Flap 50 slash split_flap_view.png

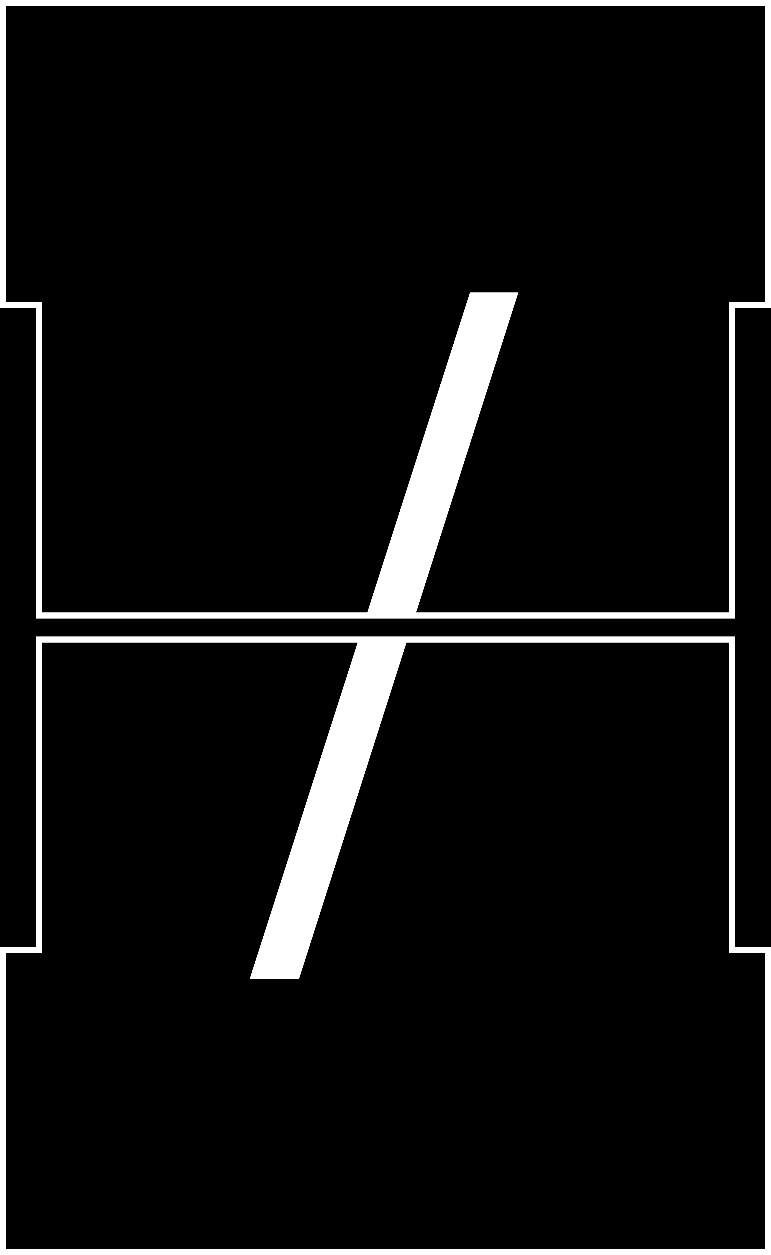
static assets/Text Flaps/Flap 50 slash/Flap 50 slash split_flap_view.png
