rsmithamazon/F1Tower/static assets/WX/Cloudy Split Flap View.png

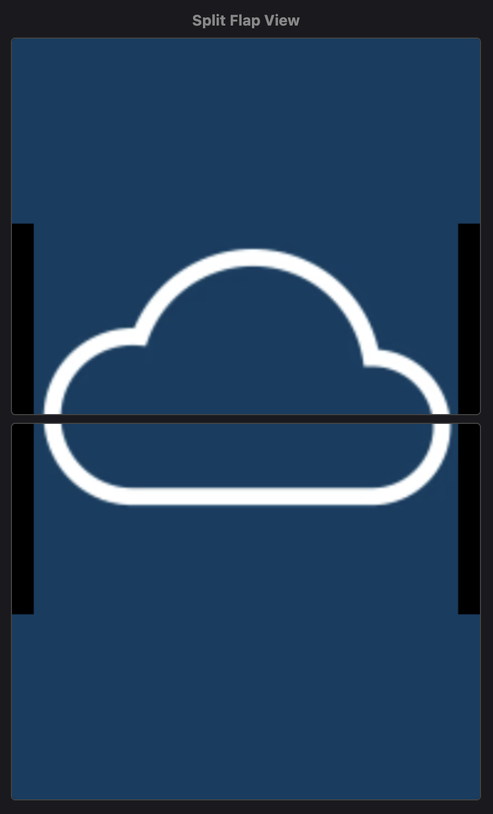
static assets/WX/Cloudy Split Flap View.png
