rsmithamazon/F1Tower/TODO.txt

1. CutSheet
    1. Order Flaps 

2. HW validation
    1. Magnets/Hall Sensor
    2. Motors
    3. wiring/power

3. Assembly

4. Code
    - create flap endstates/modes
    - create tracking and movment methods
    - create transitions
