rsmithamazon/F1Tower/firmware/tests/06_acceleration_test/06_acceleration_test.ino

// ===========================================================
// TEST 06: Manual Speed / Acceleration Tuning
// ===========================================================
// Ramp test: accelerate up to TOP_SPEED, then either hold for
// SPIN_SECONDS or spin until the magnet is detected, then
// decelerate smoothly to a stop. Repeat.
//
// Edit the knobs below, re-upload, and watch/listen. Use it to
// find the fastest speed + acceleration your 28BYJ-48 runs at
// without stalling. Good values can later be baked into the
// engine's acceleration table (generate_acceleration.py).
//
// Self-contained AccelStepper rig (simple speed/accel knobs).
//
// Serial: 115200 baud. Prints settings and per-run timing.
//
// Hardware: Arduino/Pico + 1 ULN2003 + 1 28BYJ-48 (+ hall for magnet mode)
// Wiring:   coil pins IN1,IN2,IN3,IN4 = 6,7,8,9 ; hall sensor = pin 2
// ===========================================================

#include <AccelStepper.h>

// ===========================================================
// ===============  TUNE THESE KNOBS  ========================
// ===========================================================

// TOP_SPEED — steps per second the motor ramps up to.
//   HIGHER = FASTER spin (e.g. 900, 1000, 1200)
//   LOWER  = SLOWER spin (e.g. 400, 600)
//   Tested: 12V 28BYJ-48 stalls ~1300 steps/s on the heavy 3D-printed
//   flaps (worst case). Lighter PVC flaps later will have more margin.
float TOP_SPEED = 1300.0;

// ACCELERATION — how fast it ramps up/down, in steps/sec^2.
//   HIGHER = reaches top speed FASTER (snappier; too high = stall on start)
//   LOWER  = ramps up/down SLOWER and gentler
//   Not yet at the accel ceiling — room to push higher.
float ACCELERATION = 3000.0;

// SPIN_SECONDS — how long to hold TOP_SPEED before decelerating to a stop
//   (used when STOP_ON_MAGNET is false).
float SPIN_SECONDS = 5.0;

// STOP_ON_MAGNET — how each spin ends:
//   false -> hold TOP_SPEED for SPIN_SECONDS, then decel to stop
//   true  -> spin until the hall sensor detects the magnet, then stop
const bool STOP_ON_MAGNET = false;

// REVERSE — direction of spin (does not affect speed).
//   false = forward, true = backward
const bool REVERSE = true;

// ===========================================================

int  PAUSE_MS        = 1500;    // pause between runs
const long SERIAL_BAUD = 115200;
const long MAX_SPIN_STEPS = 6000;   // safety cap for magnet mode (~3 revolutions)

// --- PINS (IN1,IN3,IN2,IN4 order for correct 28BYJ-48 coil sequence) ---
const int IN1 = 6;
const int IN2 = 7;
const int IN3 = 8;
const int IN4 = 9;
const int HALL_PIN = 2;         // hall sensor (active LOW = magnet detected)
const int LED_PIN  = LED_BUILTIN;
AccelStepper stepper(AccelStepper::HALF4WIRE, IN1, IN3, IN2, IN4);

int cycleCount = 0;

void powerOff() {
    digitalWrite(IN1, LOW);
    digitalWrite(IN2, LOW);
    digitalWrite(IN3, LOW);
    digitalWrite(IN4, LOW);
}

bool isMagnetDetected() {
    bool detected = (digitalRead(HALL_PIN) == LOW);
    digitalWrite(LED_PIN, detected ? HIGH : LOW);
    return detected;
}

void setup() {
    Serial.begin(SERIAL_BAUD);
    pinMode(HALL_PIN, INPUT_PULLUP);
    pinMode(LED_PIN, OUTPUT);
    digitalWrite(LED_PIN, LOW);
    delay(1000);

    stepper.setMaxSpeed(TOP_SPEED);
    stepper.setAcceleration(ACCELERATION);

    Serial.println(F("=== MANUAL SPEED / ACCEL TUNING ==="));
    Serial.print(F("Baud:         ")); Serial.println(SERIAL_BAUD);
    Serial.print(F("TOP_SPEED:    ")); Serial.print(TOP_SPEED);    Serial.println(F(" steps/s   (higher = faster)"));
    Serial.print(F("ACCELERATION: ")); Serial.print(ACCELERATION); Serial.println(F(" steps/s^2 (higher = ramps faster)"));
    Serial.print(F("Stop mode:    "));
    if (STOP_ON_MAGNET) {
        Serial.println(F("until MAGNET detected"));
    } else {
        Serial.print(F("hold ")); Serial.print(SPIN_SECONDS); Serial.println(F(" s then decel"));
    }
    Serial.print(F("Direction:    ")); Serial.println(REVERSE ? F("REVERSE (backward)") : F("forward"));
    Serial.println(F("Edit knobs at top, re-upload to tune."));
    Serial.println();
}

void loop() {
    cycleCount++;
    int dir = REVERSE ? -1 : 1;

    Serial.print(F("Cycle ")); Serial.print(cycleCount);
    if (STOP_ON_MAGNET) {
        Serial.println(F(" — ramp up, spin until magnet, decel to stop..."));
    } else {
        Serial.print(F(" — ramp up, hold ")); Serial.print(SPIN_SECONDS); Serial.println(F(" s, decel to stop..."));
    }

    unsigned long start = millis();
    unsigned long durationMs = (unsigned long)(SPIN_SECONDS * 1000.0);
    bool stoppedByMagnet = false;

    // Phase 1: one far-away target so AccelStepper ramps up to TOP_SPEED
    // and HOLDS it (it only decelerates near a target). Run until our
    // stop condition (timer or magnet) is met.
    stepper.setCurrentPosition(0);
    stepper.move(dir * 1000000L);   // effectively "spin" during the hold phase

    while (true) {
        stepper.run();

        if (STOP_ON_MAGNET) {
            if (isMagnetDetected()) { stoppedByMagnet = true; break; }
            long moved = stepper.currentPosition();
            long absMoved = moved >= 0 ? moved : -moved;
            if (absMoved >= MAX_SPIN_STEPS) break;   // safety cap
        } else {
            if (millis() - start >= durationMs) break;
        }
    }

    // Phase 2: decelerate smoothly to a stop from full speed.
    stepper.stop();                 // sets a new target that respects ACCELERATION
    while (stepper.distanceToGo() != 0) {
        stepper.run();
    }

    unsigned long elapsed = millis() - start;
    long moved = stepper.currentPosition();
    long stepsTaken = moved >= 0 ? moved : -moved;
    float avgSpeed = (elapsed > 0) ? (1000.0 * stepsTaken / elapsed) : 0;

    if (STOP_ON_MAGNET) {
        if (stoppedByMagnet) {
            Serial.print(F("  MAGNET found after ")); Serial.print(stepsTaken); Serial.println(F(" steps"));
        } else {
            Serial.print(F("  NO magnet within ")); Serial.print(MAX_SPIN_STEPS); Serial.println(F(" steps (check sensor)"));
        }
    }
    Serial.print(F("  spun ")); Serial.print(stepsTaken);
    Serial.print(F(" steps in ")); Serial.print(elapsed);
    Serial.print(F(" ms  (avg ")); Serial.print(avgSpeed); Serial.println(F(" steps/s)"));

    powerOff();        // de-energize between runs (prevents heating)
    delay(PAUSE_MS);
}
