rsmithamazon/F1Tower/(commit log)

2026-06-17 reworked design files to accomadate smaller board
2026-06-19 Add code structure, pseudocode, specs, error codes, and project config
    [config.h, display_state.h, error_handler.h]
2026-06-19 Restructure error codes to HTTP-style (2xx/4xx/5xx)
    [error_handler.h]
2026-06-19 Add Pygame visual simulator (WebSocket server, same protocol as ESP32)
2026-07-08 Added: wiring diagram, and parts list
2026-08-18 Add hardware test scripts and Col 1-4 cut sheet folders
2026-08-19 Add flap designers, fonts, cut-sheet assets; update palette
    - Add text and color split-flap designers (simulator/) plus designer_server.py
    - Bundle Automata + Space Bold fonts (simulator/fonts/)
    - Reorder Col 0 (teams oldest->newest, tracks newest->oldest) in flap_allocation_v4
    - Update base palette hexes (red/yellow/green/blue/purple)
    - Organize Split Flap Cut Sheet into Column 0-4 with per-flap assets + flap views
    - Add .gitignore for .DS_Store/.vscode/pycache
2026-08-24 Add SVG vector sheet designers and hall sensor LED feedback
    - Add vector-sheet and vector-text-sheet designer pages
    - Support text/SVG payloads in designer_server save endpoint
    - Light onboard LED when magnet detected in magnet and position marker tests
    - Update TODO and print_sheet notes
    - Stop tracking generated __pycache__ .pyc
    - Ignore large local vector sheet exports
2026-08-29 Add accelerated motor engine and restructure tests for Arduino
    - Add table-driven acceleration engine (motor_driver.h) with generate_acceleration.py + acceleration.h, adapted from scottbez1/splitflap
    - Build around 52 flaps (flap_allocation_v4), forward-only with wraparound
    - Drop PIO stepper stub in favor of software-timed stepping (runs on Nano + Pico)
    - Port tests 02-06 to use the engine instead of AccelStepper
    - Give each test its own sketch folder (Arduino IDE/CLI requirement)
    - Add FlapMotor library so tests resolve the engine include
    - Ignore firmware/build artifacts
    [01_magnet_sensor_test.ino, 02_motor_speed_test.ino, 03_home_and_goto_test.ino, 04_multi_flap_cycle_test.ino, 05_position_marker_test.ino, 06_acceleration_test.ino, generate_acceleration.py]
2026-08-29 Make test sketches self-contained for Arduino IDE
    - Copy motor_driver.h + acceleration.h into each engine test folder (02-06)
    - Switch includes to local "motor_driver.h" so sketches compile with no
    library install (open the .ino and upload)
    - Remove the FlapMotor library that required manual installation
2026-08-29 Add reverse-direction flag and richer serial output to test 06
    - Add REVERSE_DIRECTION flag to motor_driver.h: flips physical spin by
    reversing the half-step phase order, position logic unchanged
    - Test 06: enable reverse, print direction + baud + per-move detail
    (start/target, forward distance, live position, elapsed) at 115200
    - Sync engine header copies into all test folders
    [06_acceleration_test.ino, motor_driver.h]
2026-08-29 Fix 28BYJ-48 coil order causing slow/stuttering motion
    Half-step sequence must drive coils A,C,B,D. Engine used straight pin
    order 6,7,8,9 which energized coils out of order (motor crawled instead
    of spinning). Swap middle two pins per motor to 6,8,7,9 etc., matching
    the known-good AccelStepper wiring. Sync header into all test folders.
    [motor_driver.h]
2026-08-29 Rework test 06 into manual speed/accel tuning with continuous spin
    - Replace table-driven engine test with self-contained AccelStepper rig
    - Expose TOP_SPEED / ACCELERATION knobs with higher=faster comments
    - Spin continuously each cycle: stop on magnet, or after SPIN_SECONDS (default 5)
    - Add REVERSE flag and per-spin timing/avg-speed serial output at 115200
    - Remove now-unused engine header copies from the 06 folder
    [06_acceleration_test.ino, motor_driver.h]
2026-08-29 Simplify test 06 to ramp/hold/decel timing test
    - Remove magnet-stop mode; just accelerate to TOP_SPEED, hold for
    SPIN_SECONDS, then decelerate to a stop and repeat
    - Three clear knobs: TOP_SPEED, ACCELERATION, SPIN_SECONDS (+ REVERSE)
    - Fixes prior stutter (single far target holds top speed the whole time)
    [06_acceleration_test.ino]
2026-08-29 Tune test 06: 1300 speed / 3000 accel, re-add magnet stop mode
    - TOP_SPEED=1300 (tested heavy-load stall point on 3D-printed flaps)
    - ACCELERATION=3000 (still below accel ceiling)
    - Add STOP_ON_MAGNET option (default false = timed hold), hall on pin 2
    [06_acceleration_test.ino]
2026-08-29 Add test 07: position test / flap mapping
    - Visits a hardcoded list of flap positions, re-homing before each move
    (spins forward through magnet, then continues past to the target flap)
    so positions are absolute and repeatable from any start
    - Hand-editable flapSteps[52] table (even spacing default) to fine-tune
    each flap's exact step position
    - Reuses tuned 1300/3000 speed/accel, REVERSE=true; slow homing speed
    [07_position_test.ino]
2026-08-29 Add flap_positions.json master map; test 07 uses explicit table
    - flap_positions.json: source of truth for flap->step positions, with
    default even spacing and per-unit override structure (steps primary,
    rev fraction for readability)
    - Test 07: replace computed spacing with an explicit editable flapSteps[]
    table matching the JSON default; copy tuned values back into the JSON
    [07_position_test.ino]
2026-08-29 Test 07: home at run speed, print flap position table to serial
    - Remove separate slow homing speed; home at TOP_SPEED/ACCELERATION
    - Add printFlapTable() dumping flap:steps:rev for the whole mapping at startup
2026-08-29 Fix test 07 slow homing crawl
    Homing stepped one step at a time (move(1) + wait), so AccelStepper
    ramped up/down per step and never built speed. Use one far target with
    run() in a loop, breaking when the magnet triggers — homes at full speed
    like test 06.
    [07_position_test.ino]
2026-08-29 Fix test 07 homing getting stranded on start magnet
    Drum starts on the home magnet, so homing triggered instantly/erratically.
    Now travel a fixed CLEAR_ZONE (300 steps) past the magnet before trusting
    the sensor, then search at full speed and stop at the magnet edge (no decel
    past it, which would shift all flap positions).
    [07_position_test.ino]
2026-08-29 Fix test 07 homing failing before a full revolution
    - Roll off the start magnet only while it's still detected (not a blind
    300-step skip that could pass a narrow magnet)
    - Reset counter after roll-off and raise MAX_HOME_STEPS to ~1.5 revs so a
    slightly-missed edge still completes a full search loop
    [07_position_test.ino]
